masteravinashdubey/2022-SBR-Development/PPT Content/Design_V1.PNG

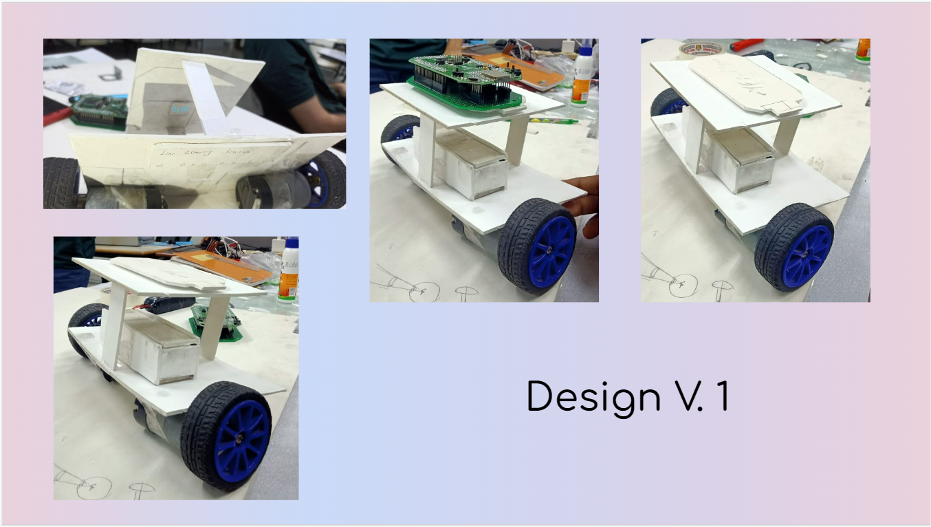
PPT Content/Design_V1.PNG
