masteravinashdubey/2022-SBR-Development/PPT Content/Design_V2.PNG

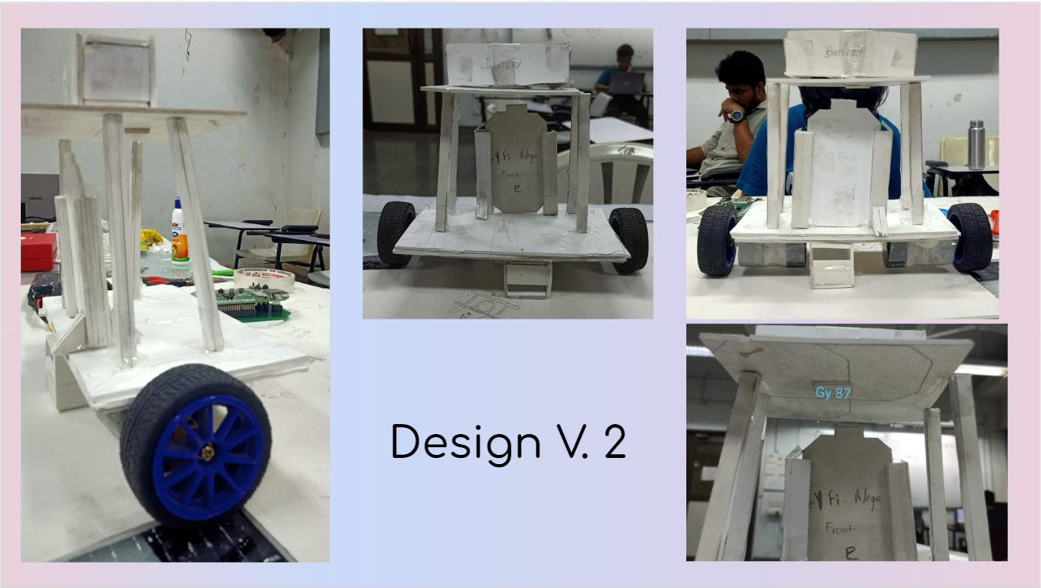
PPT Content/Design_V2.PNG
