masteravinashdubey/2022-SBR-Development/PPT Content/Design_V3.PNG

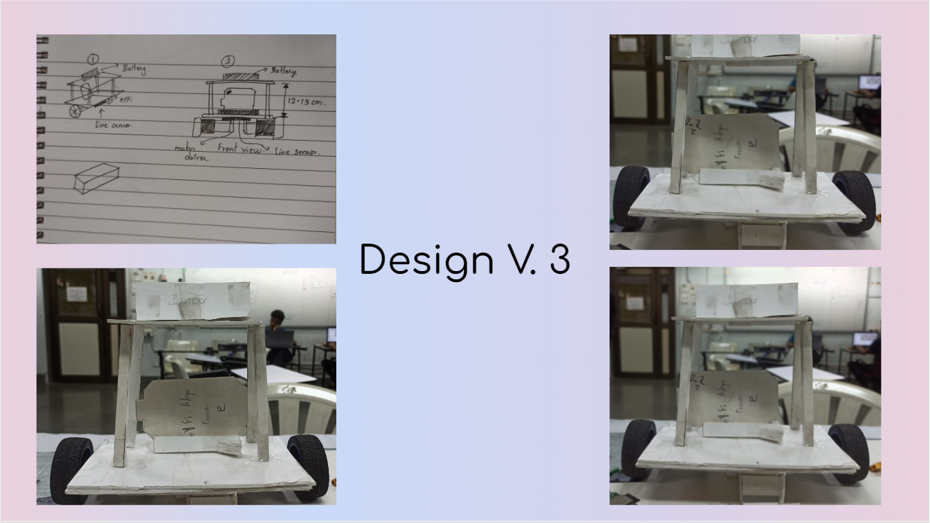
PPT Content/Design_V3.PNG
