masteravinashdubey/2022-SBR-Development/PPT Content/Design_V4.PNG

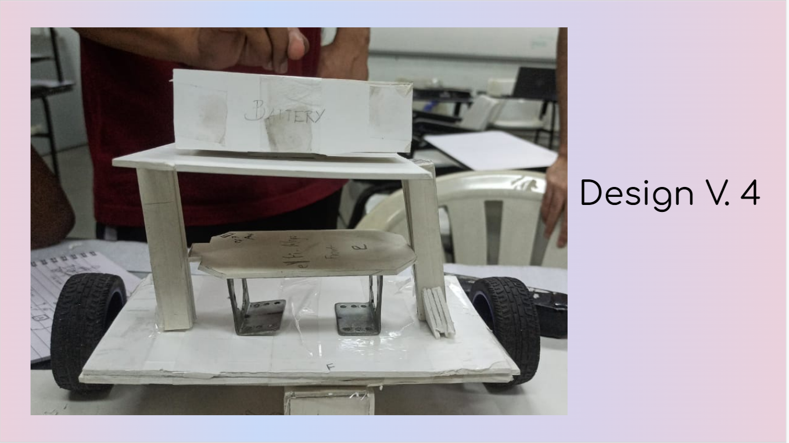
PPT Content/Design_V4.PNG
