masteravinashdubey/2022-SBR-Development/PPT Content/Design_V5.PNG

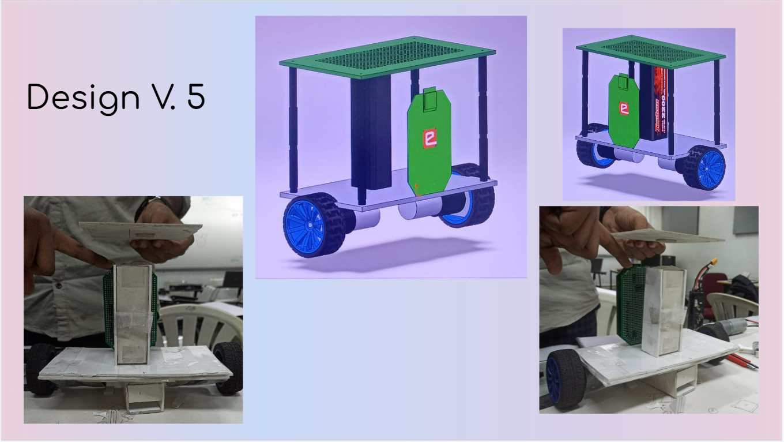
PPT Content/Design_V5.PNG
