masteravinashdubey/2022-SBR-Development/PPT Content/Design_V6.PNG

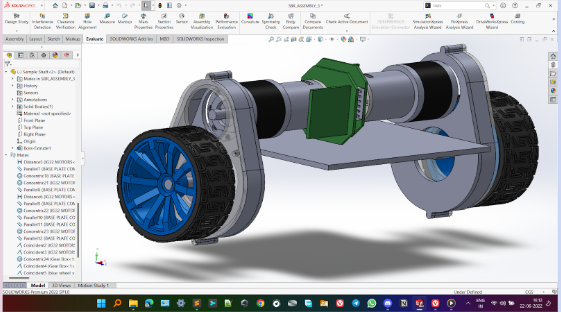
PPT Content/Design_V6.PNG
