masteravinashdubey/2022-SBR-Development/PPT Content/Design_V7.PNG

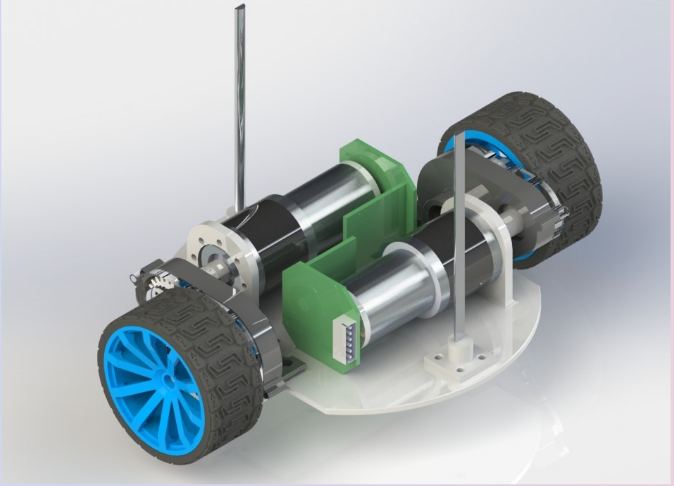
PPT Content/Design_V7.PNG
