masteravinashdubey/2022-SBR-Development/PPT Content/Final_1.png

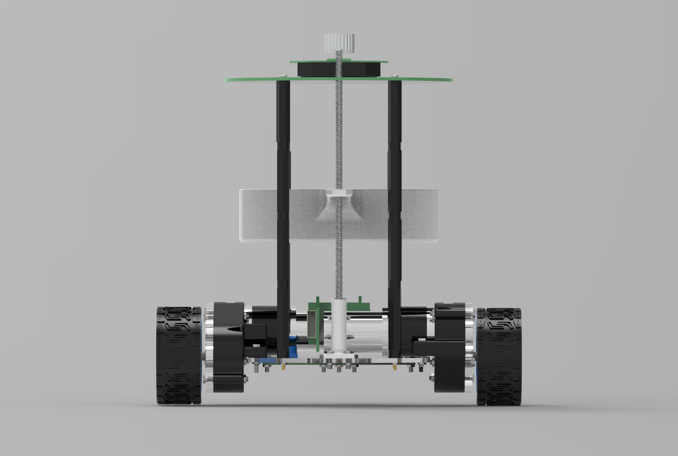
PPT Content/Final_1.png
