masteravinashdubey/2022-SBR-Development/PPT Content/Final_2.png

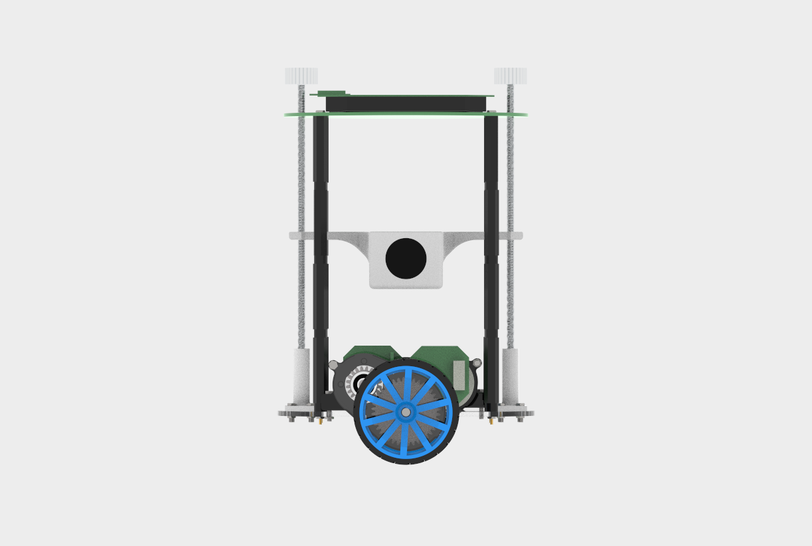
PPT Content/Final_2.png
