masteravinashdubey/2022-SBR-Development/PPT Content/Final_3.png

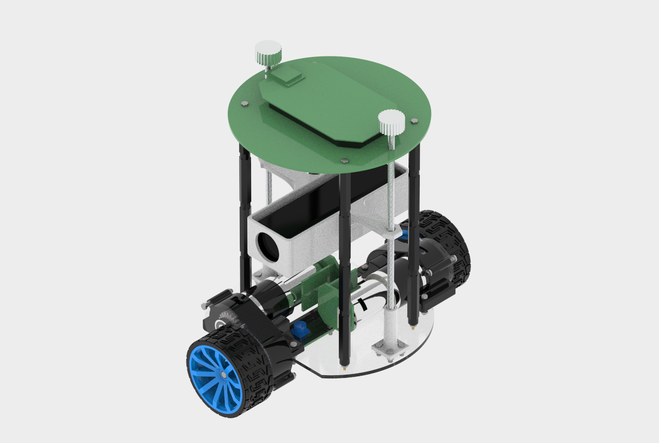
PPT Content/Final_3.png
