masteravinashdubey/2022-SBR-Development/PPT Content/Final_Alignment.PNG

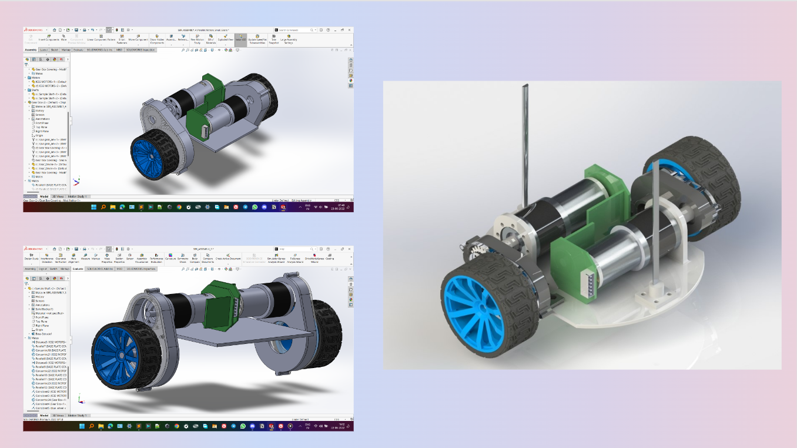
PPT Content/Final_Alignment.PNG
