masteravinashdubey/2022-SBR-Development/PPT Content/Gear_Box.jpeg

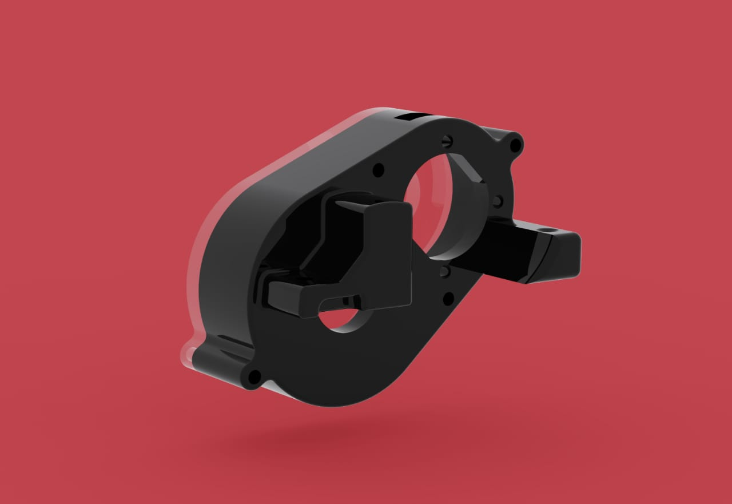
PPT Content/Gear_Box.jpeg
