masteravinashdubey/2022-SBR-Development/PPT Content/Interviews_observations.PNG

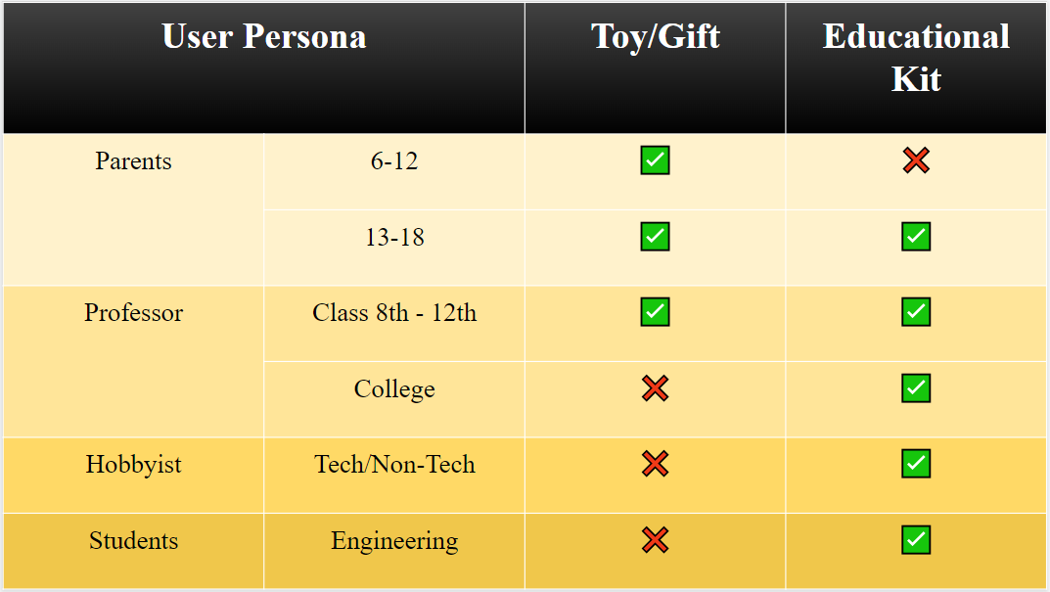
PPT Content/Interviews_observations.PNG
