masteravinashdubey/2022-SBR-Development/PPT Content/Render1.jpg

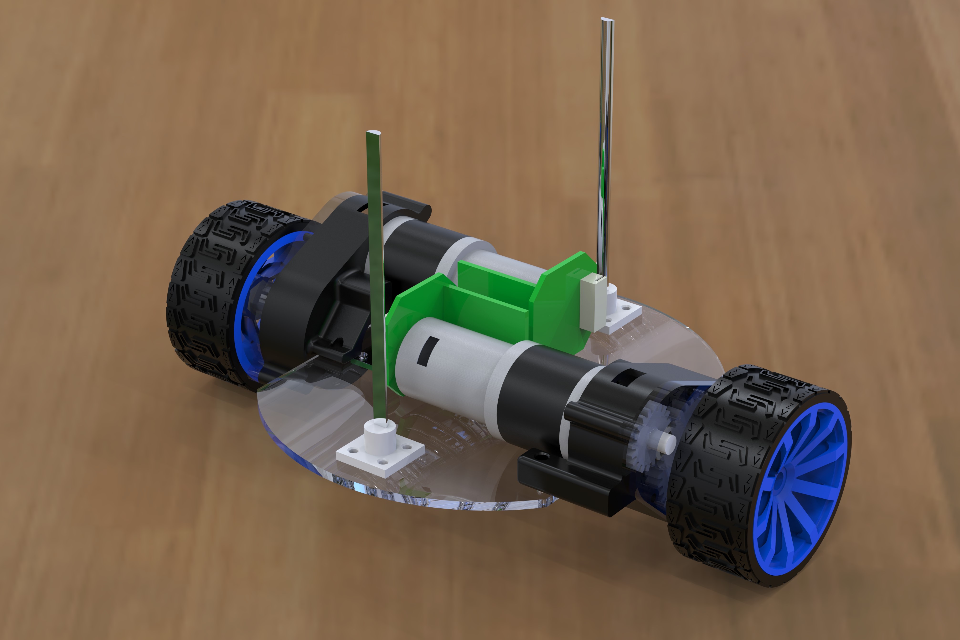
PPT Content/Render1.jpg
