masteravinashdubey/2022-SBR-Development/RENDERED/CASTLE HEAD/CastleHead.JPG

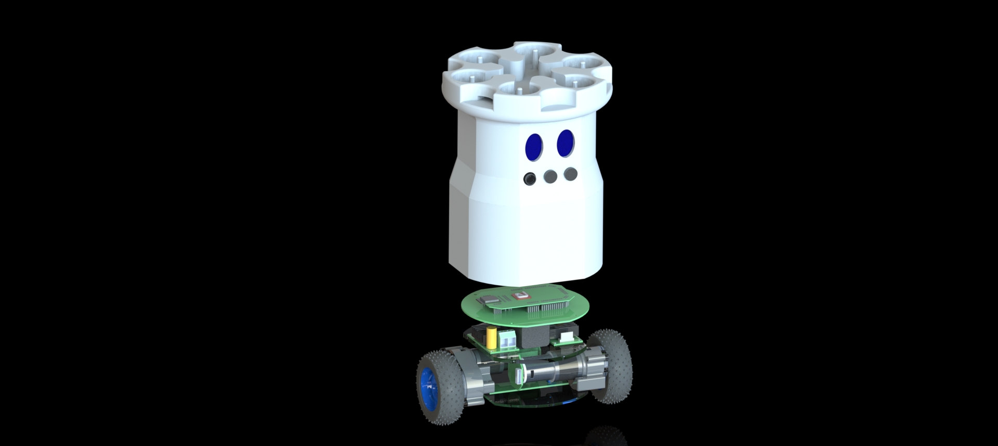
RENDERED/CASTLE HEAD/CastleHead.JPG
