masteravinashdubey/2022-SBR-Development/RENDERED/CASTLE HEAD/untitled.21.png

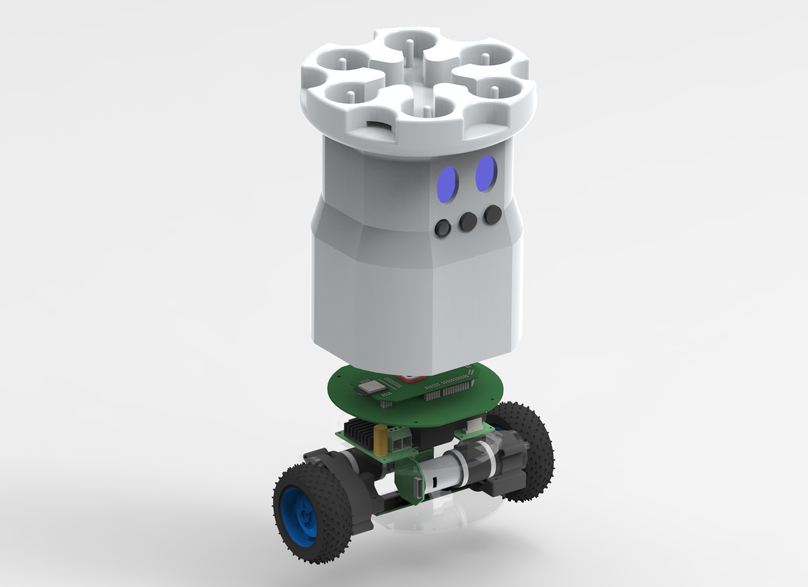
RENDERED/CASTLE HEAD/untitled.21.png
