masteravinashdubey/2022-SBR-Development/RENDERED/CASTLE HEAD/untitled.23.png

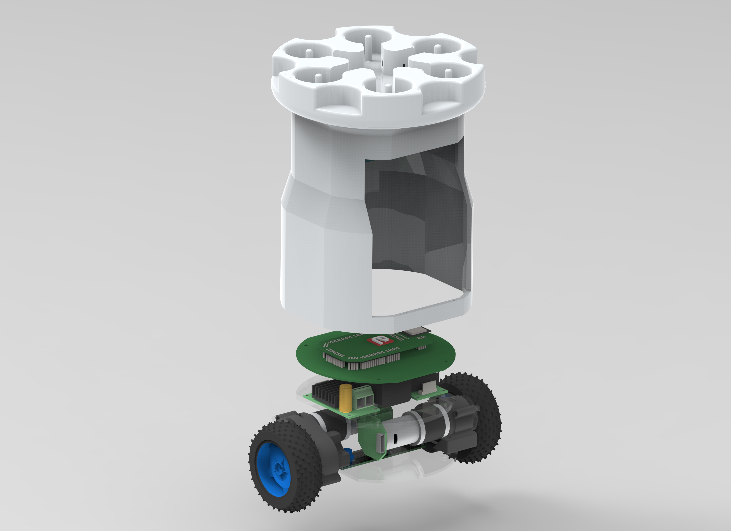
RENDERED/CASTLE HEAD/untitled.23.png
