masteravinashdubey/2022-SBR-Development/RENDERED/CASTLE HEAD/Untitled.JPG

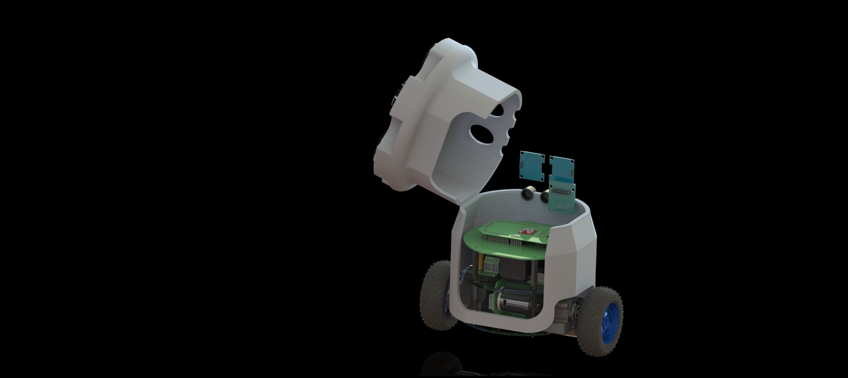
RENDERED/CASTLE HEAD/Untitled.JPG
