masteravinashdubey/2022-SBR-Development/RENDERED/COVER_1/2.png

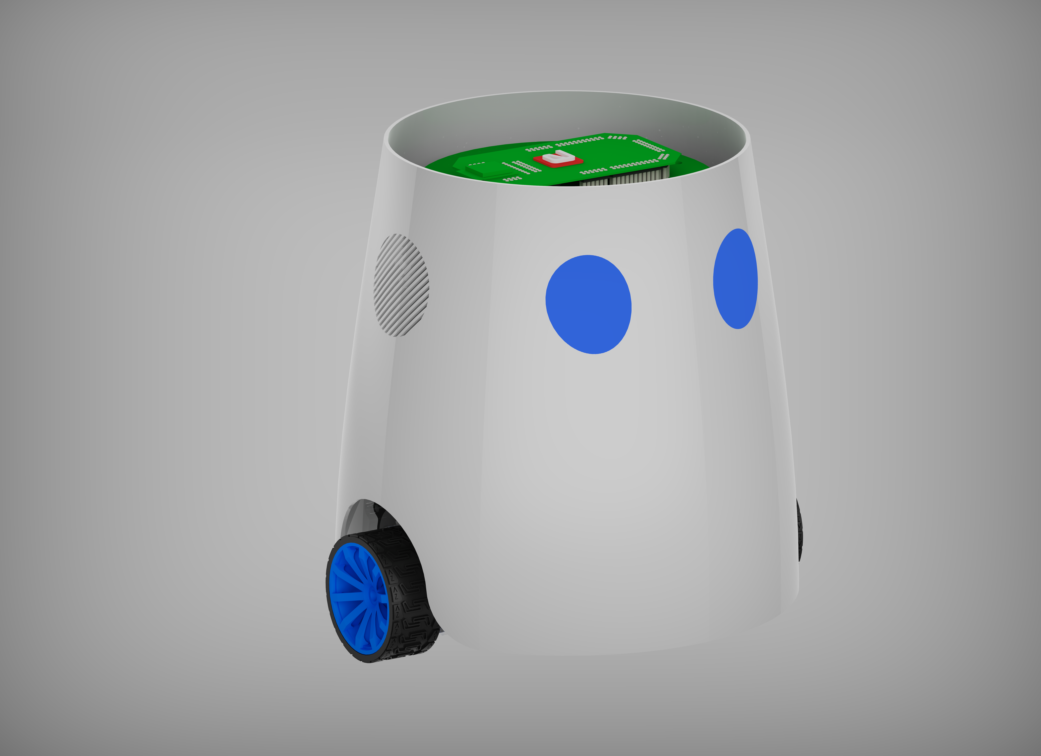
RENDERED/COVER_1/2.png
