masteravinashdubey/2022-SBR-Development/RENDERED/COVER_1/3.3.png

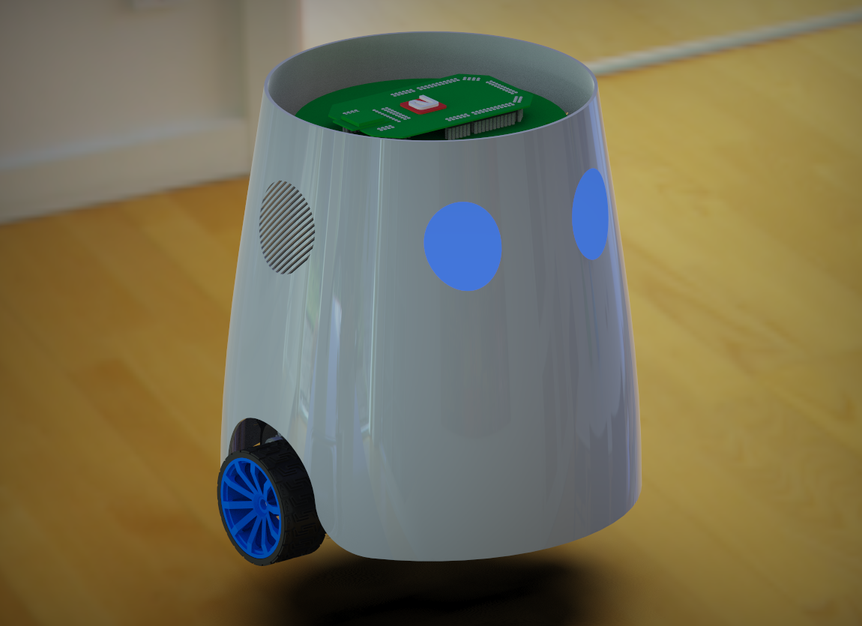
RENDERED/COVER_1/3.3.png
