masteravinashdubey/2022-SBR-Development/RENDERED/COVER_1/5.png

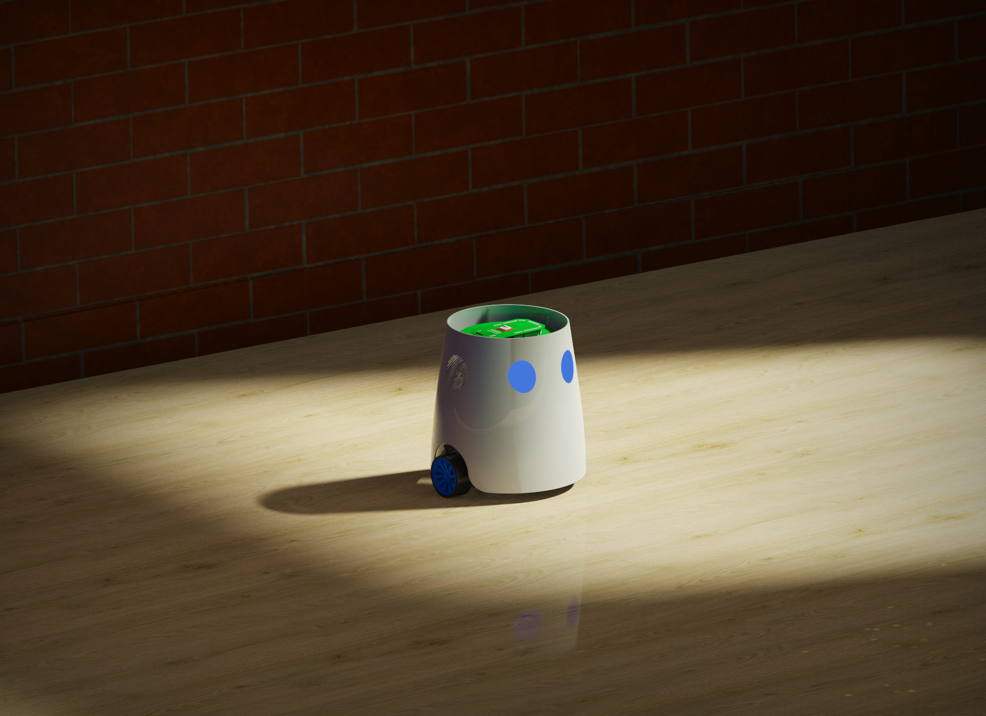
RENDERED/COVER_1/5.png
