masteravinashdubey/2022-SBR-Development/RENDERED/COVER_1/6.png

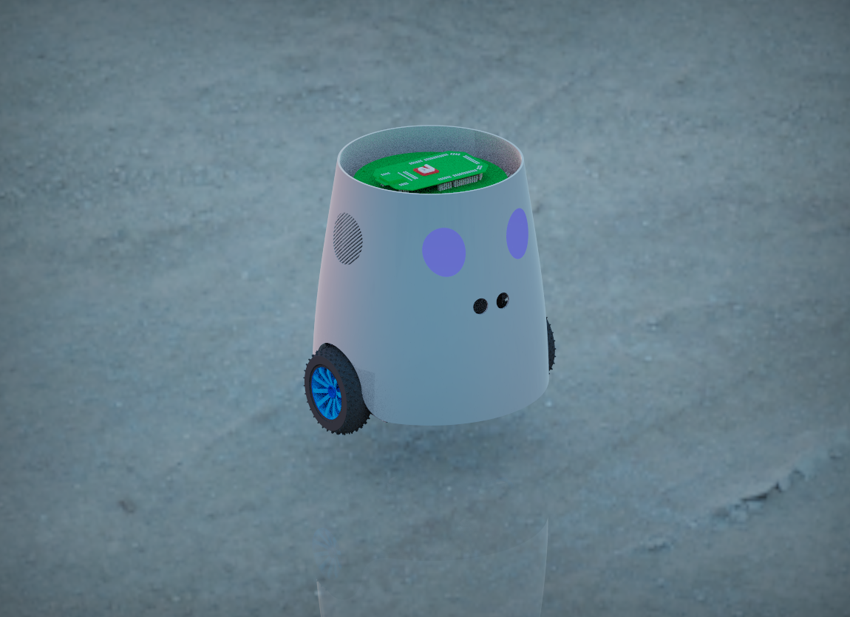
RENDERED/COVER_1/6.png
