masteravinashdubey/2022-SBR-Development/RENDERED/COVER_3/untitled.20.png

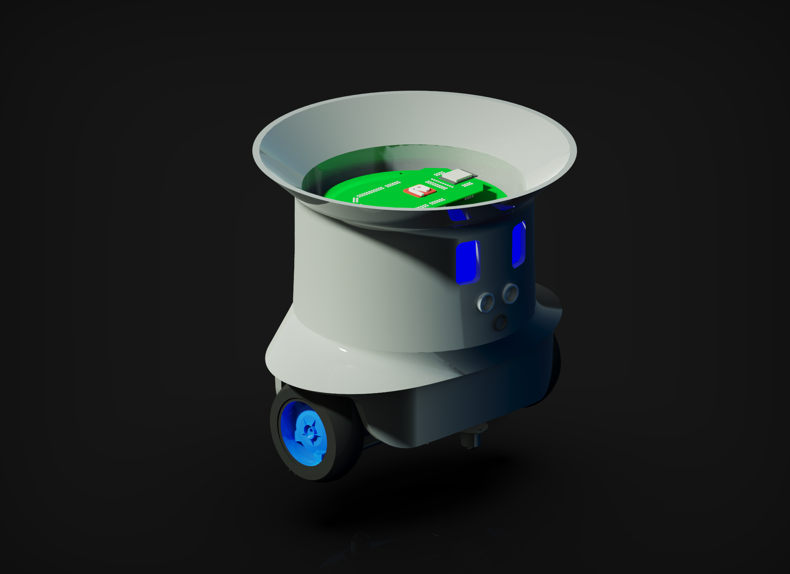
RENDERED/COVER_3/untitled.20.png
