masteravinashdubey/2022-SBR-Development/RENDERED/MISC/SBRV2.2.png

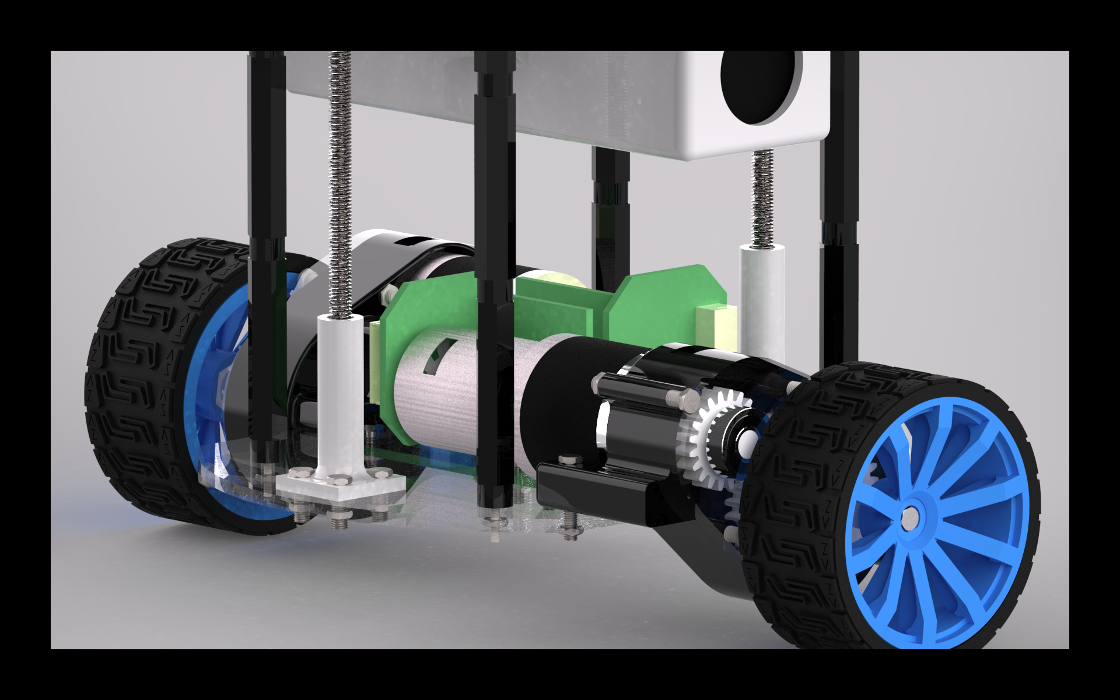
RENDERED/MISC/SBRV2.2.png
