masteravinashdubey/2022-SBR-Development/RENDERED/MISC/SBRV2.5.jpg

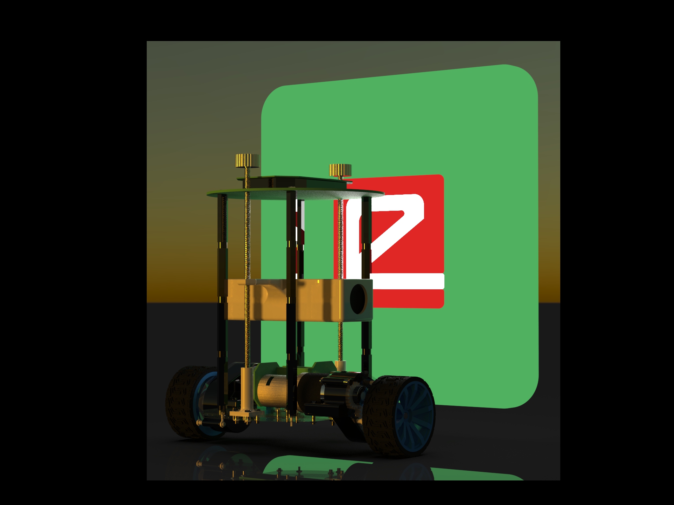
RENDERED/MISC/SBRV2.5.jpg
