masteravinashdubey/2022-SBR-Development/RENDERED/MISC/Untitled1.JPG

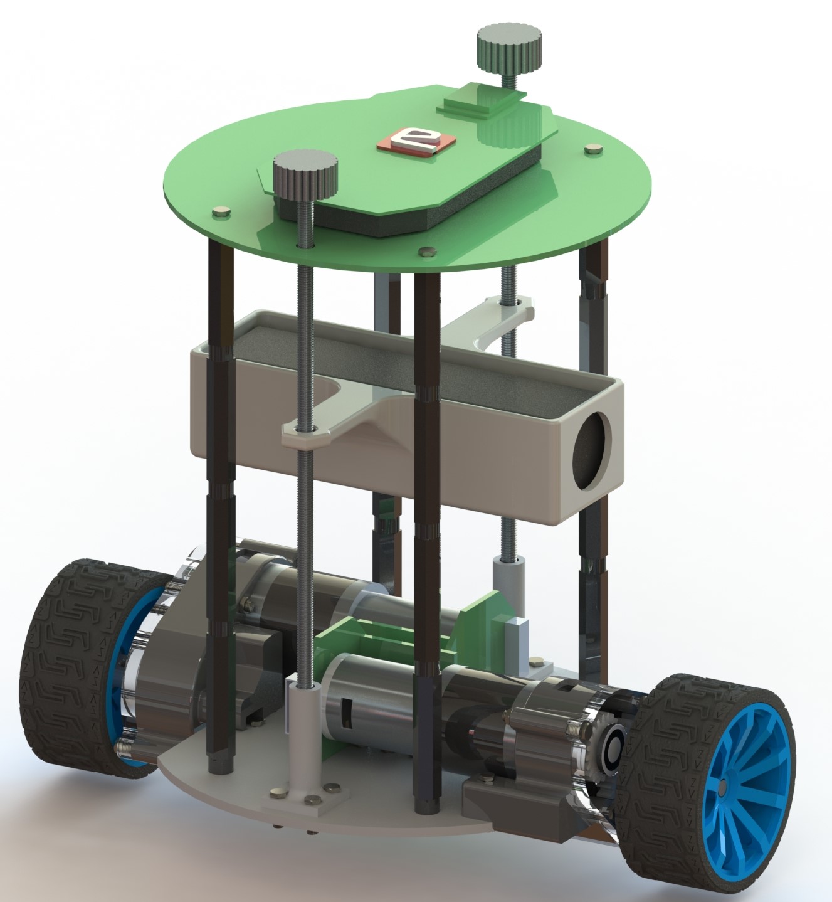
RENDERED/MISC/Untitled1.JPG
