masteravinashdubey/2022-SBR-Development/RENDERED/MISC/untitled.5.png

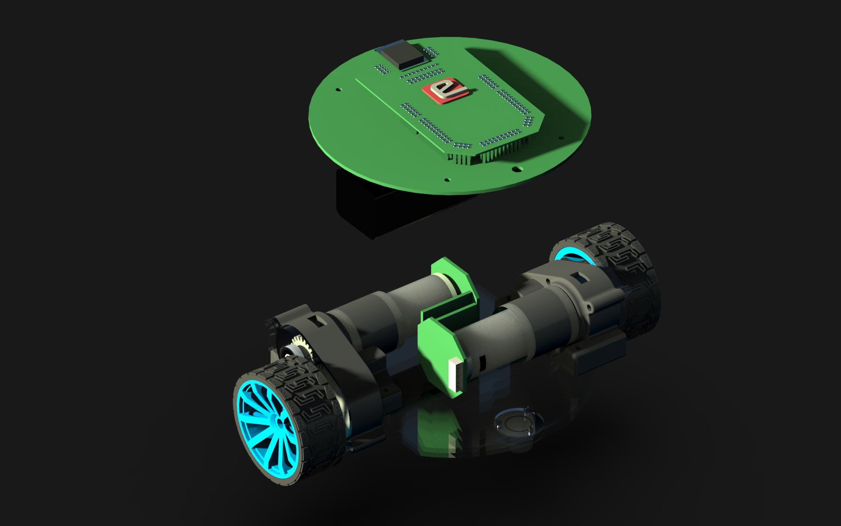
RENDERED/MISC/untitled.5.png
