masteravinashdubey/2022-SBR-Development/RENDERED/MISC/untitled.24.png

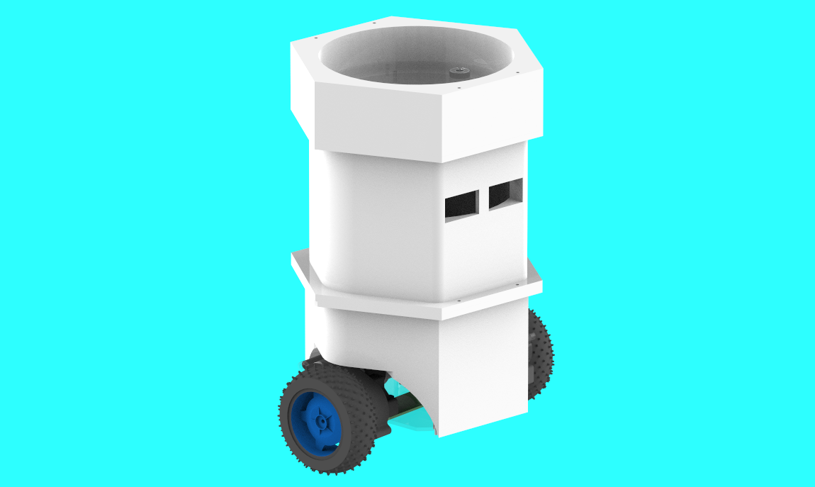
RENDERED/MISC/untitled.24.png
