masteravinashdubey/2022-SBR-Development/RENDERED/PARALLEL MOTORS/SBR_1.3.jpg

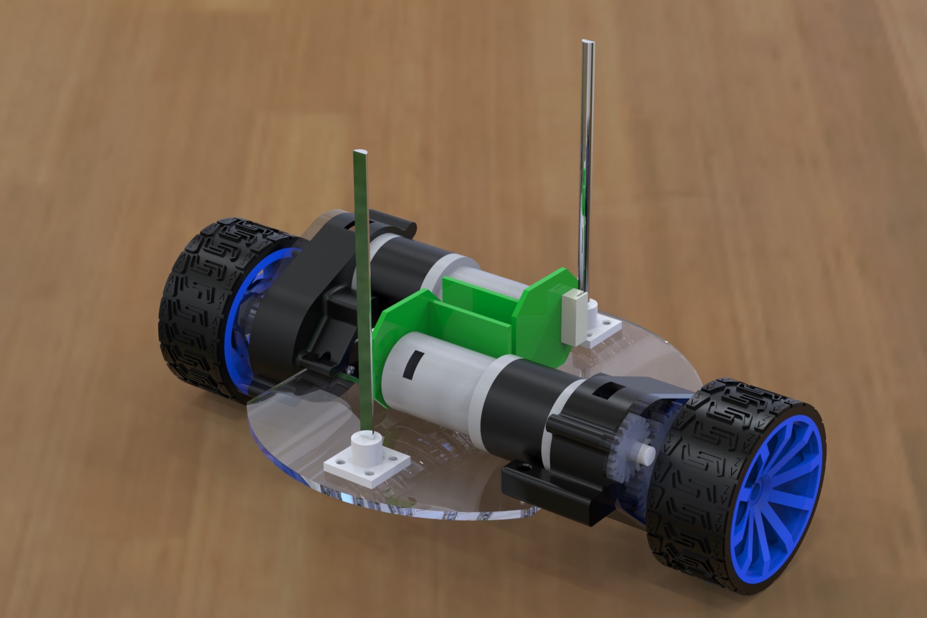
RENDERED/PARALLEL MOTORS/SBR_1.3.jpg
