masteravinashdubey/2022-SBR-Development/RENDERED/PARALLEL MOTORS/SBR_1.png

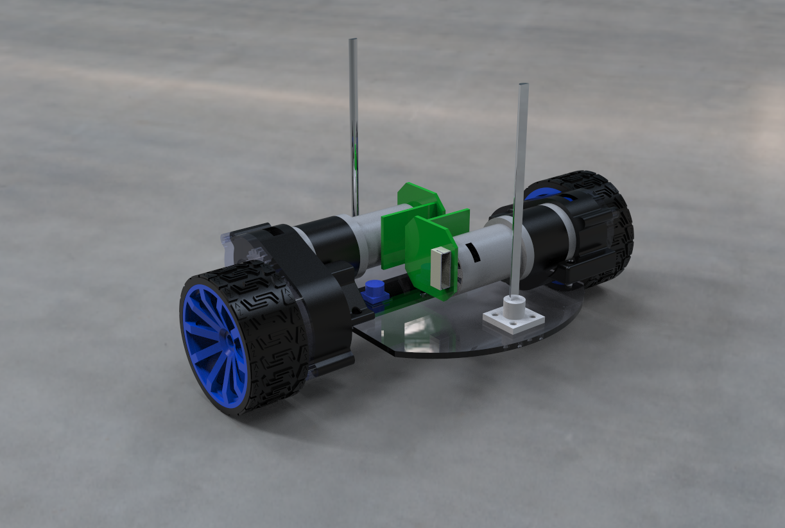
RENDERED/PARALLEL MOTORS/SBR_1.png
