masteravinashdubey/2022-SBR-Development/RENDERED/PARALLEL MOTORS/untitled.4.png

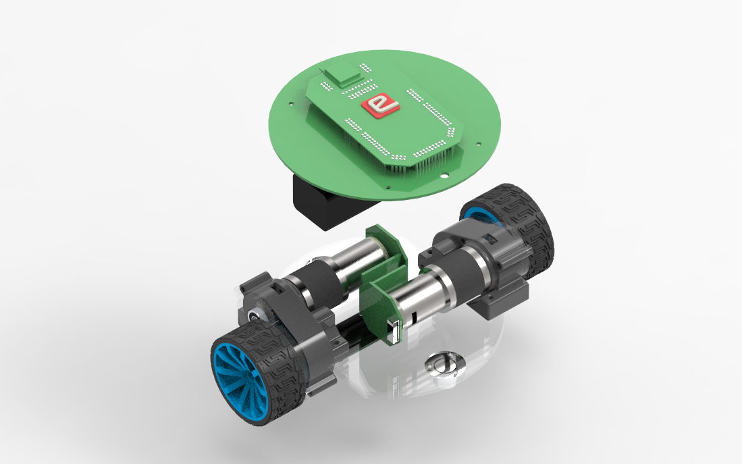
RENDERED/PARALLEL MOTORS/untitled.4.png
