masteravinashdubey/2022-SBR-Development/RENDERED/POSTER RENDERS/85mm wheel.png

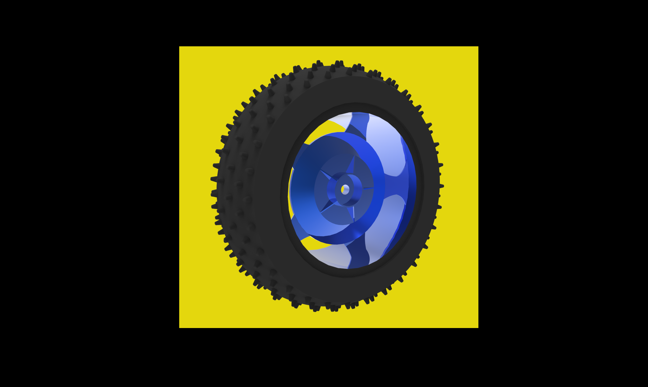
RENDERED/POSTER RENDERS/85mm wheel.png
