masteravinashdubey/2022-SBR-Development/RENDERED/POSTER RENDERS/BATTERY.png

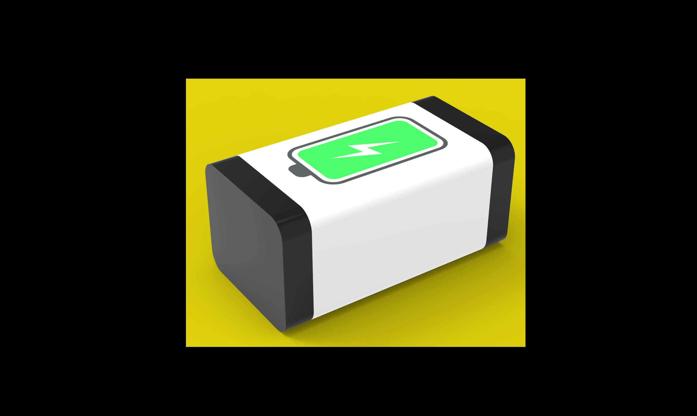
RENDERED/POSTER RENDERS/BATTERY.png
