masteravinashdubey/2022-SBR-Development/RENDERED/POSTER RENDERS/Bearing.png

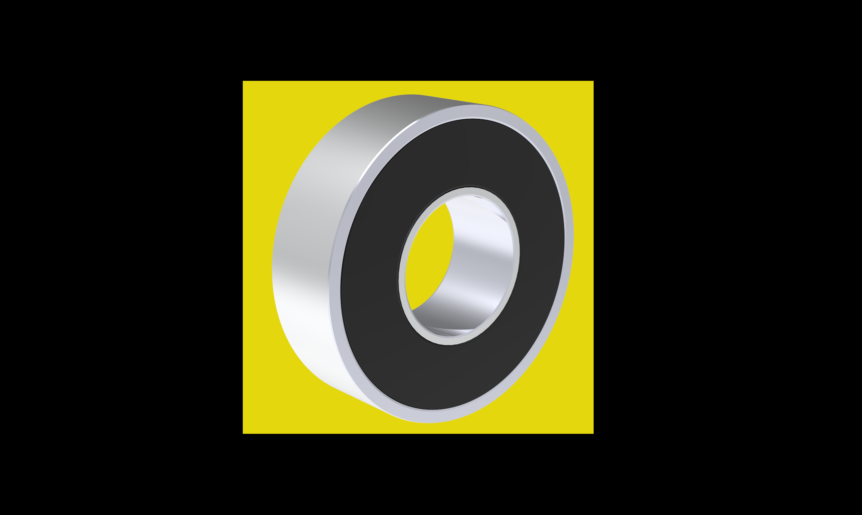
RENDERED/POSTER RENDERS/Bearing.png
