masteravinashdubey/2022-SBR-Development/RENDERED/POSTER RENDERS/BOT/SBR_FINAL.30.png

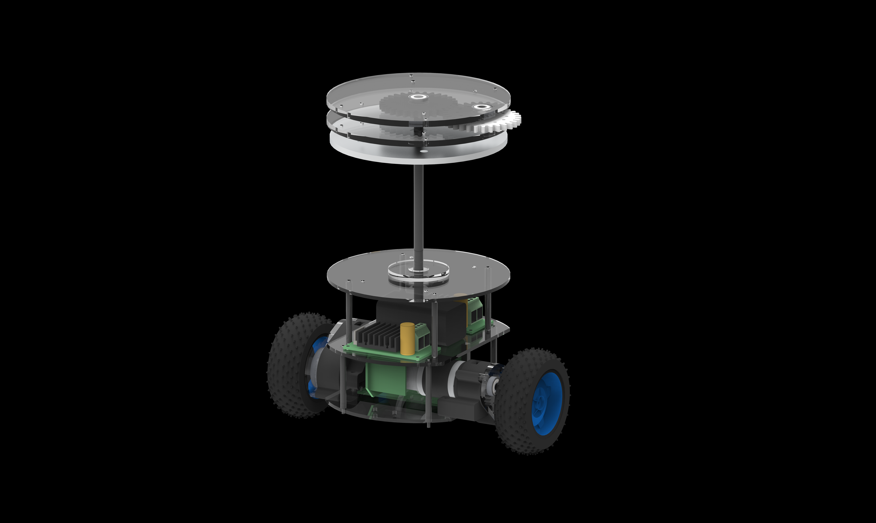
RENDERED/POSTER RENDERS/BOT/SBR_FINAL.30.png
