masteravinashdubey/2022-SBR-Development/RENDERED/POSTER RENDERS/BOT/untitled.25.png

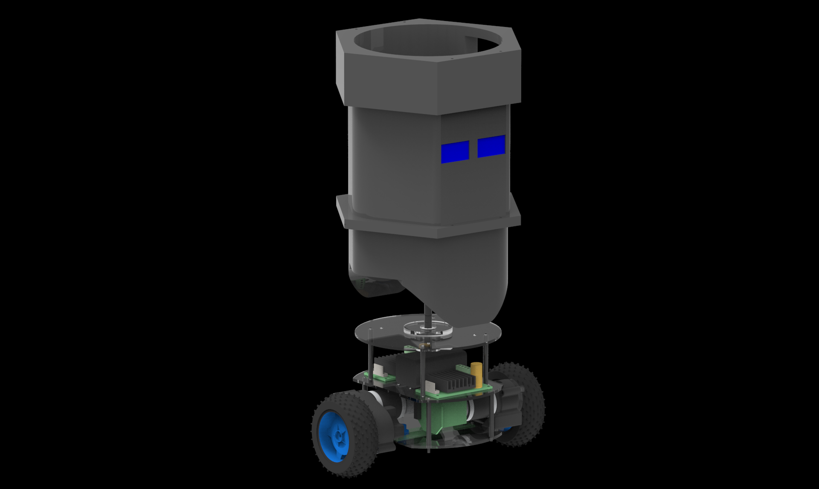
RENDERED/POSTER RENDERS/BOT/untitled.25.png
