masteravinashdubey/2022-SBR-Development/RENDERED/POSTER RENDERS/BOT/untitled.26.png

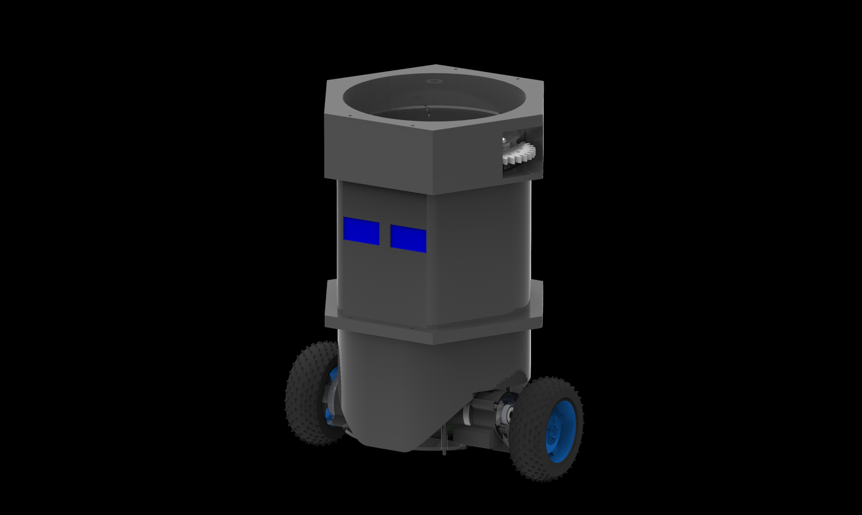
RENDERED/POSTER RENDERS/BOT/untitled.26.png
