masteravinashdubey/2022-SBR-Development/RENDERED/POSTER RENDERS/BOT/untitled.27.png

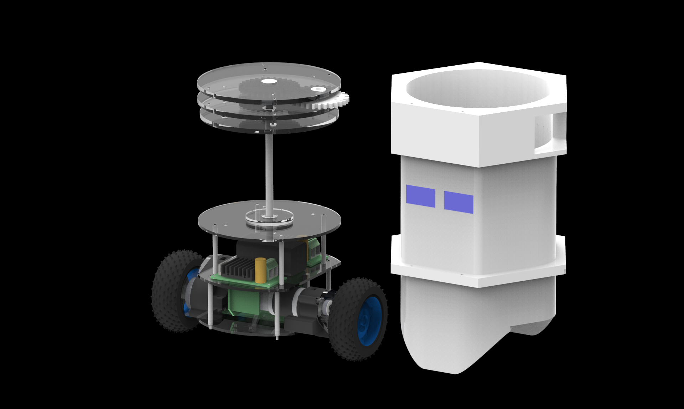
RENDERED/POSTER RENDERS/BOT/untitled.27.png
