masteravinashdubey/2022-SBR-Development/RENDERED/POSTER RENDERS/BOT/untitled.49.png

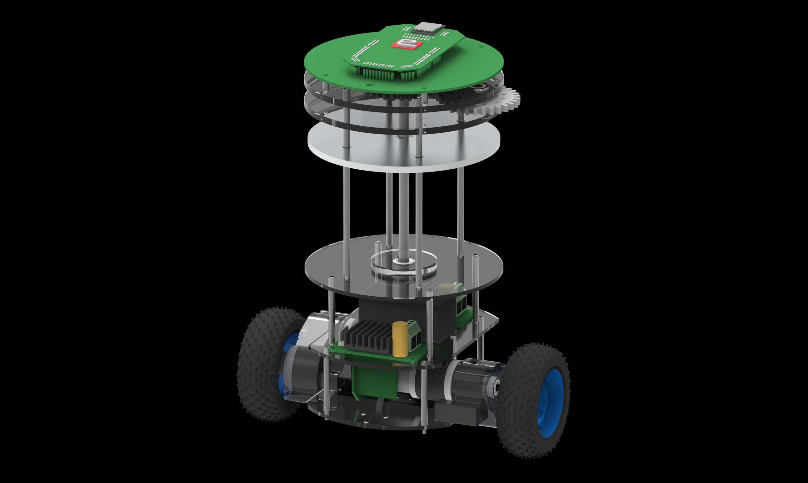
RENDERED/POSTER RENDERS/BOT/untitled.49.png
