masteravinashdubey/2022-SBR-Development/RENDERED/POSTER RENDERS/BOT/untitled.53.png

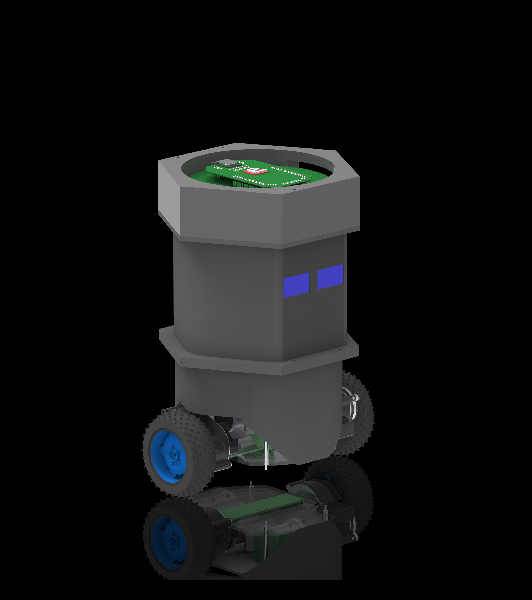
RENDERED/POSTER RENDERS/BOT/untitled.53.png
