masteravinashdubey/2022-SBR-Development/RENDERED/POSTER RENDERS/CAMERA.png

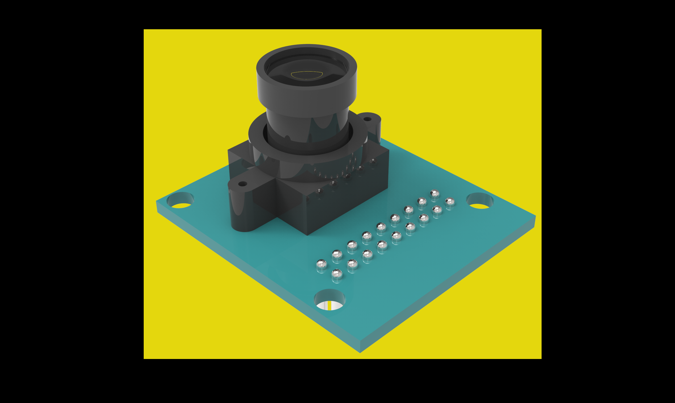
RENDERED/POSTER RENDERS/CAMERA.png
