masteravinashdubey/2022-SBR-Development/RENDERED/POSTER RENDERS/CASTOR.png

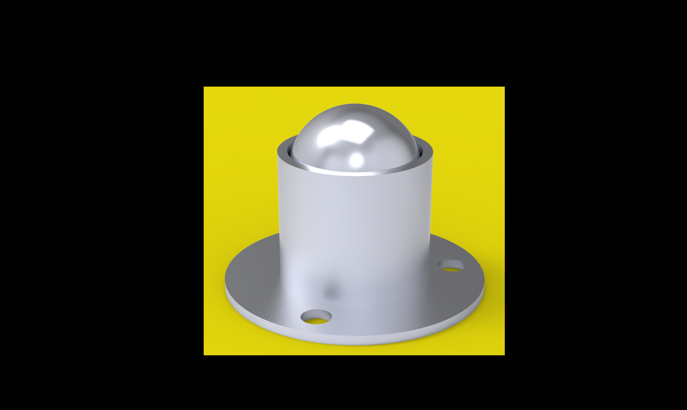
RENDERED/POSTER RENDERS/CASTOR.png
