masteravinashdubey/2022-SBR-Development/RENDERED/POSTER RENDERS/DEADWEIGHT.png

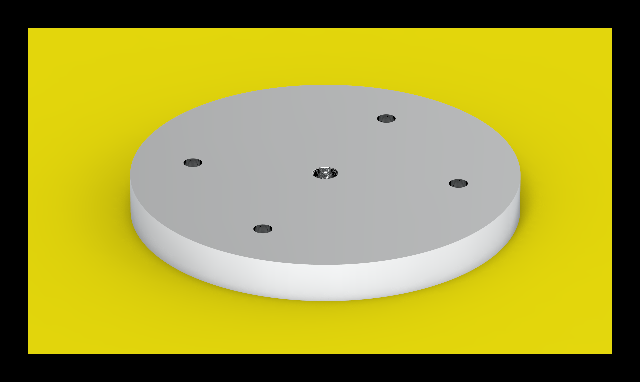
RENDERED/POSTER RENDERS/DEADWEIGHT.png
