masteravinashdubey/2022-SBR-Development/RENDERED/POSTER RENDERS/EYFI.png

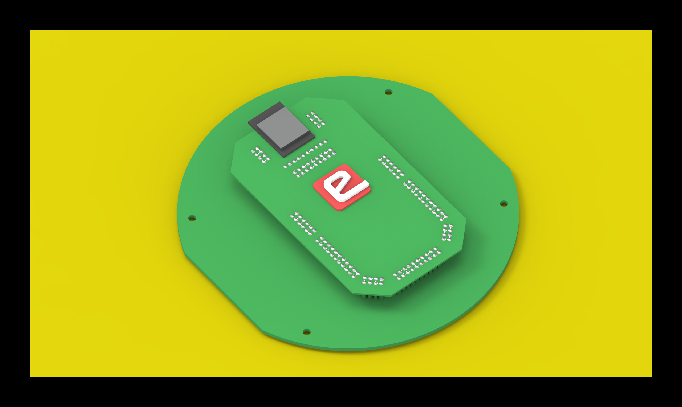
RENDERED/POSTER RENDERS/EYFI.png
