masteravinashdubey/2022-SBR-Development/RENDERED/POSTER RENDERS/GEAR_DRIVEN_LARGE.png

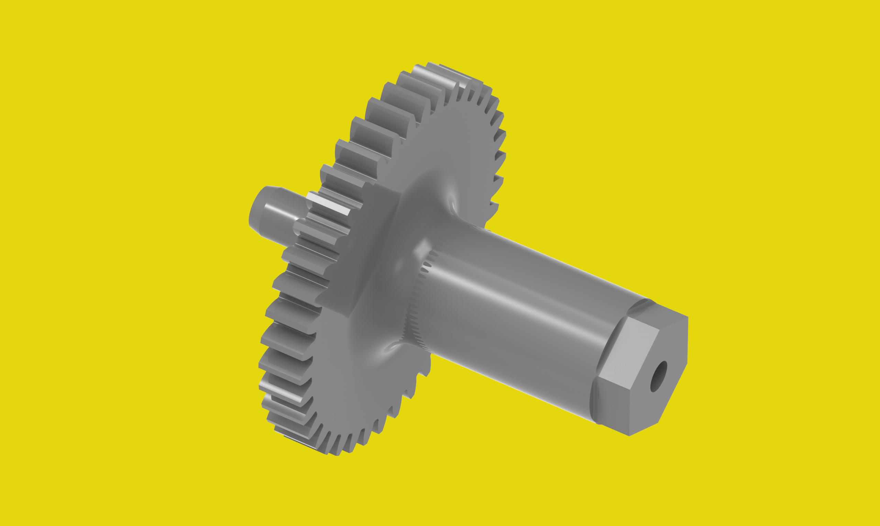
RENDERED/POSTER RENDERS/GEAR_DRIVEN_LARGE.png
