masteravinashdubey/2022-SBR-Development/RENDERED/POSTER RENDERS/GEAR_DRIVER.png

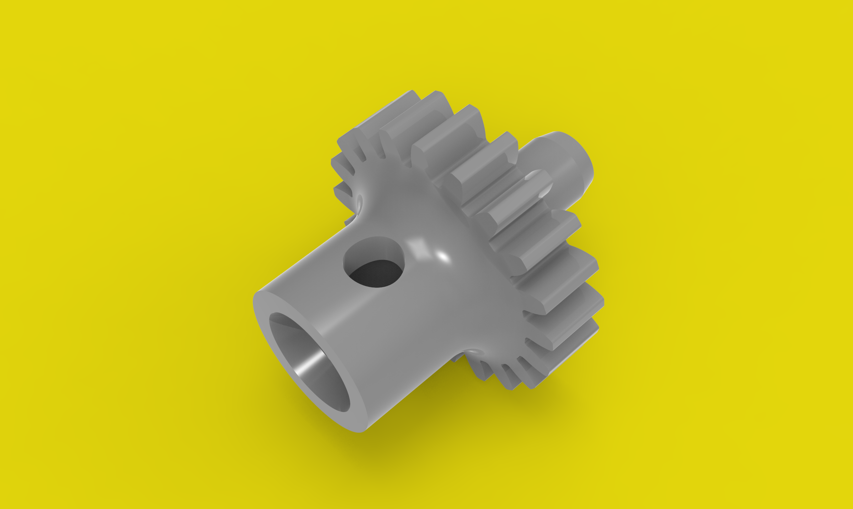
RENDERED/POSTER RENDERS/GEAR_DRIVER.png
