masteravinashdubey/2022-SBR-Development/RENDERED/POSTER RENDERS/GEARBOX.png

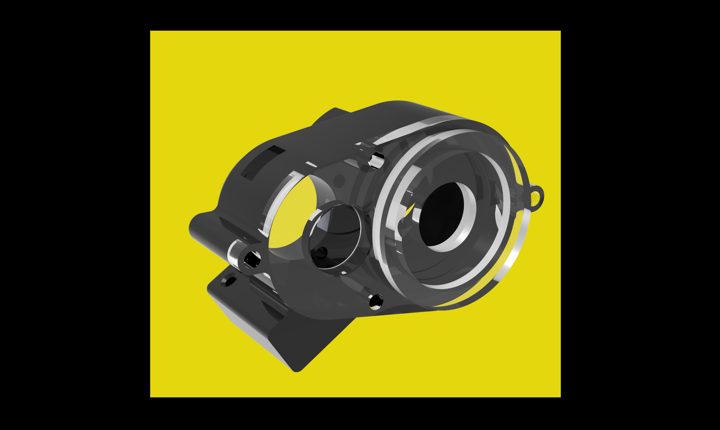
RENDERED/POSTER RENDERS/GEARBOX.png
