masteravinashdubey/2022-SBR-Development/RENDERED/POSTER RENDERS/HERCULES.png

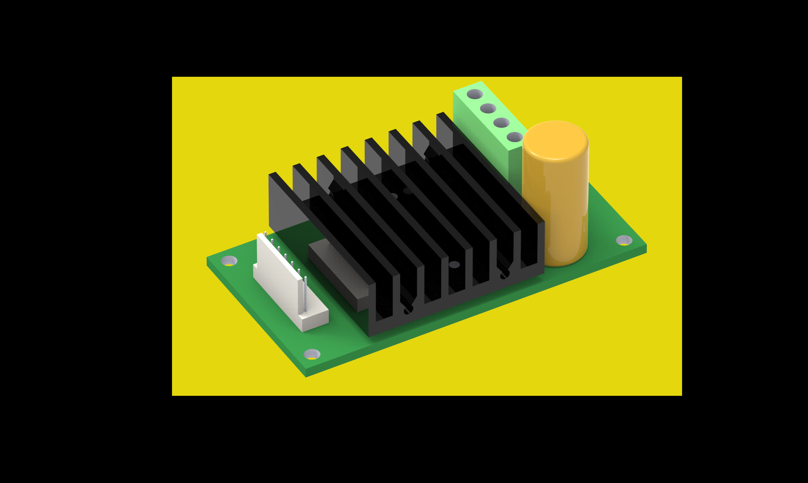
RENDERED/POSTER RENDERS/HERCULES.png
