masteravinashdubey/2022-SBR-Development/RENDERED/POSTER RENDERS/LINE SENSOR.png

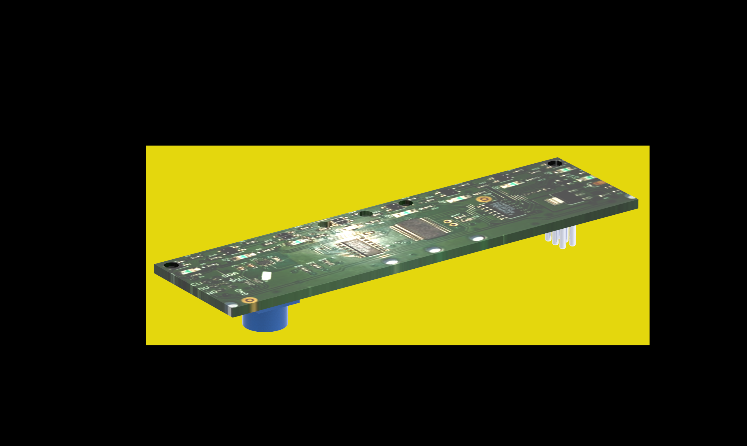
RENDERED/POSTER RENDERS/LINE SENSOR.png
