masteravinashdubey/2022-SBR-Development/RENDERED/POSTER RENDERS/MOTOR.png

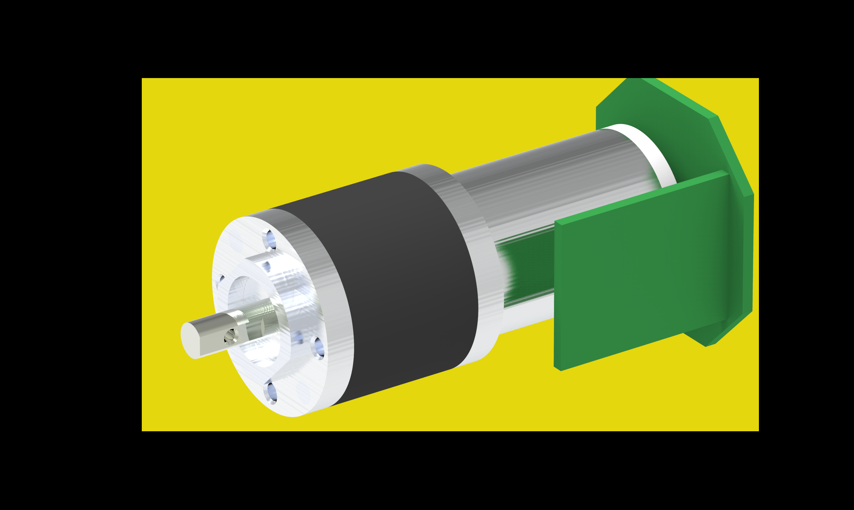
RENDERED/POSTER RENDERS/MOTOR.png
