masteravinashdubey/2022-SBR-Development/RENDERED/POSTER RENDERS/OLDE1.png

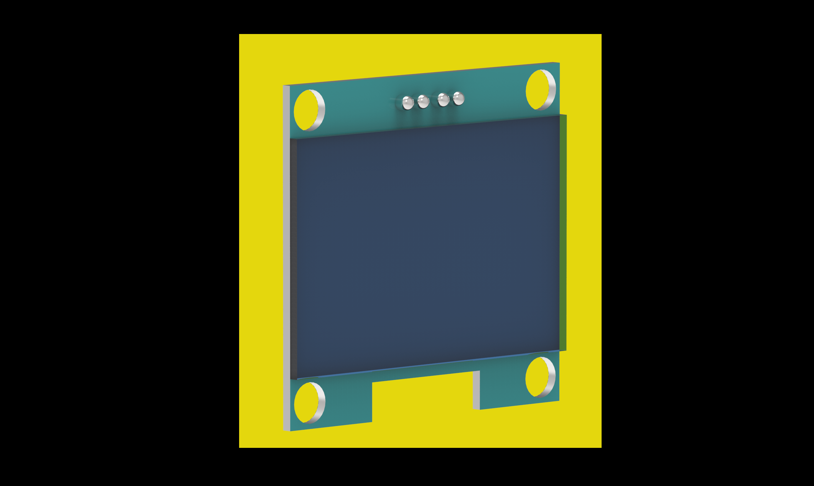
RENDERED/POSTER RENDERS/OLDE1.png
