masteravinashdubey/2022-SBR-Development/RENDERED/POSTER RENDERS/OLED2.png

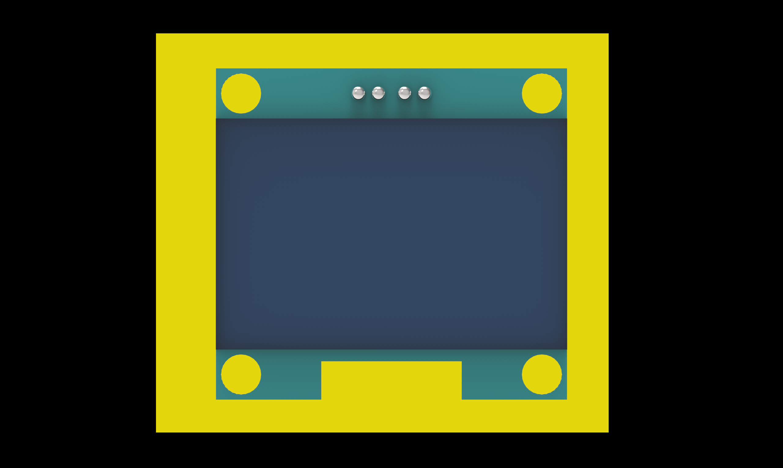
RENDERED/POSTER RENDERS/OLED2.png
