masteravinashdubey/2022-SBR-Development/Report/ATTACHING BEARING TO PLATE_3.png

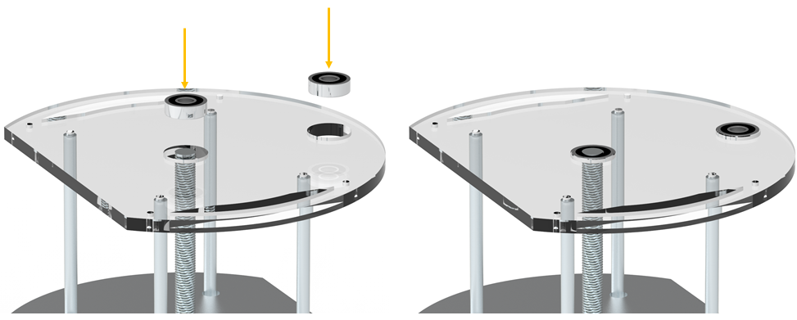
Report/ATTACHING BEARING TO PLATE_3.png
