masteravinashdubey/2022-SBR-Development/Report/ATTACHING PLATE_2.png

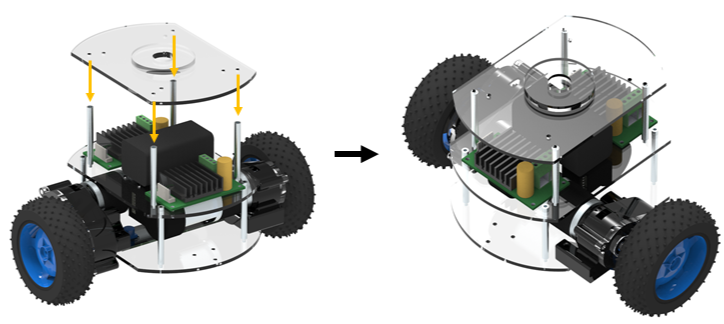
Report/ATTACHING PLATE_2.png
