masteravinashdubey/2022-SBR-Development/Report/ATTACHING PLATE_3(2) AND BEARINGS.png

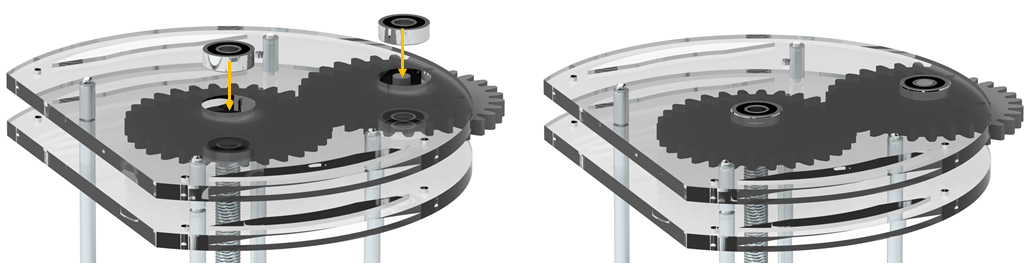
Report/ATTACHING PLATE_3(2) AND BEARINGS.png
