masteravinashdubey/2022-SBR-Development/Report/BASEPLATE ISO.196.png

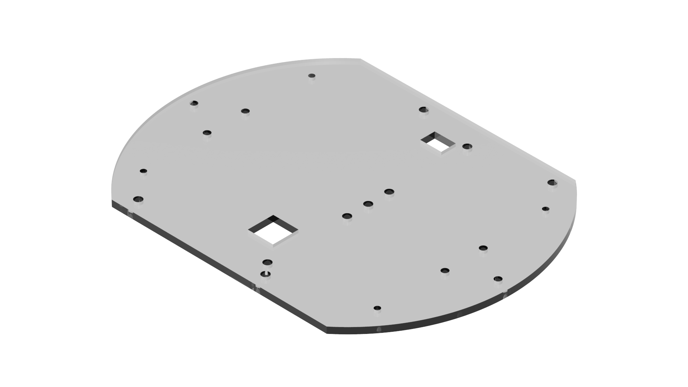
Report/BASEPLATE ISO.196.png
