masteravinashdubey/2022-SBR-Development/Report/BASEPLATE TOP.195.png

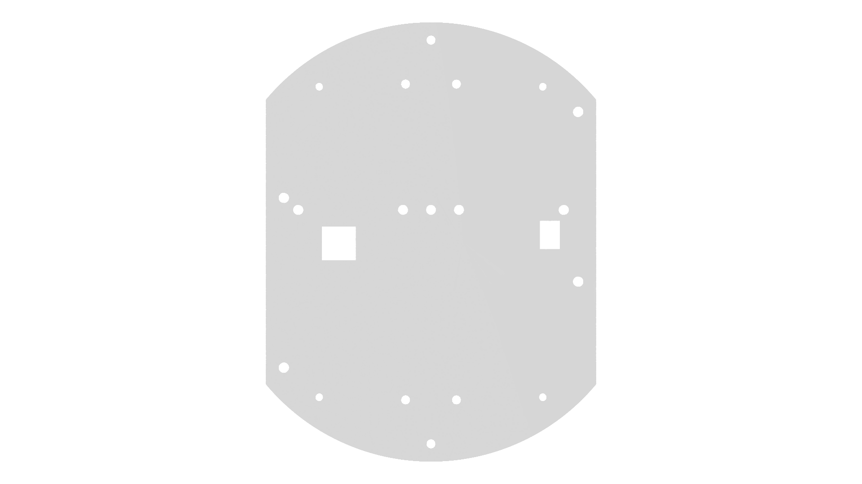
Report/BASEPLATE TOP.195.png
