masteravinashdubey/2022-SBR-Development/Report/BATTERY ISO.251.png

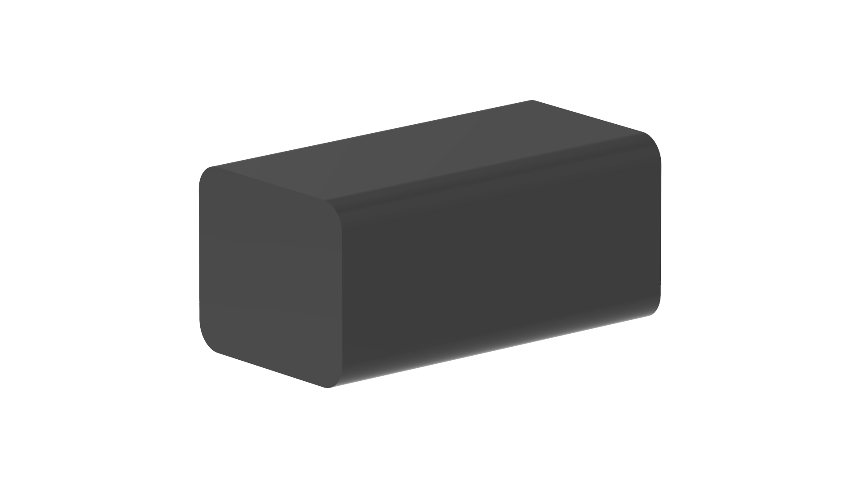
Report/BATTERY ISO.251.png
