masteravinashdubey/2022-SBR-Development/Report/BATTERY TOP.252.png

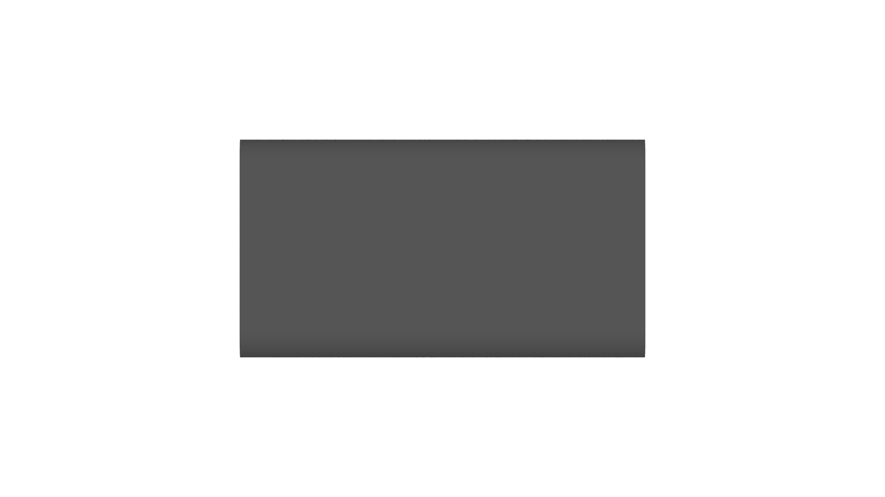
Report/BATTERY TOP.252.png
