masteravinashdubey/2022-SBR-Development/Report/CAM FRONT.189.png

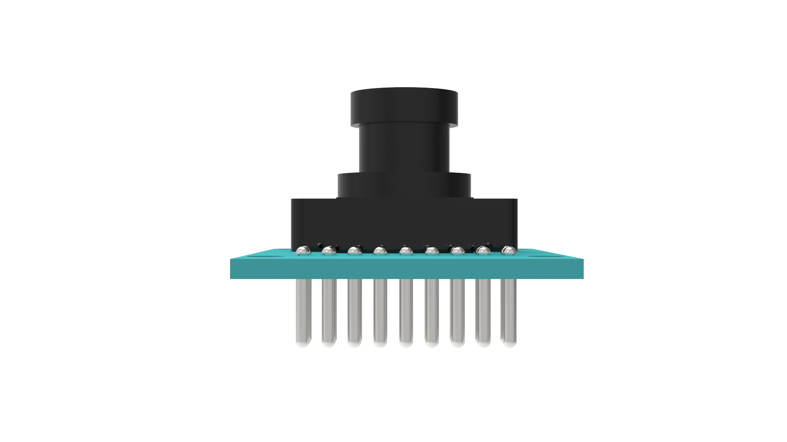
Report/CAM FRONT.189.png
