masteravinashdubey/2022-SBR-Development/Report/CAM ISO.188.png

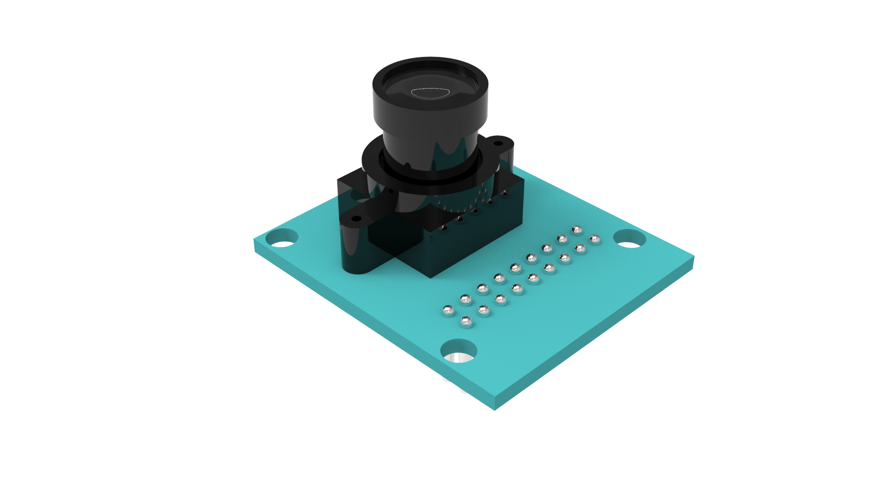
Report/CAM ISO.188.png
