masteravinashdubey/2022-SBR-Development/Report/CAM SIDE.190.png

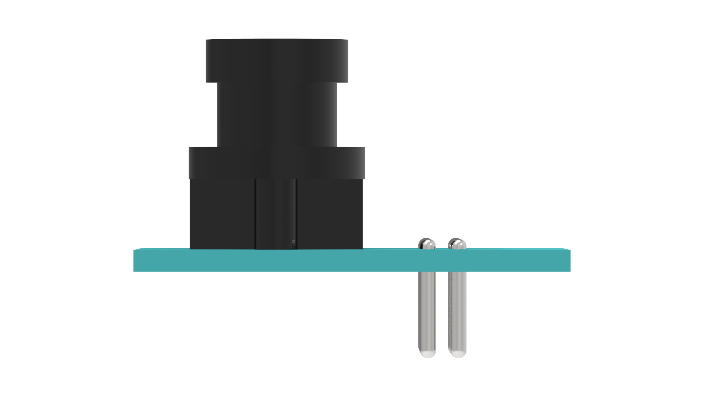
Report/CAM SIDE.190.png
