masteravinashdubey/2022-SBR-Development/Report/CAM TOP.191.png

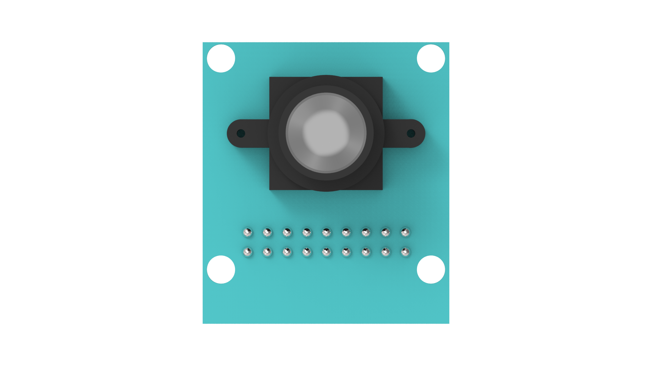
Report/CAM TOP.191.png
