masteravinashdubey/2022-SBR-Development/Report/CASTOR FRONT.202.png

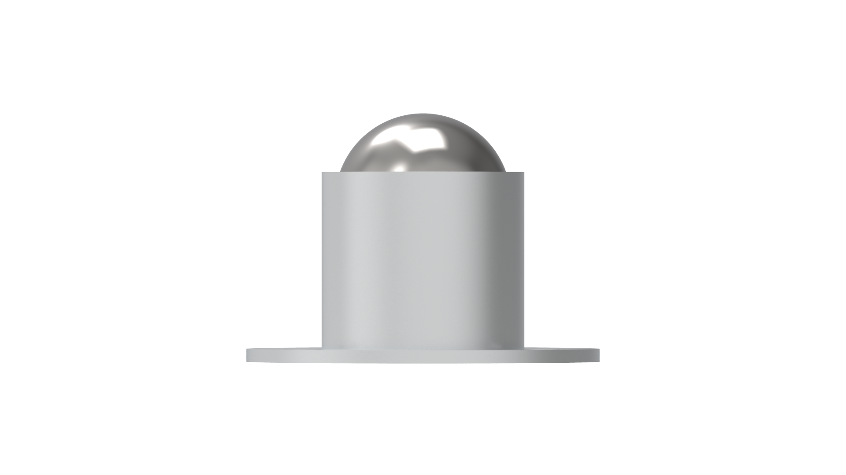
Report/CASTOR FRONT.202.png
