masteravinashdubey/2022-SBR-Development/Report/CASTOR ISO.204.png

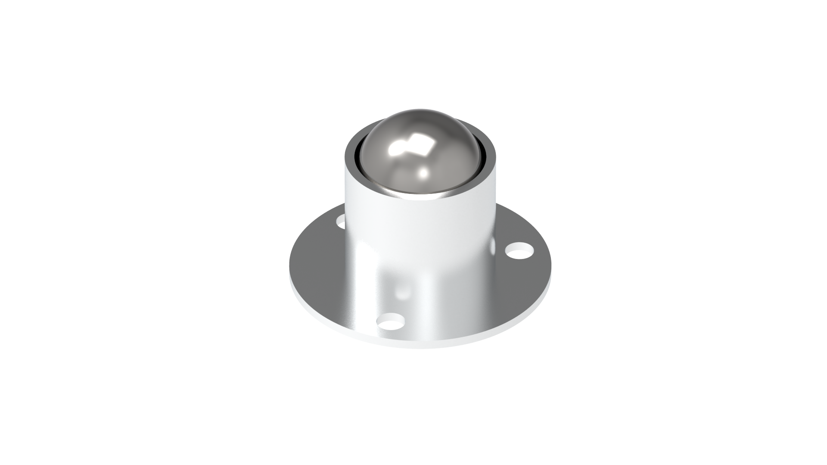
Report/CASTOR ISO.204.png
