masteravinashdubey/2022-SBR-Development/Report/PLATE_1 MARKED.png

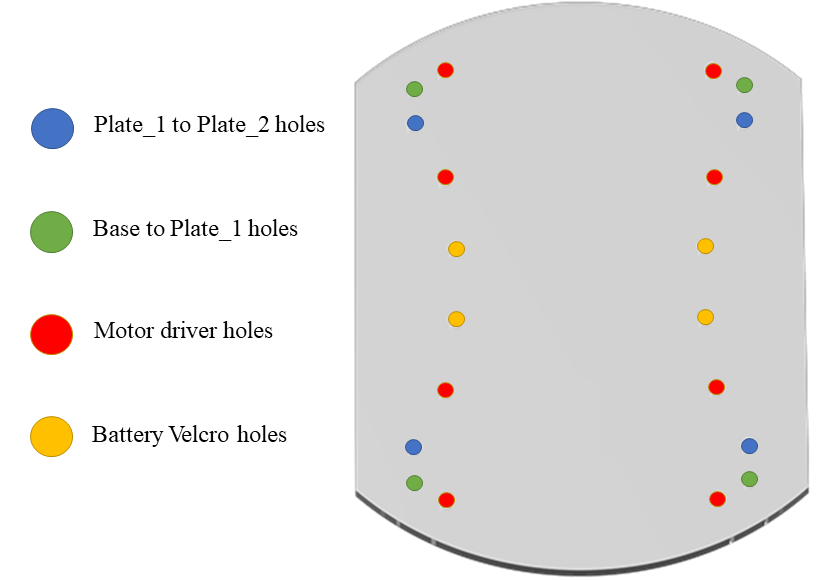
Report/PLATE_1 MARKED.png
