masteravinashdubey/2022-SBR-Development/PPT Content/Components_1.PNG

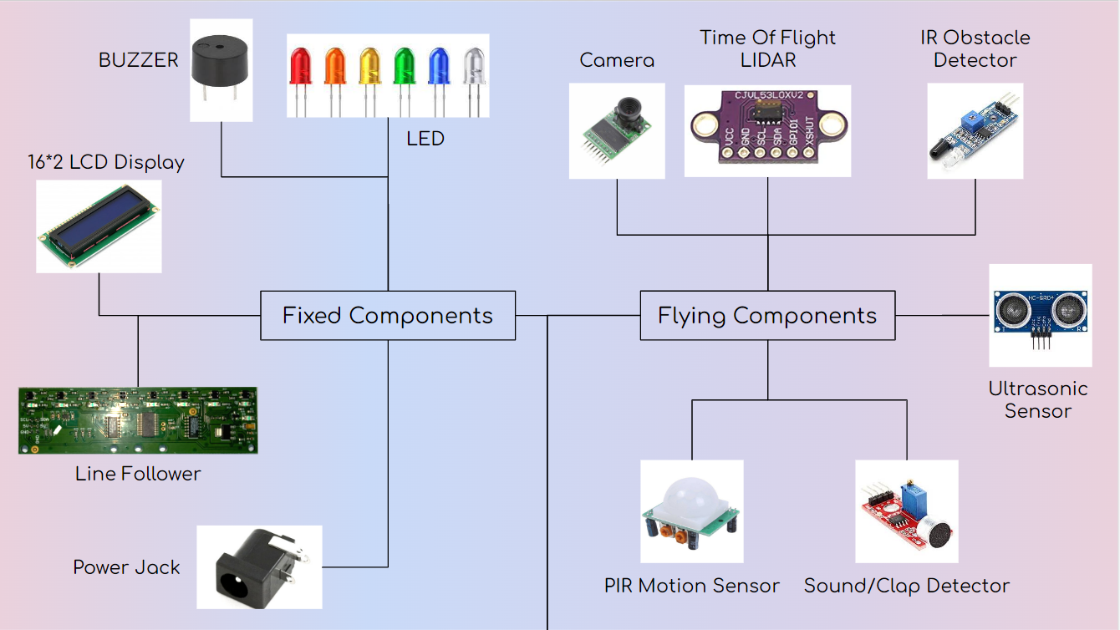
PPT Content/Components_1.PNG
