masteravinashdubey/2022-SBR-Development/PPT Content/Components_2.PNG

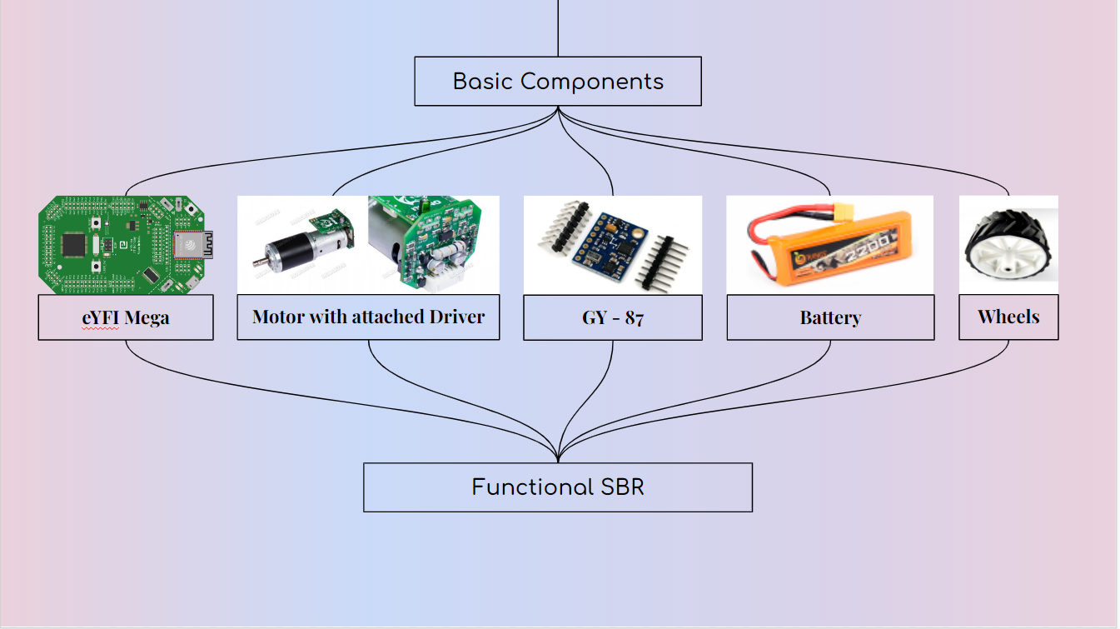
PPT Content/Components_2.PNG
