masteravinashdubey/2022-SBR-Development/PPT Content/Components_selected.PNG

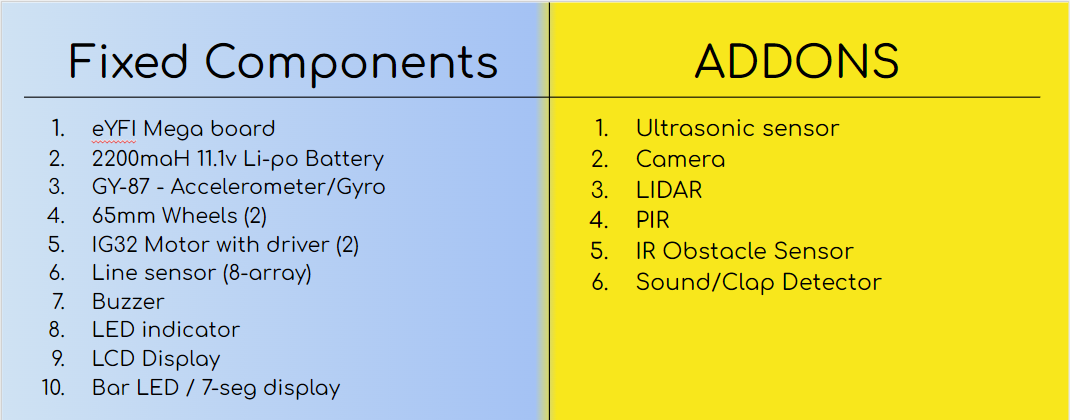
PPT Content/Components_selected.PNG
