masteravinashdubey/2022-SBR-Development/RENDERED/Components/OV7670.JPG

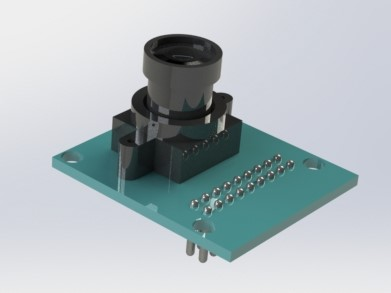
RENDERED/Components/OV7670.JPG
