masteravinashdubey/2022-SBR-Development/RENDERED/Components/SBR.3.png

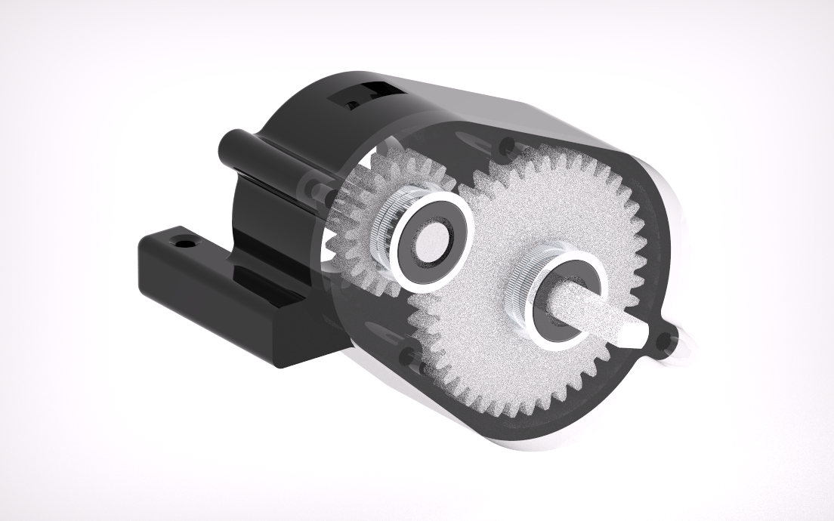
RENDERED/Components/SBR.3.png
