masteravinashdubey/2022-SBR-Development/RENDERED/Components/untitled.14.png

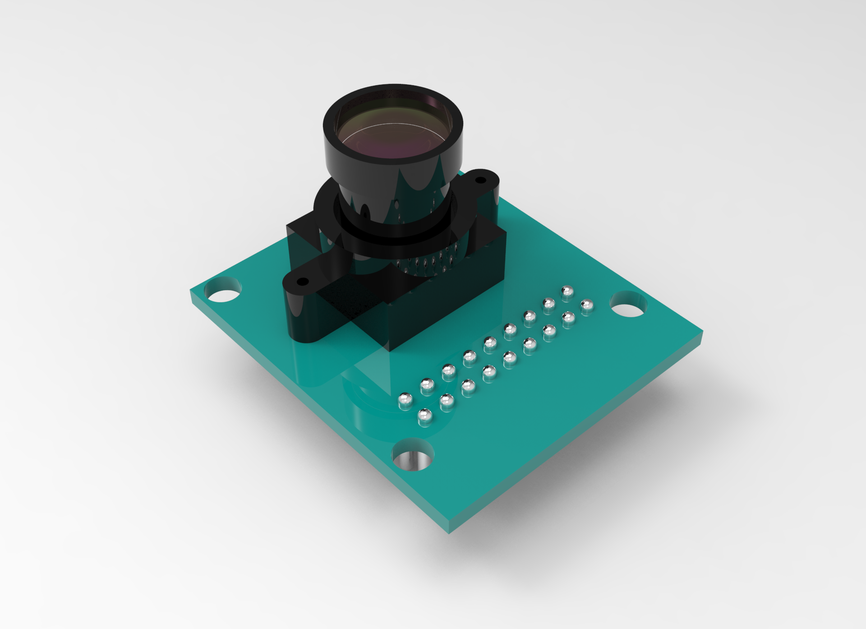
RENDERED/Components/untitled.14.png
