masteravinashdubey/2022-SBR-Development/RENDERED/Components/untitled.15.png

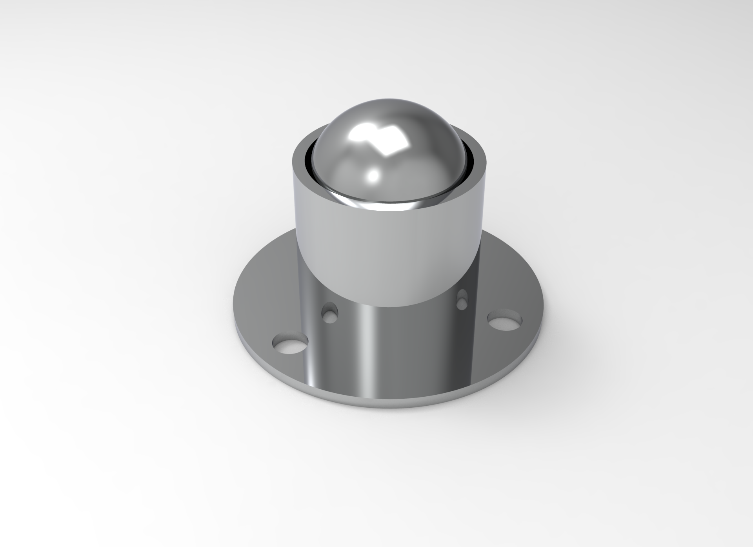
RENDERED/Components/untitled.15.png
