masteravinashdubey/2022-SBR-Development/RENDERED/Components/untitled.16.png

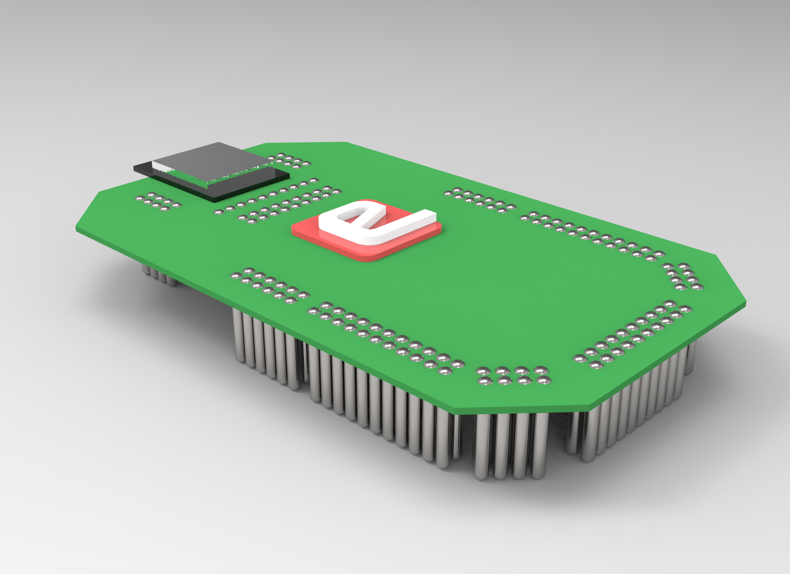
RENDERED/Components/untitled.16.png
