masteravinashdubey/2022-SBR-Development/RENDERED/Components/untitled.17.png

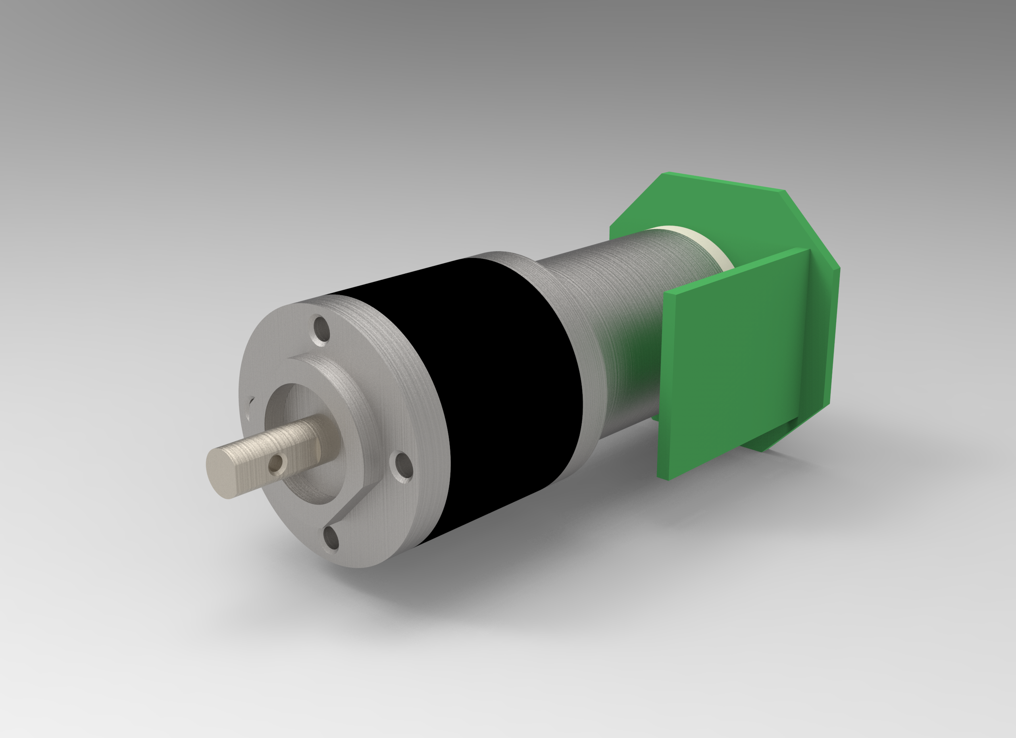
RENDERED/Components/untitled.17.png
