masteravinashdubey/2022-SBR-Development/RENDERED/Components/untitled.18.png

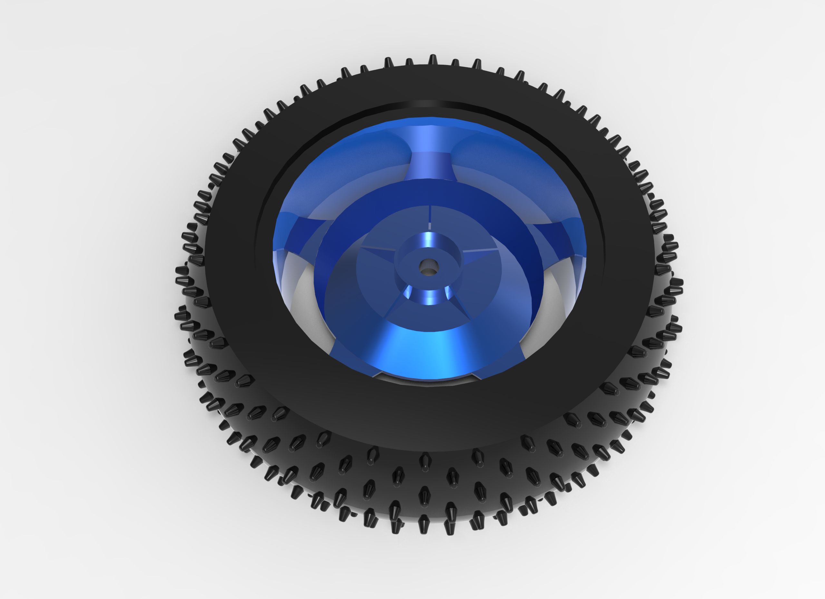
RENDERED/Components/untitled.18.png
