masteravinashdubey/2022-SBR-Development/Parts/BOT design/design ideas/Assem1.SLDASM

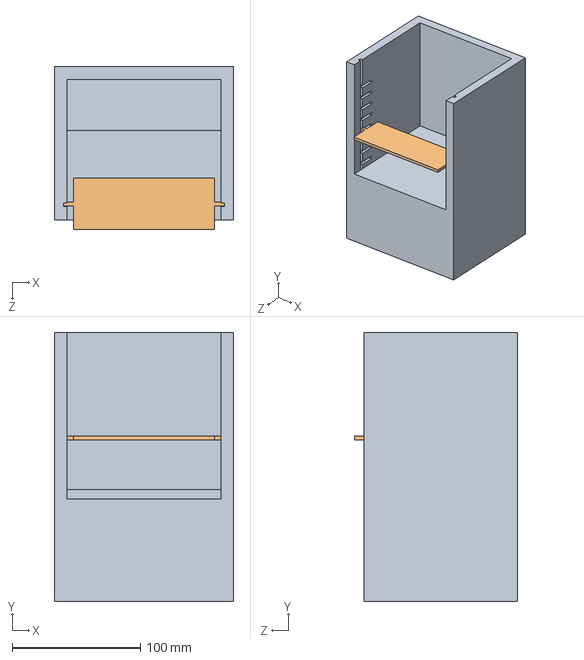
[picture p140: CAD file, 2023-12-04]
Parts/BOT design/design ideas/Assem1.SLDASM
140.0 x 210.0 x 127.2 mm
battery slider slot
battery slider
