masteravinashdubey/2022-SBR-Development/Parts/BOT design/Parts/Motor/Dc_motor.SLDASM

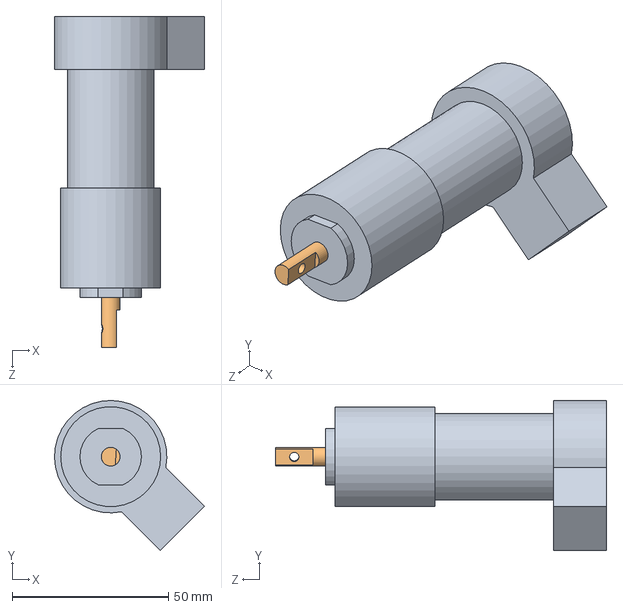
[picture p141: CAD file, 2023-12-04]
Parts/BOT design/Parts/Motor/Dc_motor.SLDASM
48.1 x 48.1 x 106.0 mm
Motor_body
Motor_shaft
