masteravinashdubey/2022-SBR-Development/Assembly/demo_assembly.SLDASM

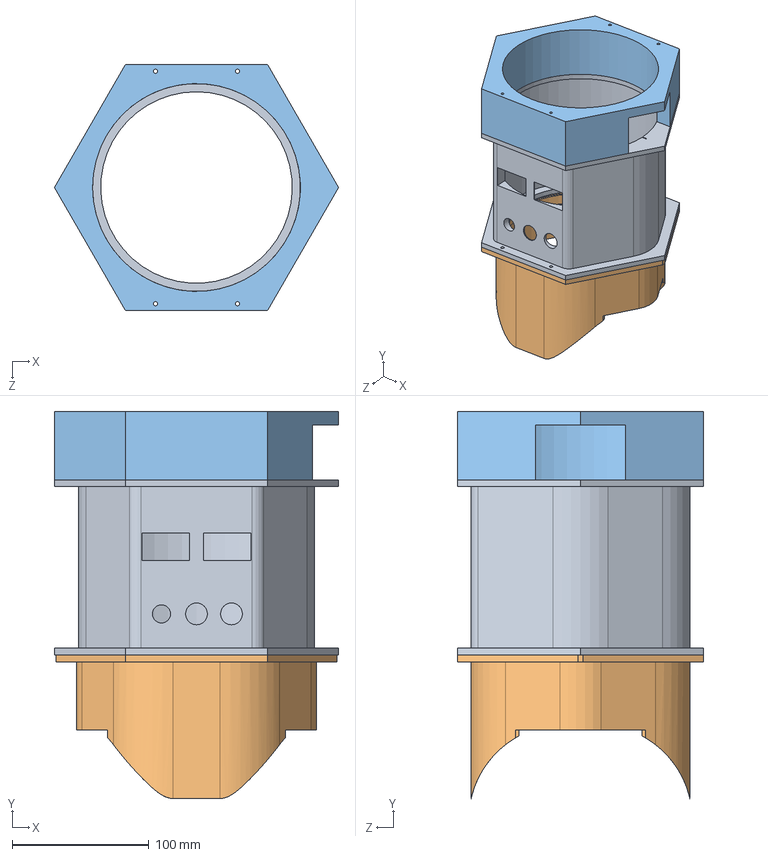
[picture p142: CAD file, 2023-12-04]
Assembly/demo_assembly.SLDASM
207.8 x 283.0 x 180.0 mm
Cover_mid
Cover_Bottom
Cover_Top
