masteravinashdubey/2022-SBR-Development/Parts/BOT design/Parts/WHEEL/blue_wheel_v1.SLDASM

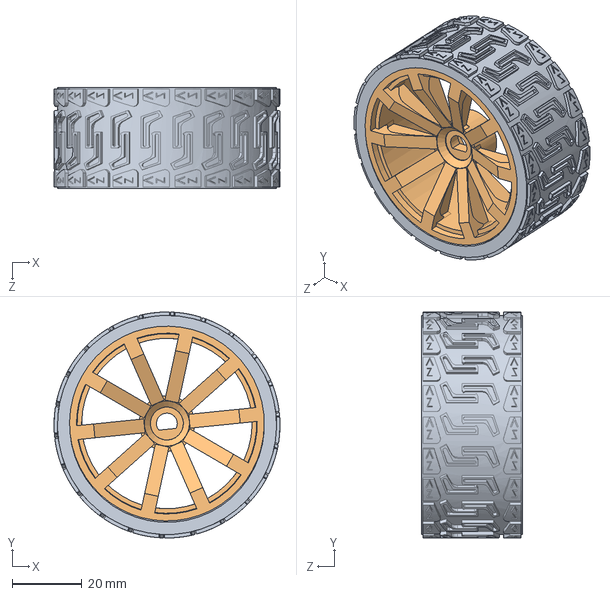
[picture p143: CAD file, 2023-12-04]
Parts/BOT design/Parts/WHEEL/blue_wheel_v1.SLDASM
65.0 x 65.0 x 29.0 mm
65mm tire
blue_wheel_frame
