masteravinashdubey/2022-SBR-Development/Base components/Motor_Main_Shaft.SLDPRT

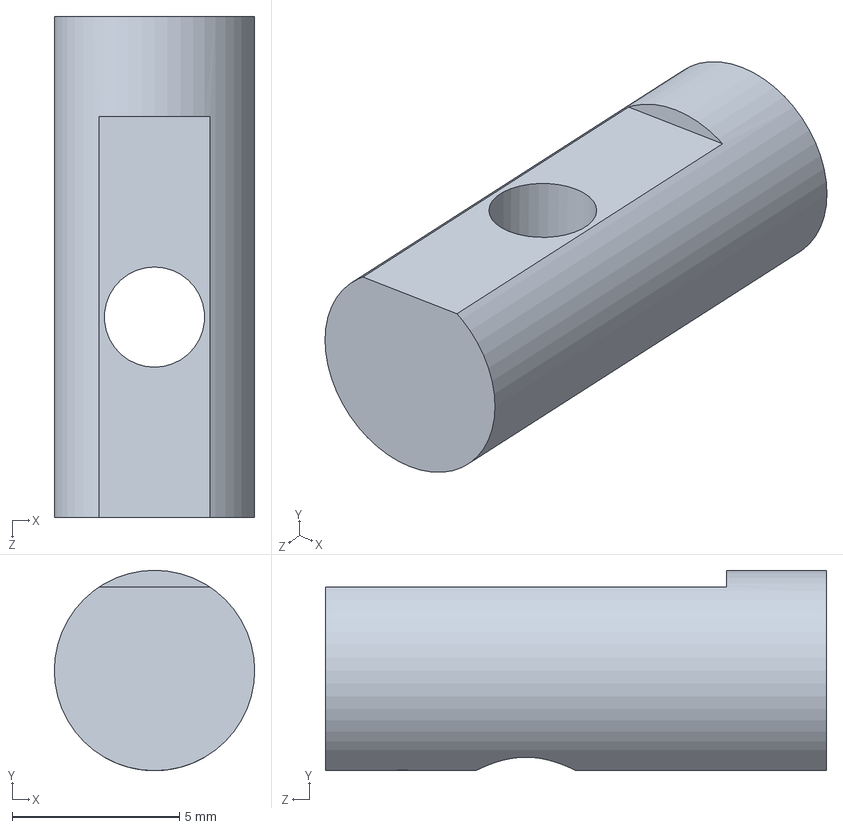
[picture p144: CAD file, 2023-12-04]
Base components/Motor_Main_Shaft.SLDPRT
6.00 x 6.00 x 15.0 mm
