masteravinashdubey/2022-SBR-Development/Parts/BOT design/Parts/WHEEL/blue_wheel_with_adapter.SLDASM

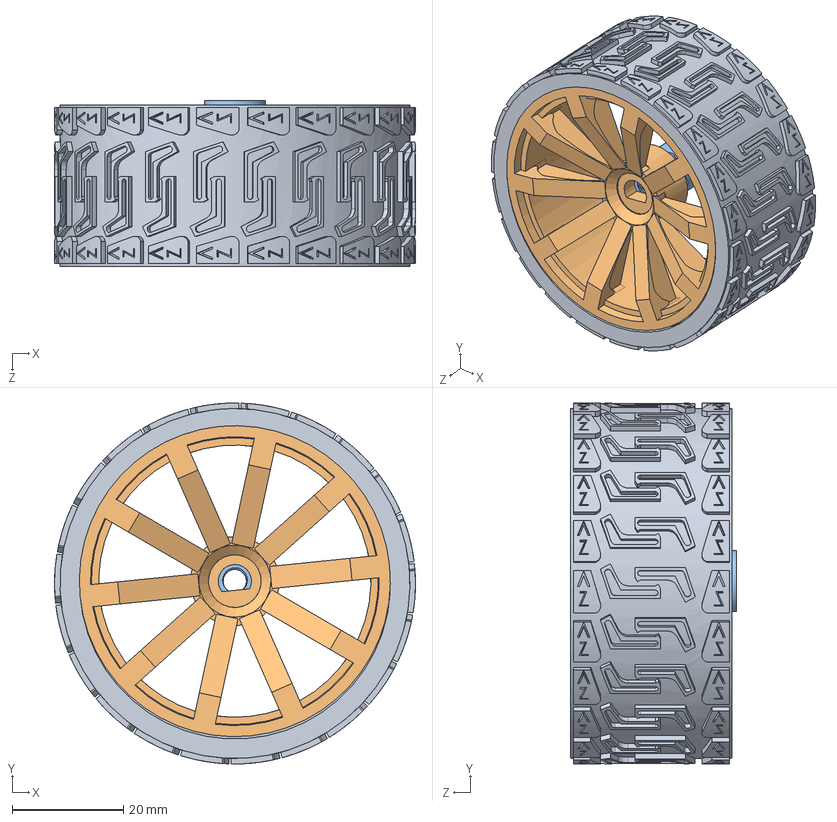
[picture p145: CAD file, 2023-12-04]
Parts/BOT design/Parts/WHEEL/blue_wheel_with_adapter.SLDASM
65.0 x 65.0 x 29.8 mm
65mm tire
blue_wheel_frame
motor_adapter
