masteravinashdubey/2022-SBR-Development/sensors/BUZZER FC07/Buzzer Module - FC-07.SLDASM

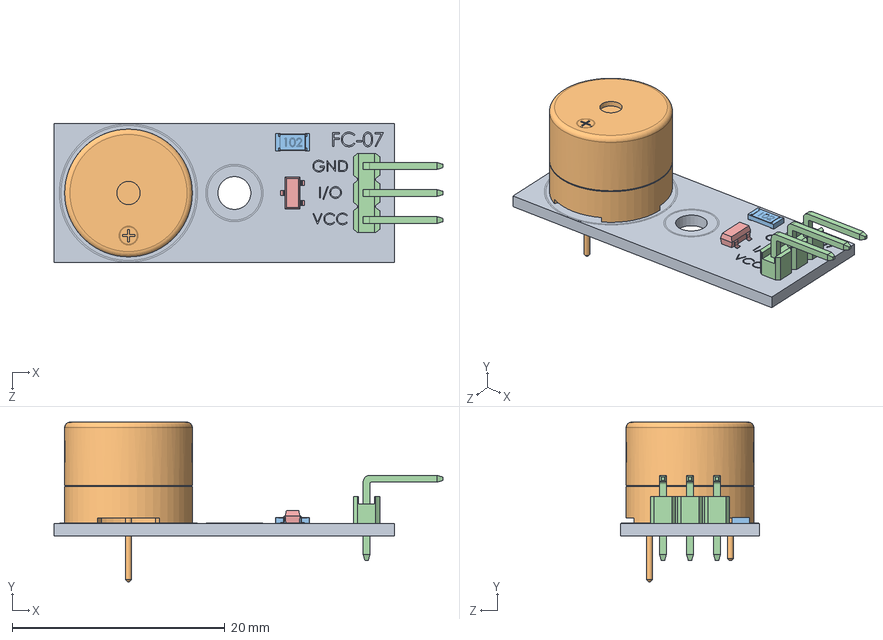
[picture p146: CAD file, 2023-12-04]
sensors/BUZZER FC07/Buzzer Module - FC-07.SLDASM
36.5 x 15.0 x 13.1 mm
Buzzer Module - FC-07 - PCB
Buzzer - 7.6mm
Resistor - SMD - 1206
Pin Header - Single Row - Angled - 2.54 - 3x1
Transistör - SMD - BC817 NPN - SOT23
