masteravinashdubey/2022-SBR-Development/CAD FILES/WASTE/HexNut & GearDriven.SLDASM

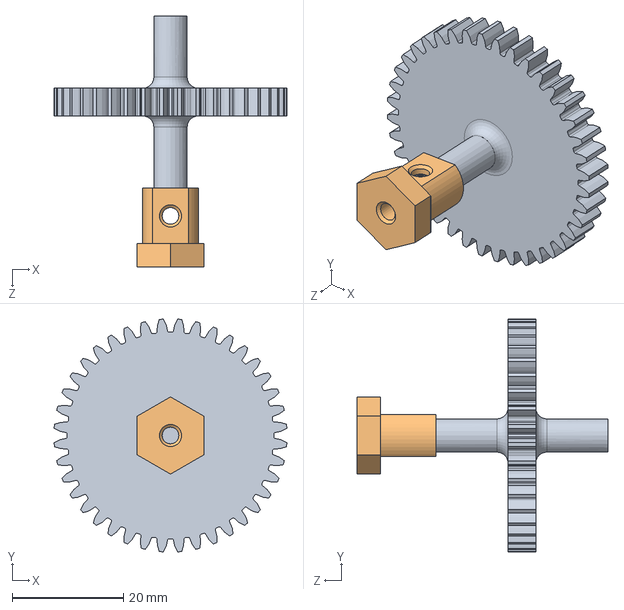
[picture p147: CAD file, 2023-12-04]
CAD FILES/WASTE/HexNut & GearDriven.SLDASM
41.9 x 41.9 x 45.2 mm
Gear_Driven
HexNUt
