masteravinashdubey/2022-SBR-Development/Covers/Cover1.SLDASM

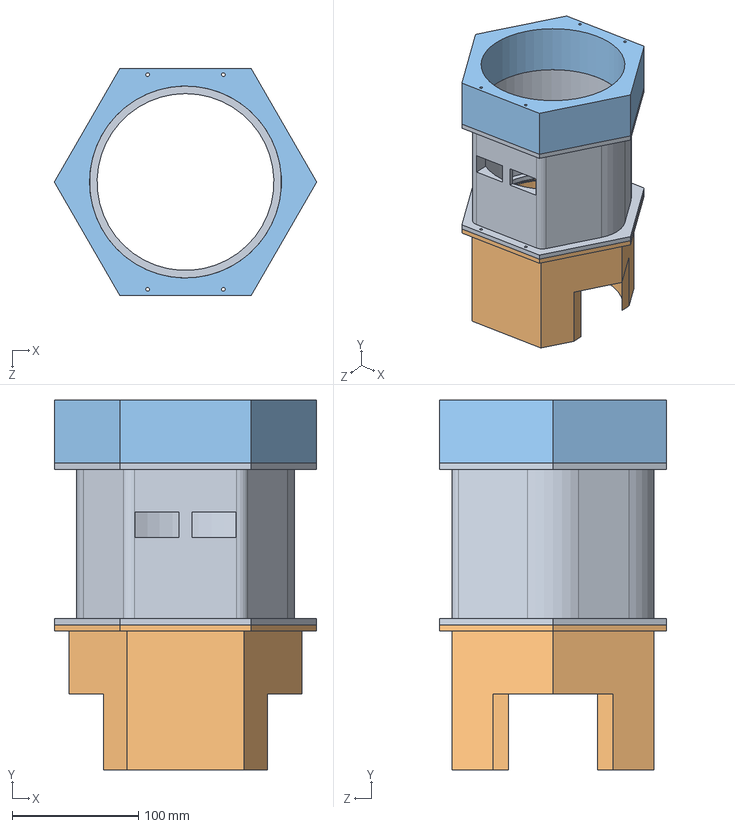
[picture p148: CAD file, 2023-12-04]
Covers/Cover1.SLDASM
207.8 x 293.0 x 180.0 mm
Cover_mid
Cover_Bottom
Cover_Top
