masteravinashdubey/2022-SBR-Development/CAD FILES/WASTE/GEARBOX_ASSEMBLY.SLDASM

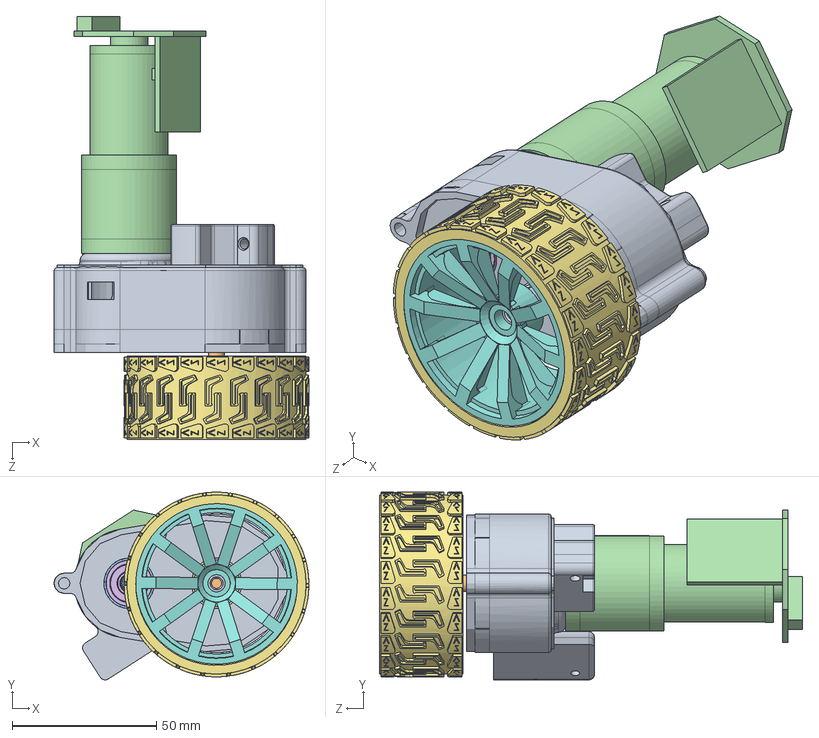
[picture p149: CAD file, 2023-12-04]
CAD FILES/WASTE/GEARBOX_ASSEMBLY.SLDASM
88.3 x 65.0 x 146.5 mm
Gear Box Covering - Modifiable
Gear_Driven
Gear_Driver
IG32 MOTORS
Motor_Main_Shaft
Bearing_Modifiable x 3
65mm tire
blue_wheel_frame
HexNut
