masteravinashdubey/2022-SBR-Development/sensors/ULTRASONIC SENSOR/Ultrasonic Sensor HC-SR04.SLDASM

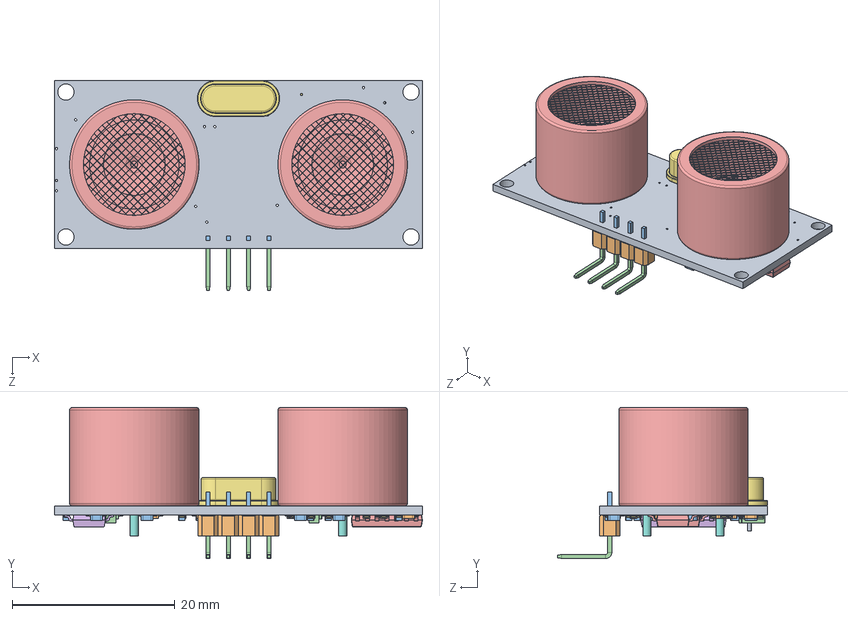
[picture p150: CAD file, 2023-12-04]
sensors/ULTRASONIC SENSOR/Ultrasonic Sensor HC-SR04.SLDASM
45.2 x 18.5 x 25.8 mm
hc-sr04 part1
hc-sr04 part2
hc-sr04 part3 x 4
hc-sr04 part4 x 4
hc-sr04 part5 x 2
hc-sr04 part6 x 2
hc-sr04 part7
hc-sr04 part8 x 4
hc-sr04 part13 x 2
SMD resistor x 21
SMD resistor2 x 15
hc-sr04 part9 x 2
hc-sr04 part10 x 2
hc-sr04 part11
hc-sr04 part12 x 78
