masteravinashdubey/2022-SBR-Development/CAD FILES/65MM WHEEL.SLDASM

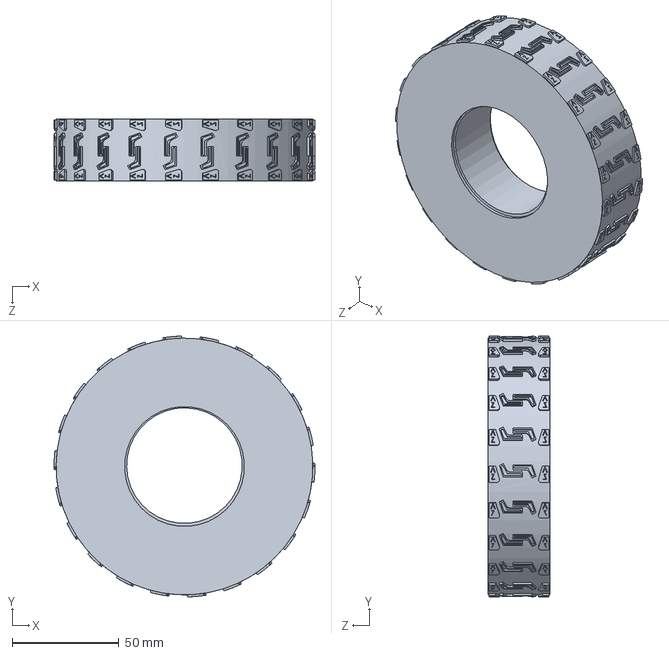
[picture p151: CAD file, 2023-12-04]
CAD FILES/65MM WHEEL.SLDASM
122.0 x 122.0 x 29.0 mm
