masteravinashdubey/2022-SBR-Development/CAD FILES/WASTE/Base+Castor.SLDASM

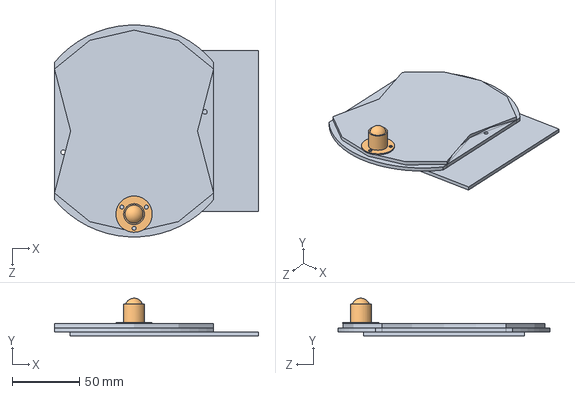
[picture p152: CAD file, 2023-12-04]
CAD FILES/WASTE/Base+Castor.SLDASM
151.7 x 28.0 x 157.4 mm
BASE PLATE COMPACT
Castor
