masteravinashdubey/2022-SBR-Development/Assembly/Gear_1.SLDPRT

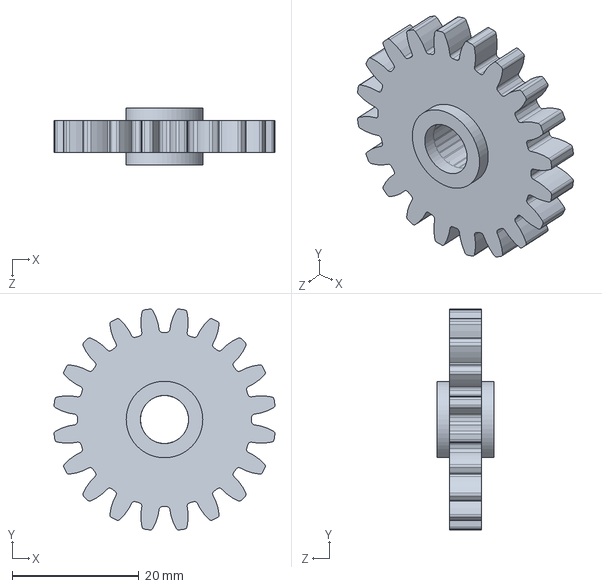
[picture p153: CAD file, 2023-12-04]
Assembly/Gear_1.SLDPRT
34.9 x 34.9 x 9.00 mm
