masteravinashdubey/2022-SBR-Development/Base components/spacer 2cm.SLDPRT

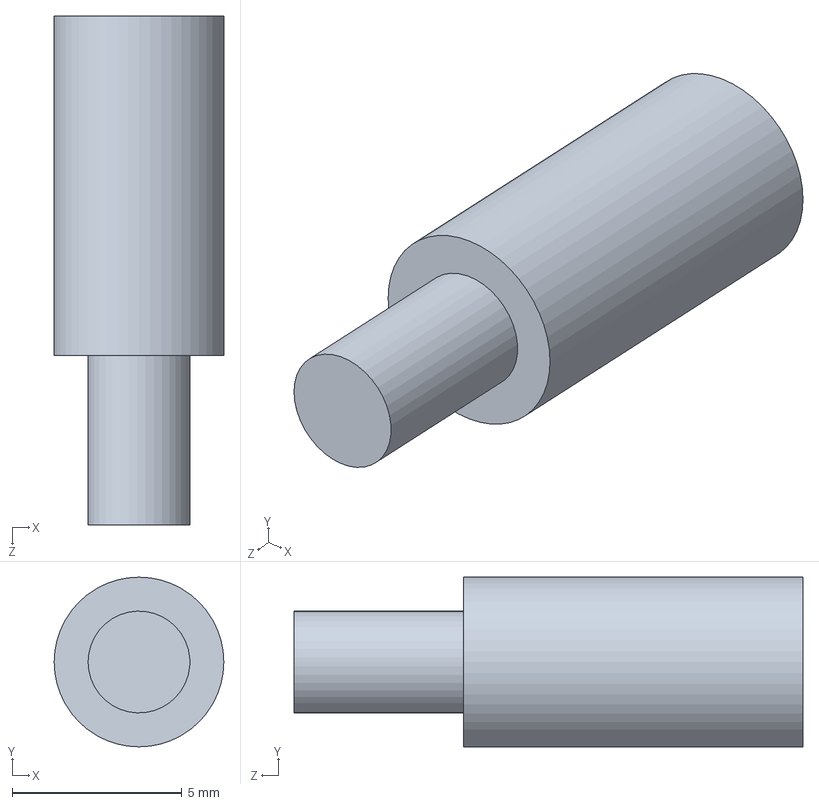
[picture p154: CAD file, 2023-12-04]
Base components/spacer 2cm.SLDPRT
5.00 x 5.00 x 15.0 mm
