masteravinashdubey/2022-SBR-Development/CAD FILES/Castor.SLDPRT

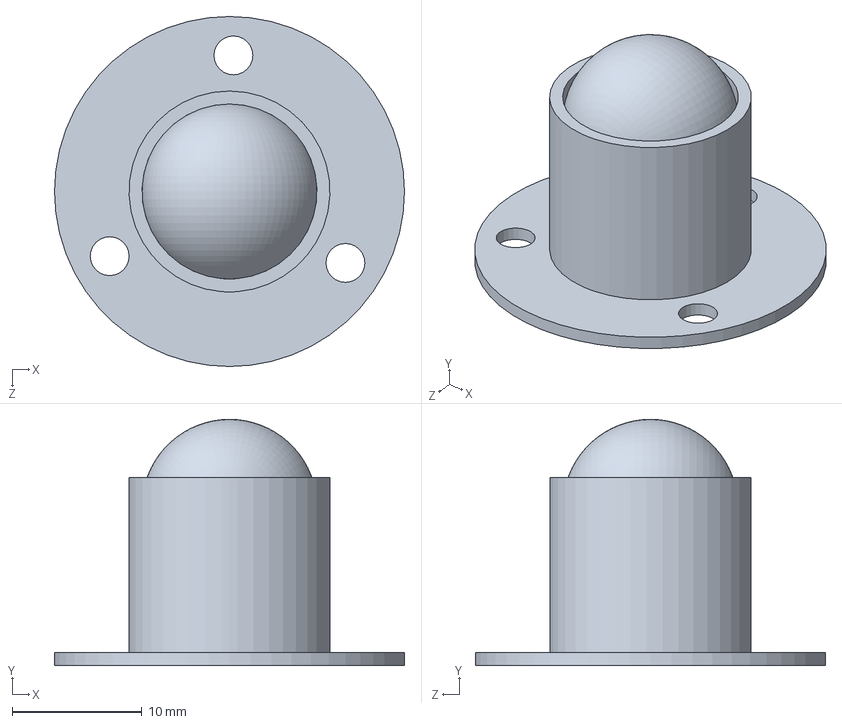
[picture p155: CAD file, 2023-12-04]
CAD FILES/Castor.SLDPRT
27.0 x 19.0 x 27.0 mm
