masteravinashdubey/2022-SBR-Development/CAD FILES/COMPONENTS/ULTRASONIC SENSOR/SLOTTED WEIGHTS.SLDPRT

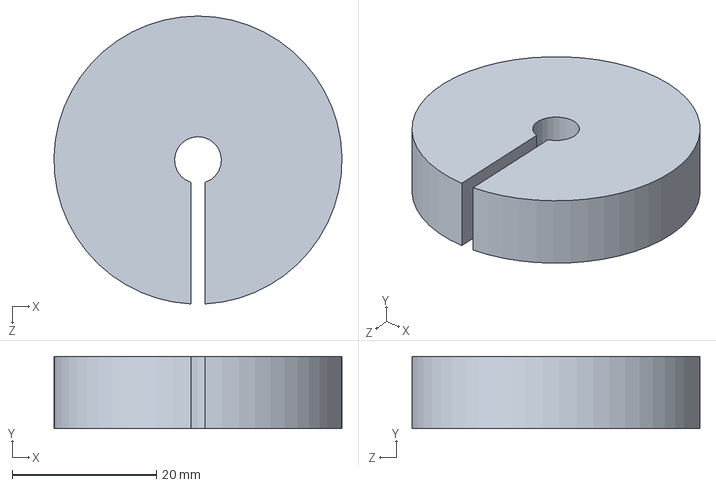
[picture p156: CAD file, 2023-12-04]
CAD FILES/COMPONENTS/ULTRASONIC SENSOR/SLOTTED WEIGHTS.SLDPRT
40.0 x 10.0 x 40.0 mm
