masteravinashdubey/2022-SBR-Development/CAD FILES/COVERS/COVER_4.SLDPRT

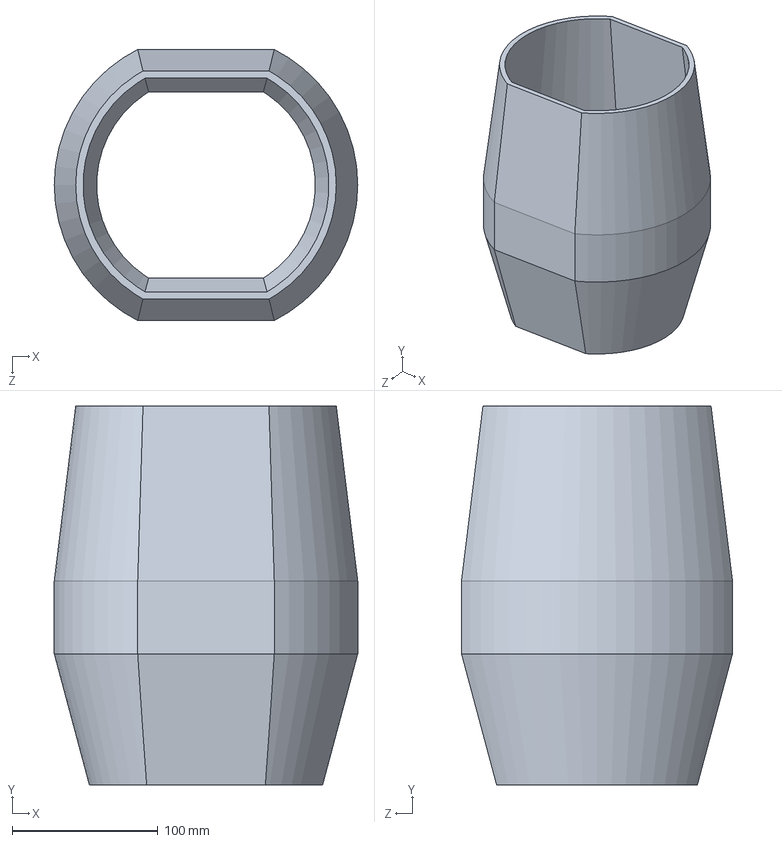
[picture p157: CAD file, 2023-12-04]
CAD FILES/COVERS/COVER_4.SLDPRT
208.2 x 260.0 x 186.0 mm
