masteravinashdubey/2022-SBR-Development/CAD FILES/DEADWEIGHT/BOX DEADWEIGHT.SLDPRT

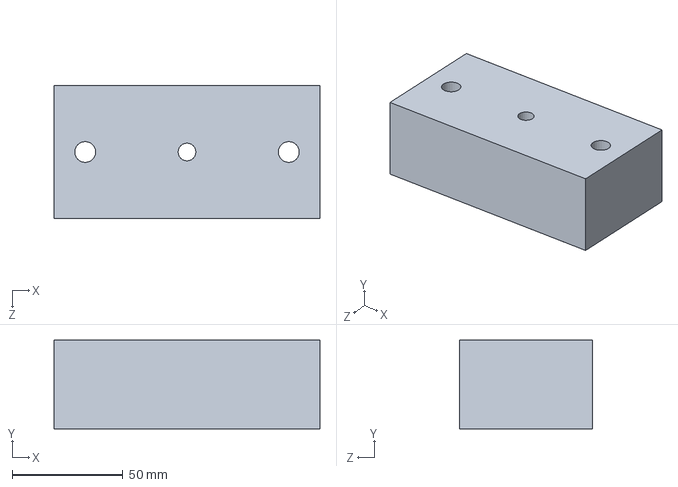
[picture p158: CAD file, 2023-12-04]
CAD FILES/DEADWEIGHT/BOX DEADWEIGHT.SLDPRT
120.0 x 40.0 x 60.0 mm
