masteravinashdubey/2022-SBR-Development/CAD FILES/SPACERS/SPACERS 5CM.SLDPRT

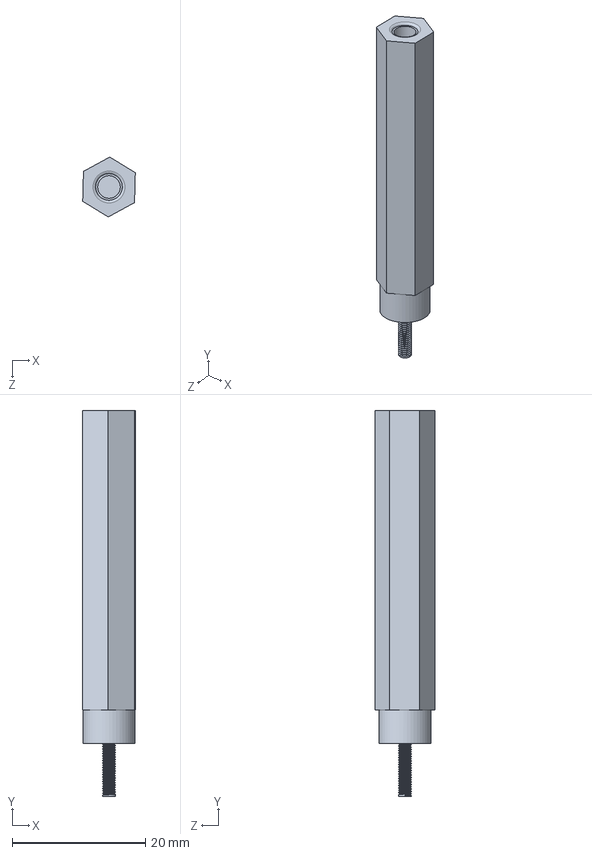
[picture p159: CAD file, 2023-12-04]
CAD FILES/SPACERS/SPACERS 5CM.SLDPRT
7.91 x 58.0 x 9.00 mm
