masteravinashdubey/2022-SBR-Development/CAD FILES/WASTE/Wooden_Clamp.SLDPRT

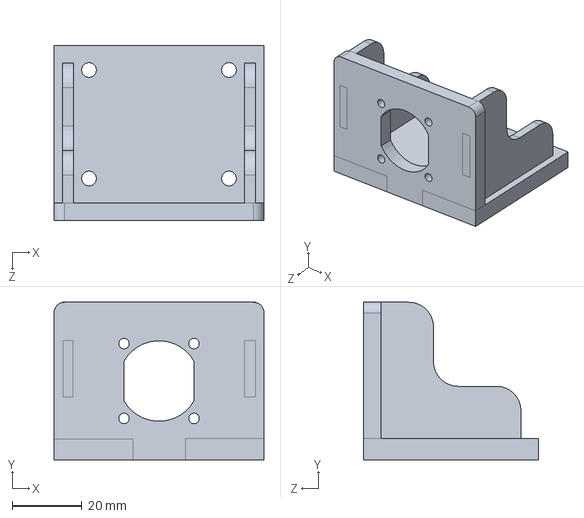
[picture p160: CAD file, 2023-12-04]
CAD FILES/WASTE/Wooden_Clamp.SLDPRT
60.0 x 45.0 x 50.0 mm
