masteravinashdubey/2022-SBR-Development/Components/Solidwork Parts/Plates And Spacers/Floor_Plates_Mid.SLDPRT

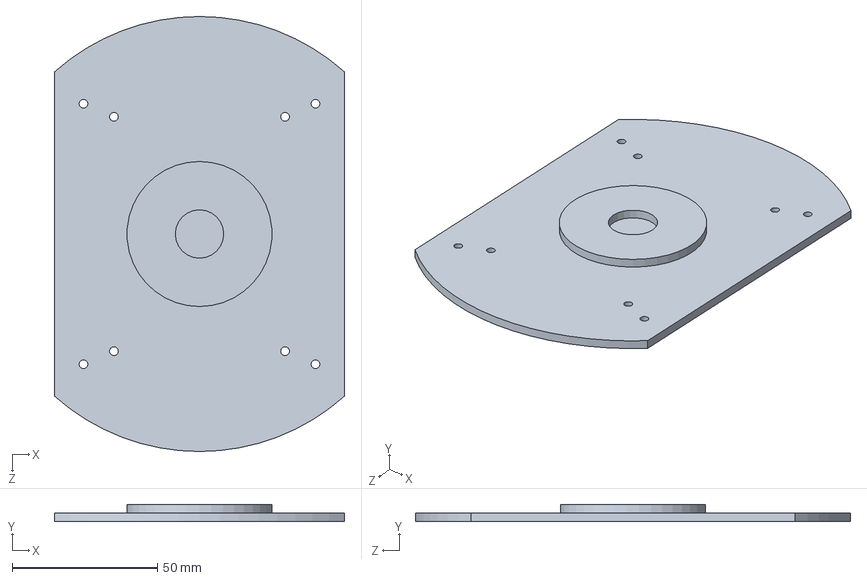
[picture p161: CAD file, 2023-12-04]
Components/Solidwork Parts/Plates And Spacers/Floor_Plates_Mid.SLDPRT
100.0 x 6.00 x 150.0 mm
