masteravinashdubey/2022-SBR-Development/Covers/Cover_Front.SLDPRT

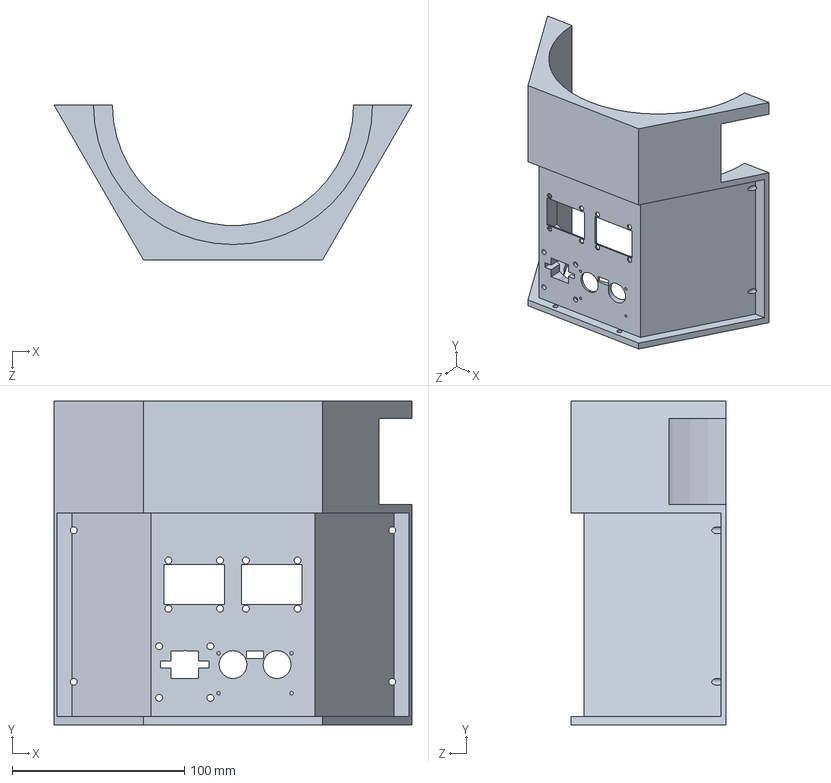
[picture p162: CAD file, 2023-12-04]
Covers/Cover_Front.SLDPRT
207.8 x 188.0 x 90.0 mm
