masteravinashdubey/2022-SBR-Development/Files for 3D printing/gcode files/CE3V2_connectors to motor.3mf

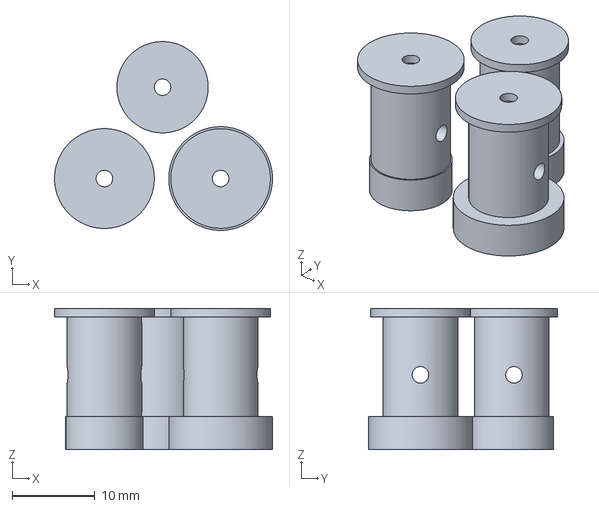
[picture p163: CAD file, 2023-12-04]
Files for 3D printing/gcode files/CE3V2_connectors to motor.3mf
26.3 x 22.7 x 17.0 mm
