masteravinashdubey/2022-SBR-Development/Files for 3D printing/Stl files/30062022/Bearing_Test2.STL

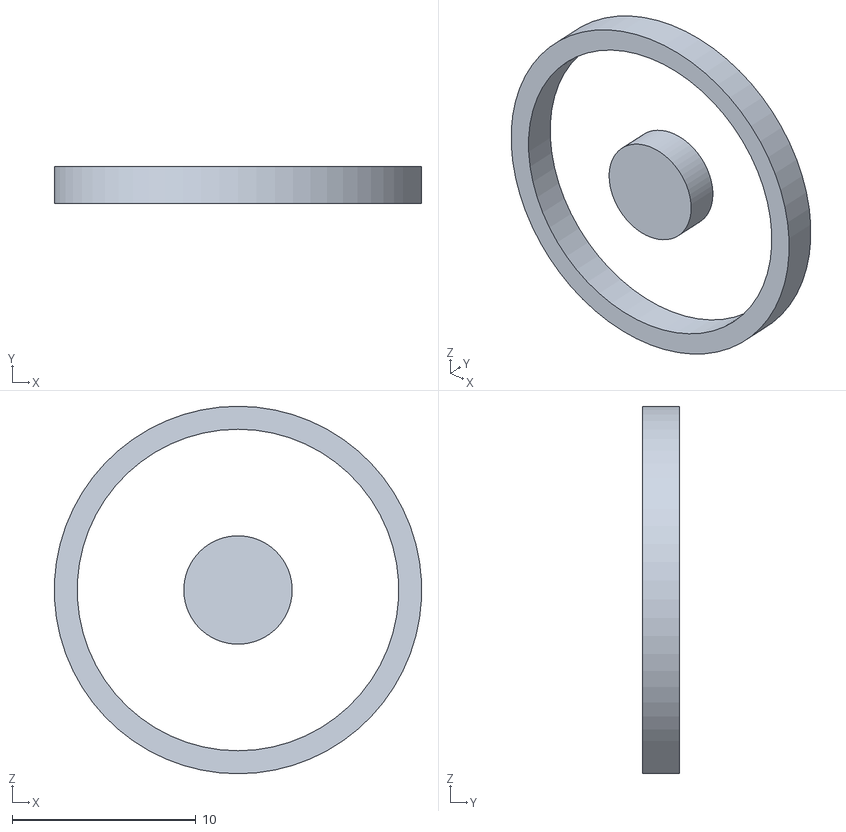
[picture p164: CAD file, 2023-12-04]
Files for 3D printing/Stl files/30062022/Bearing_Test2.STL
20.0 x 2.00 x 20.0
