masteravinashdubey/2022-SBR-Development/Files for 3D printing/Stl files/Gear_Driven_V1.STL

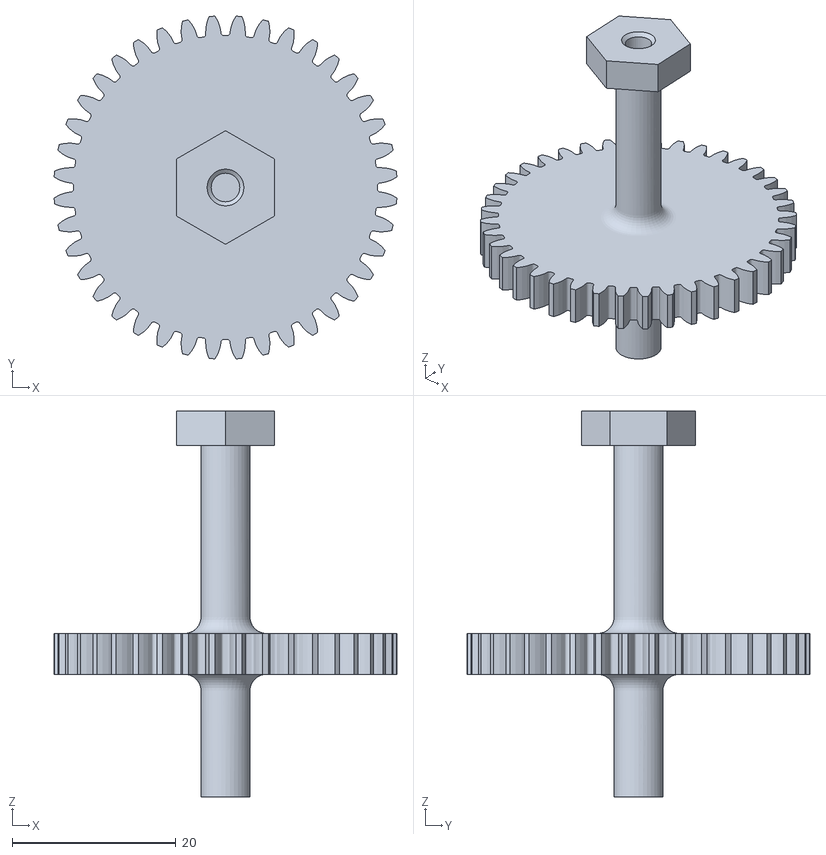
[picture p165: CAD file, 2023-12-04]
Files for 3D printing/Stl files/Gear_Driven_V1.STL
41.9 x 41.9 x 47.2
