masteravinashdubey/2022-SBR-Development/Gearbox parts/Gear_Driver.SLDPRT

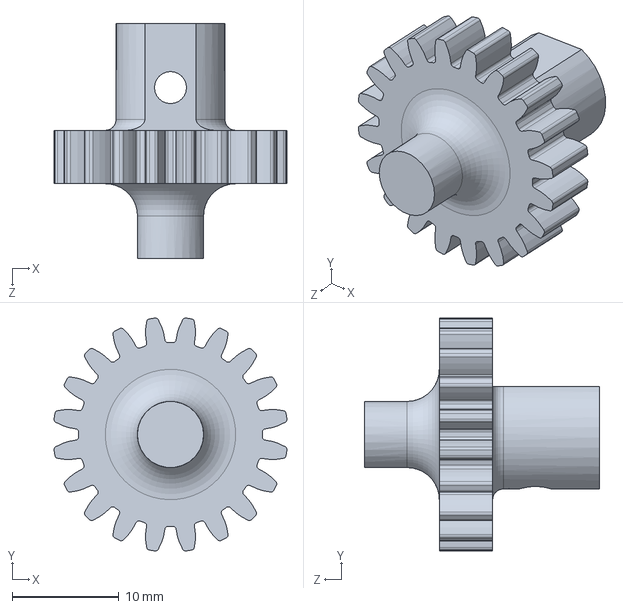
[picture p166: CAD file, 2023-12-04]
Gearbox parts/Gear_Driver.SLDPRT
21.8 x 21.8 x 22.0 mm
