masteravinashdubey/2022-SBR-Development/Parts/BOT design/eYFi_slot.SLDPRT

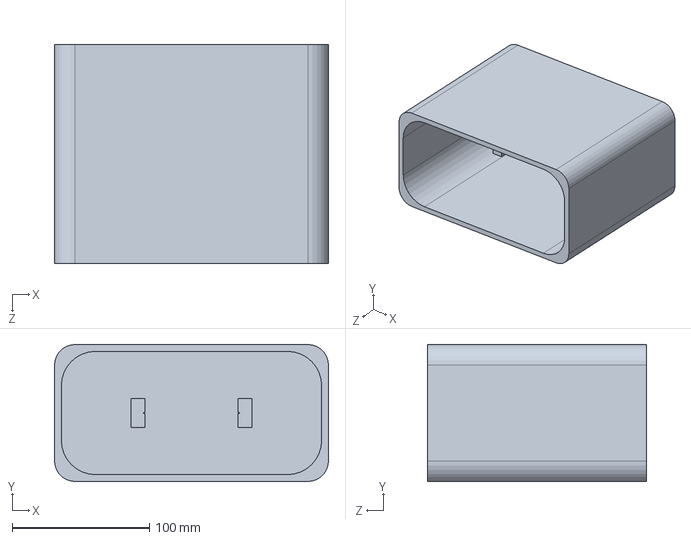
[picture p167: CAD file, 2023-12-04]
Parts/BOT design/eYFi_slot.SLDPRT
200.0 x 100.0 x 160.0 mm
