masteravinashdubey/2022-SBR-Development/Parts/BOT design/Parts/eYFi_Mega.SLDPRT

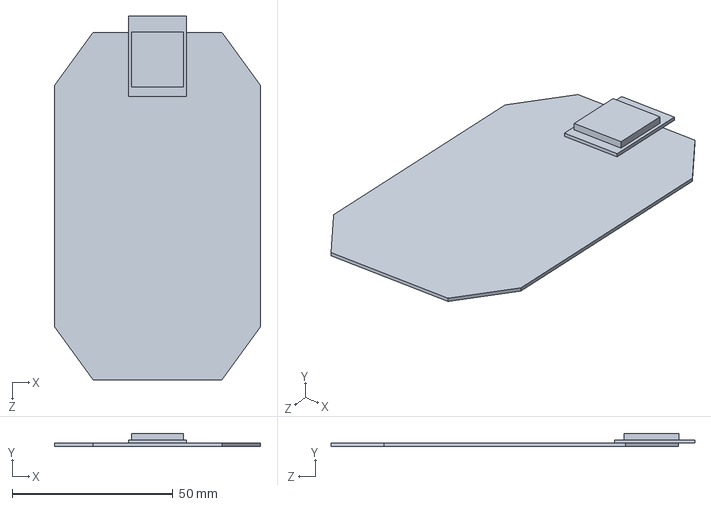
[picture p168: CAD file, 2023-12-04]
Parts/BOT design/Parts/eYFi_Mega.SLDPRT
64.0 x 4.00 x 113.0 mm
