masteravinashdubey/2022-SBR-Development/Parts/BOT design/Parts/WHEEL/blue_wheel_frame.SLDPRT

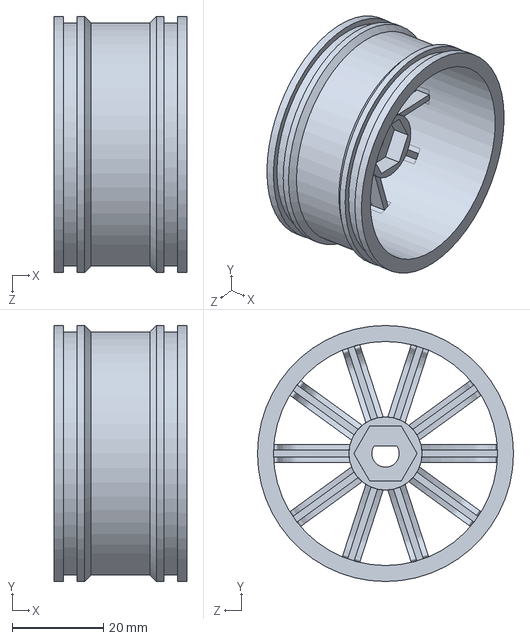
[picture p169: CAD file, 2023-12-04]
Parts/BOT design/Parts/WHEEL/blue_wheel_frame.SLDPRT
29.0 x 56.0 x 56.0 mm
