masteravinashdubey/2022-SBR-Development/Parts/Motor/Motor_shaft.SLDPRT

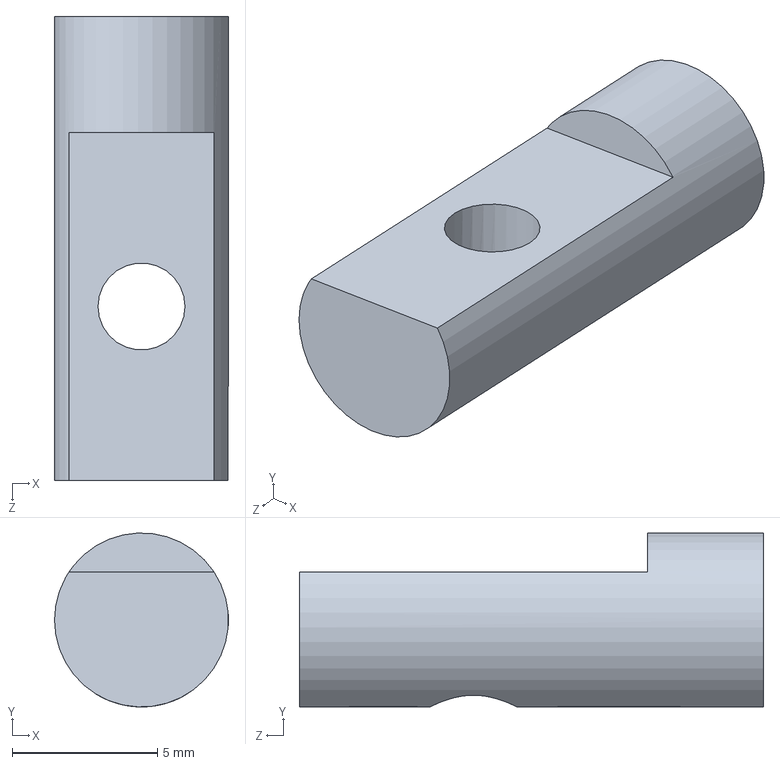
[picture p170: CAD file, 2023-12-04]
Parts/Motor/Motor_shaft.SLDPRT
6.00 x 6.00 x 16.0 mm
