masteravinashdubey/2022-SBR-Development/Plates/Floor_Plates1.DXF

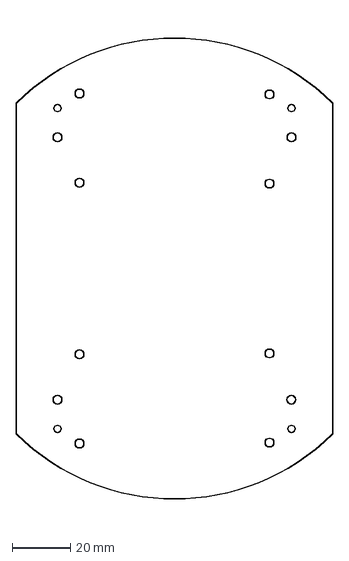
[picture p171: CAD file, 2023-12-04]
Plates/Floor_Plates1.DXF
108.3 x 172.4 mm
