masteravinashdubey/2022-SBR-Development/sensors/BUZZER FC07/Buzzer - 7.6mm.SLDPRT

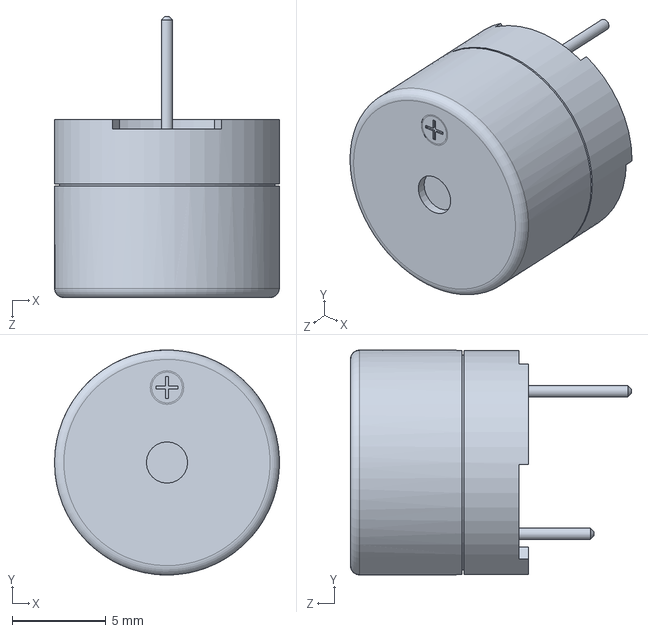
[picture p172: CAD file, 2023-12-04]
sensors/BUZZER FC07/Buzzer - 7.6mm.SLDPRT
12.0 x 12.0 x 15.0 mm
