masteravinashdubey/2022-SBR-Development/sensors/Sharp/2Y0A21.SLDPRT

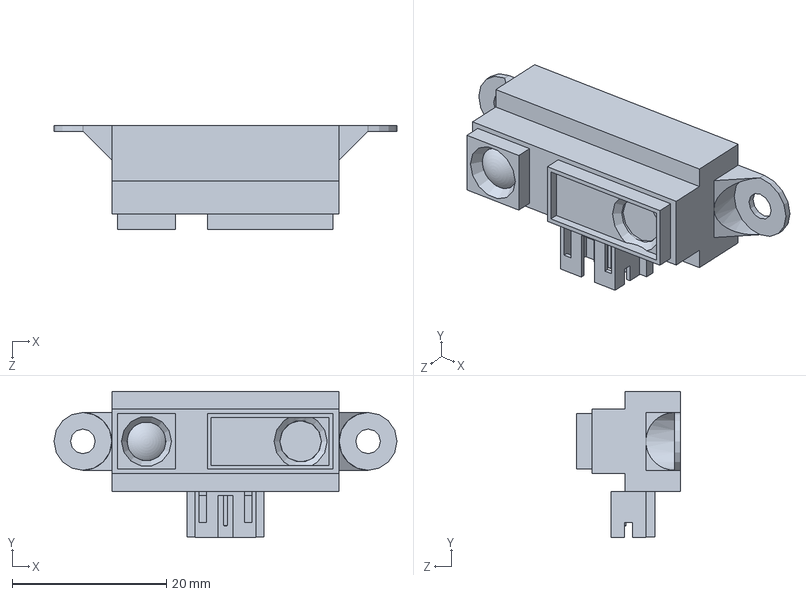
[picture p174: CAD file, 2023-12-04]
sensors/Sharp/2Y0A21.SLDPRT
44.5 x 19.0 x 13.5 mm
