masteravinashdubey/2022-SBR-Development/sensors/ULTRASONIC SENSOR/hc-sr04 part8.SLDPRT

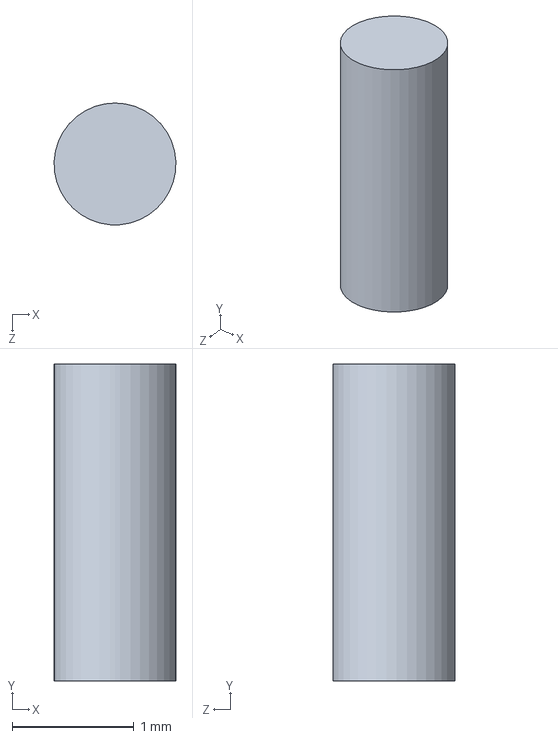
[picture p175: CAD file, 2023-12-04]
sensors/ULTRASONIC SENSOR/hc-sr04 part8.SLDPRT
0.999 x 2.60 x 1.00 mm
