masteravinashdubey/2022-SBR-Development/Spacers/Floor_Plates3.SLDPRT

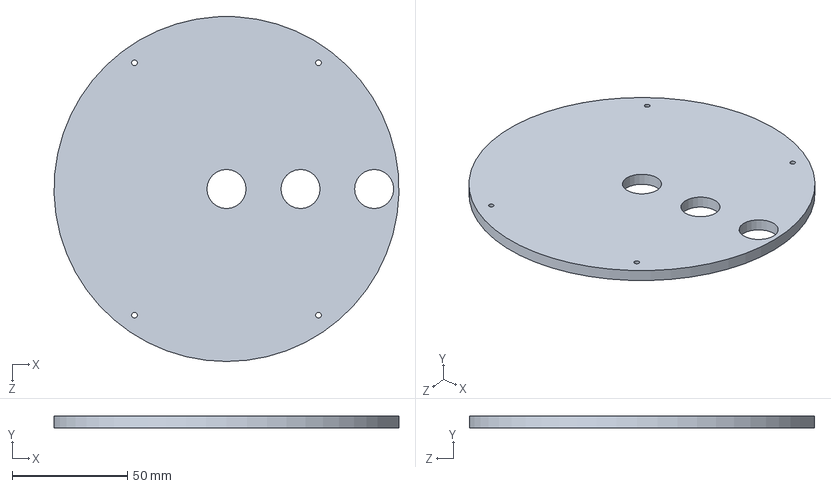
[picture p176: CAD file, 2023-12-04]
Spacers/Floor_Plates3.SLDPRT
149.9 x 5.00 x 150.0 mm
