masteravinashdubey/2022-SBR-Development/Base components/Bearing_Modifiable.SLDPRT

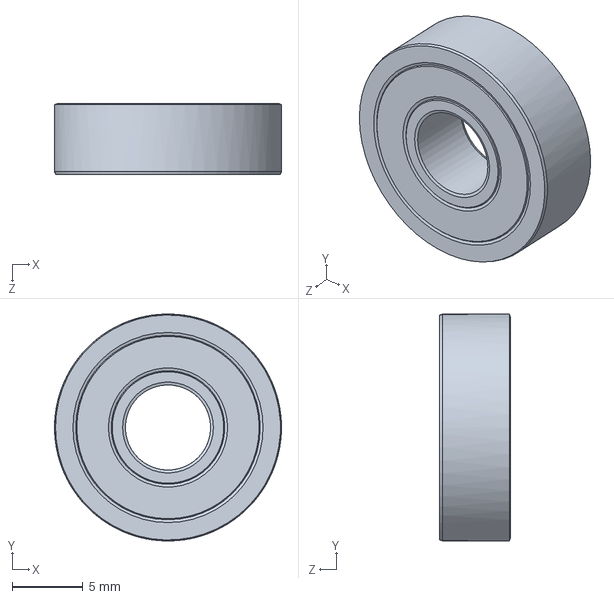
[picture p177: CAD file, 2023-12-04]
Base components/Bearing_Modifiable.SLDPRT
16.0 x 16.0 x 5.00 mm
