masteravinashdubey/2022-SBR-Development/CAD FILES/COVERS/COVER_3 HALF.SLDPRT

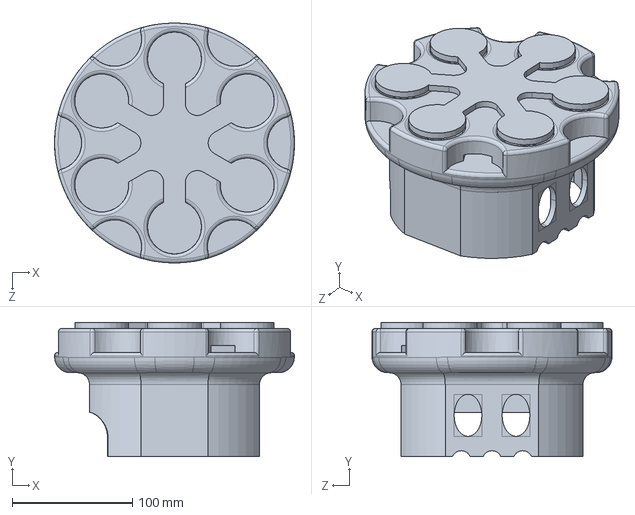
[picture p178: CAD file, 2023-12-04]
CAD FILES/COVERS/COVER_3 HALF.SLDPRT
200.0 x 112.0 x 200.0 mm
