masteravinashdubey/2022-SBR-Development/CAD FILES/DEADWEIGHT/DISC DEADWEIGHT.SLDPRT

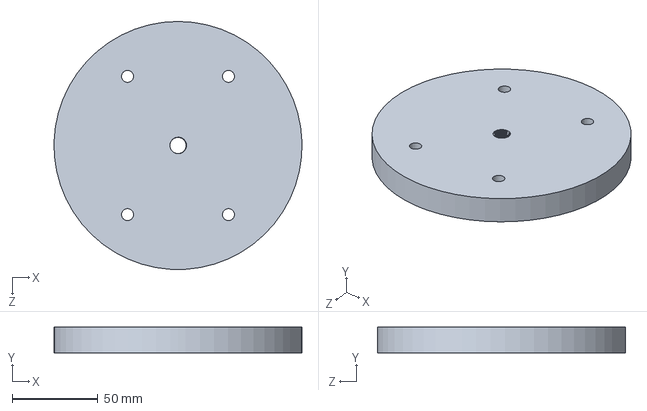
[picture p179: CAD file, 2023-12-04]
CAD FILES/DEADWEIGHT/DISC DEADWEIGHT.SLDPRT
144.9 x 15.0 x 145.0 mm
