masteravinashdubey/2022-SBR-Development/CAD FILES/GEARBOX_COVERING_MODIFIABLE.SLDPRT

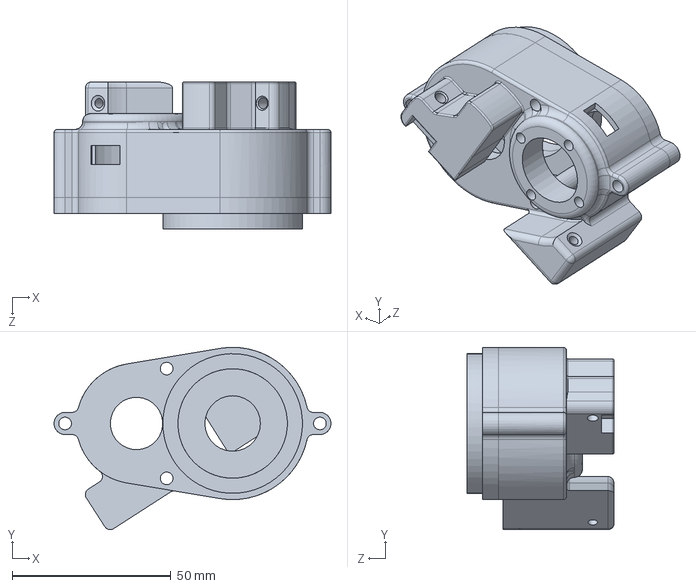
[picture p180: CAD file, 2023-12-04]
CAD FILES/GEARBOX_COVERING_MODIFIABLE.SLDPRT
87.3 x 57.5 x 46.4 mm
