masteravinashdubey/2022-SBR-Development/CAD FILES/SPACERS/SPACERS 3CM.SLDPRT

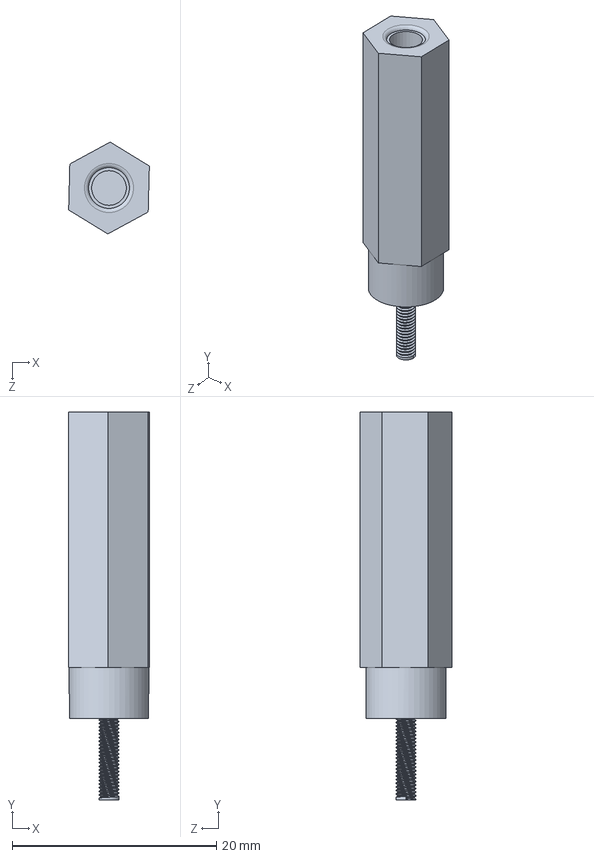
[picture p181: CAD file, 2023-12-04]
CAD FILES/SPACERS/SPACERS 3CM.SLDPRT
7.91 x 38.0 x 9.00 mm
