masteravinashdubey/2022-SBR-Development/CAD FILES/WASTE/Ground.SLDPRT

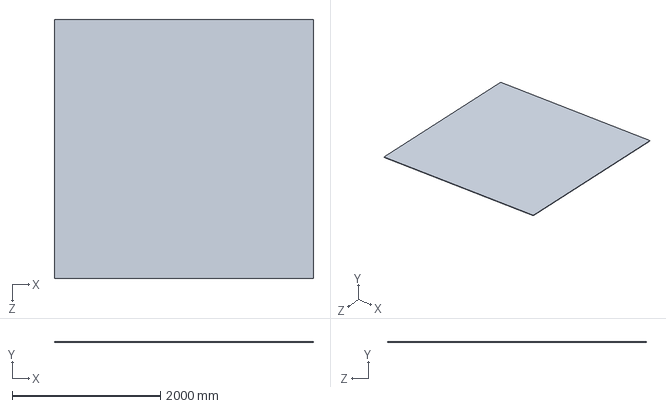
[picture p182: CAD file, 2023-12-04]
CAD FILES/WASTE/Ground.SLDPRT
3500.0 x 10.0 x 3500.0 mm
