masteravinashdubey/2022-SBR-Development/Covers/Cover_Top.SLDPRT

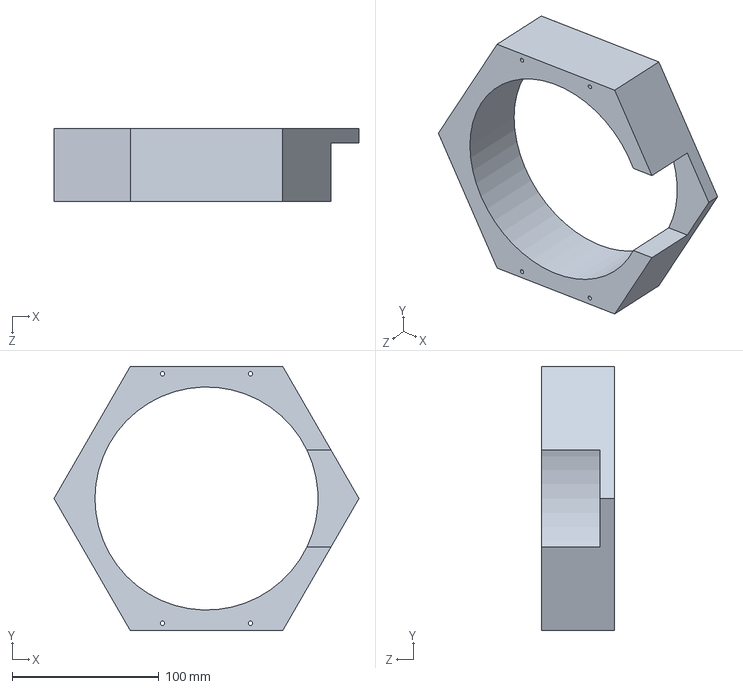
[picture p183: CAD file, 2023-12-04]
Covers/Cover_Top.SLDPRT
207.8 x 180.0 x 50.0 mm
