masteravinashdubey/2022-SBR-Development/Files for 3D printing/gcode files/gear box v2 v1.stl

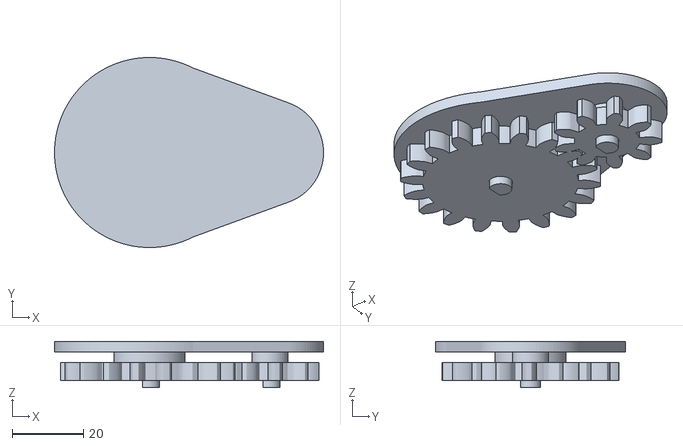
[picture p184: CAD file, 2023-12-04]
Files for 3D printing/gcode files/gear box v2 v1.stl
75.4 x 53.3 x 13.0
