masteravinashdubey/2022-SBR-Development/Files for 3D printing/Stl files/30062022/TestBearing.STL

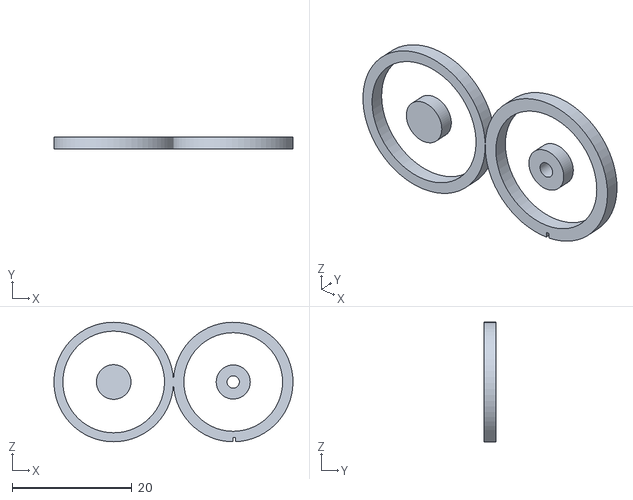
[picture p185: CAD file, 2023-12-04]
Files for 3D printing/Stl files/30062022/TestBearing.STL
40.0 x 2.00 x 20.0
