masteravinashdubey/2022-SBR-Development/Files for 3D printing/Stl files/gbox_err.STL

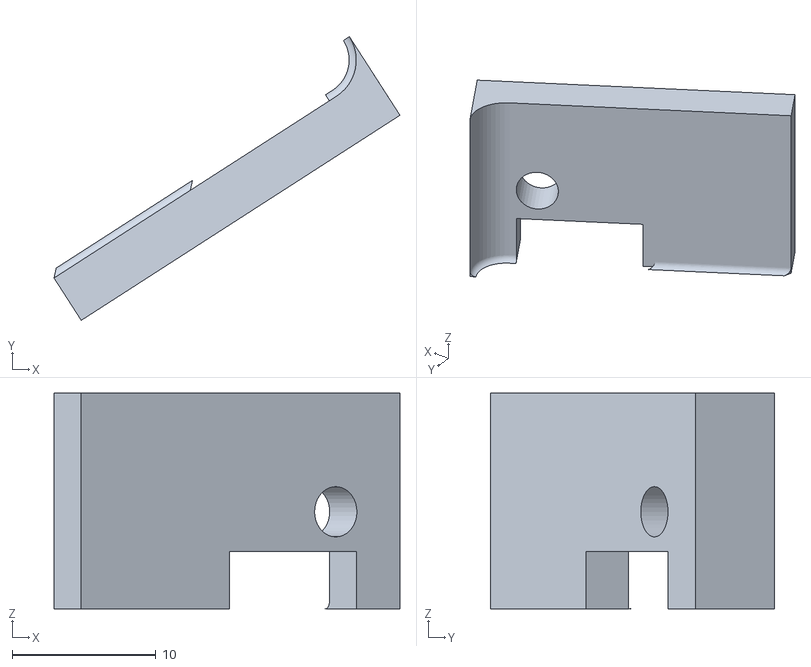
[picture p186: CAD file, 2023-12-04]
Files for 3D printing/Stl files/gbox_err.STL
24.1 x 19.7 x 15.0
