masteravinashdubey/2022-SBR-Development/Gearbox parts/Gear_Driven.SLDPRT

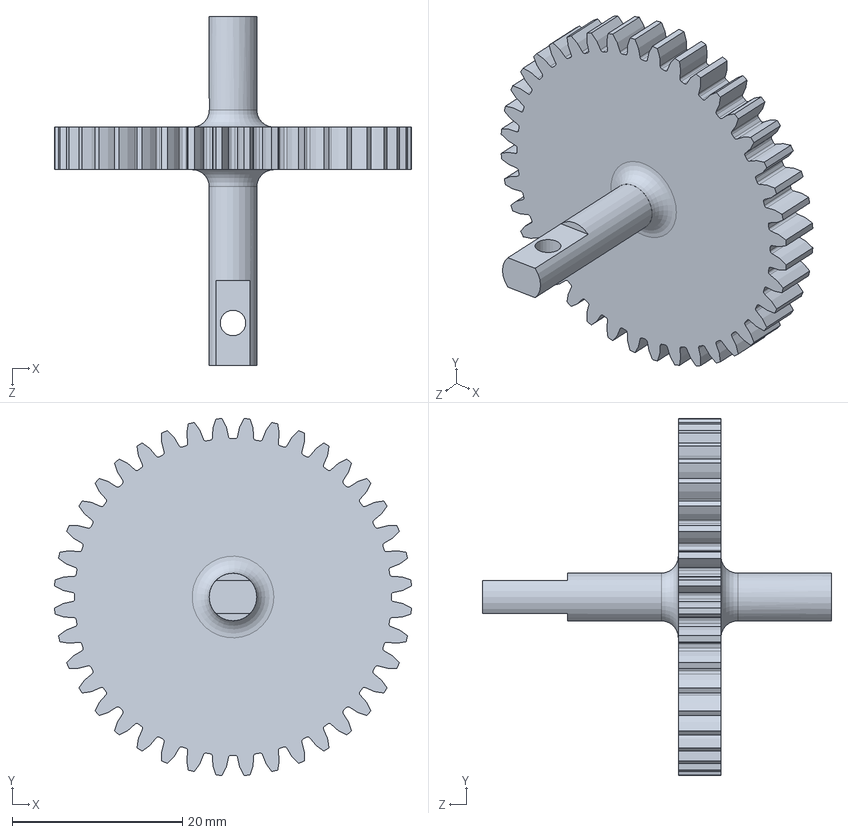
[picture p187: CAD file, 2023-12-04]
Gearbox parts/Gear_Driven.SLDPRT
41.9 x 41.9 x 41.0 mm
