masteravinashdubey/2022-SBR-Development/Parts/BOT design/base1.SLDPRT

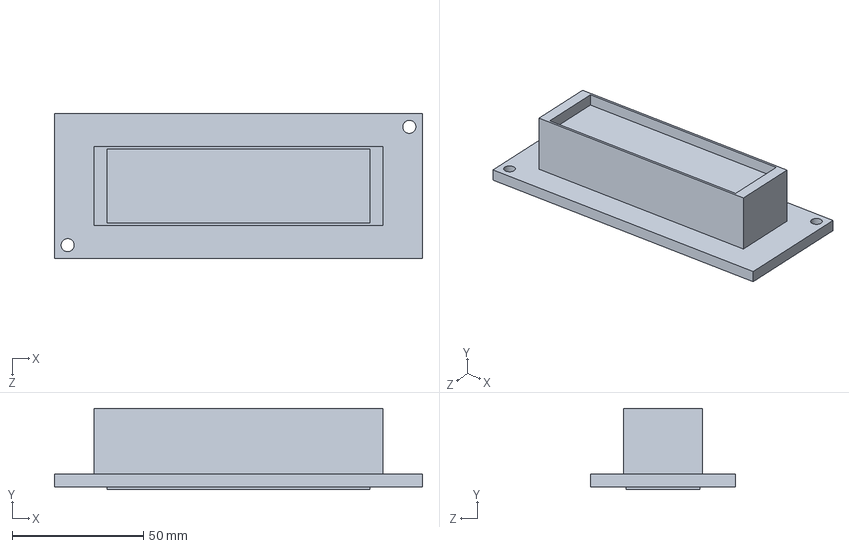
[picture p188: CAD file, 2023-12-04]
Parts/BOT design/base1.SLDPRT
140.0 x 31.0 x 55.0 mm
