masteravinashdubey/2022-SBR-Development/Parts/BOT design/design ideas/slots for battery.SLDPRT

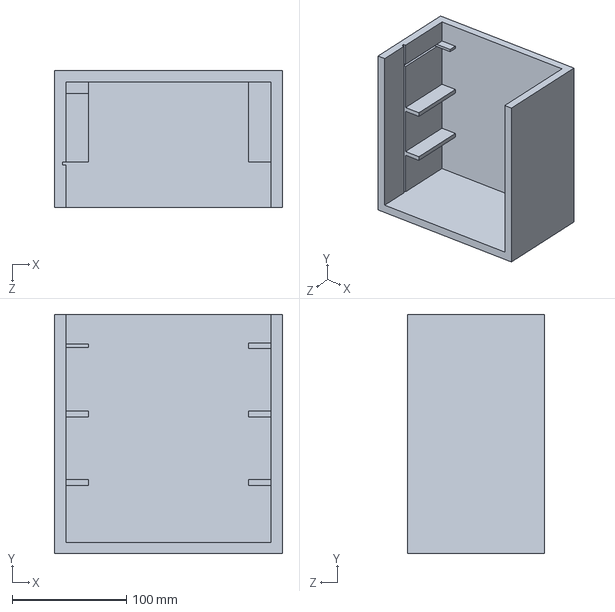
[picture p189: CAD file, 2023-12-04]
Parts/BOT design/design ideas/slots for battery.SLDPRT
200.0 x 210.0 x 120.0 mm
