masteravinashdubey/2022-SBR-Development/Parts/Motor/Motor_body.SLDPRT

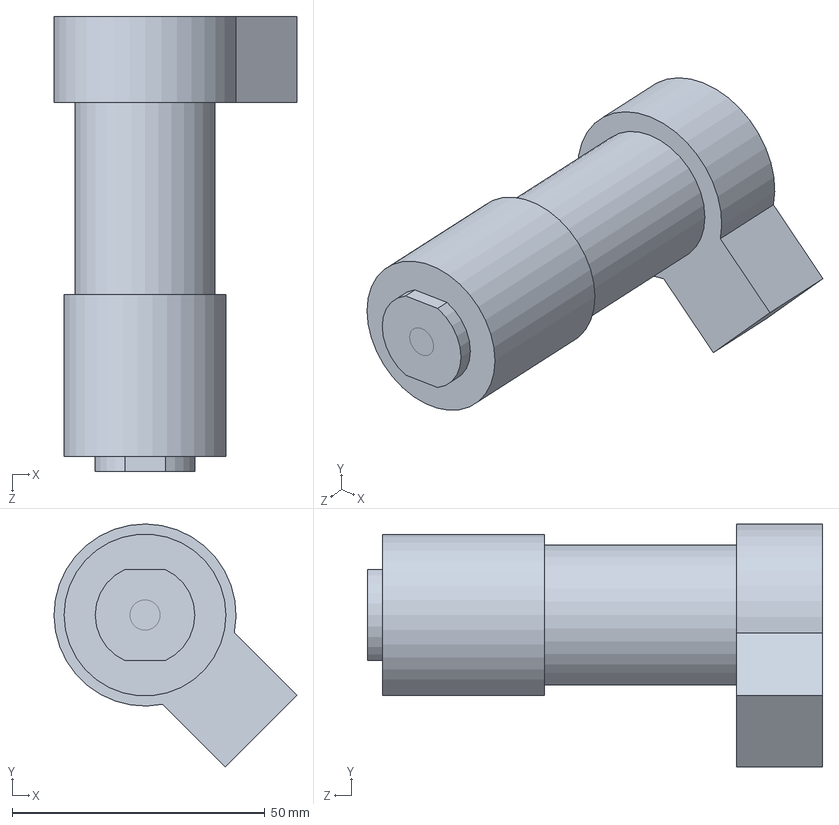
[picture p190: CAD file, 2023-12-04]
Parts/Motor/Motor_body.SLDPRT
48.1 x 48.1 x 90.0 mm
