masteravinashdubey/2022-SBR-Development/Parts/WHEEL/65mm tire.SLDPRT

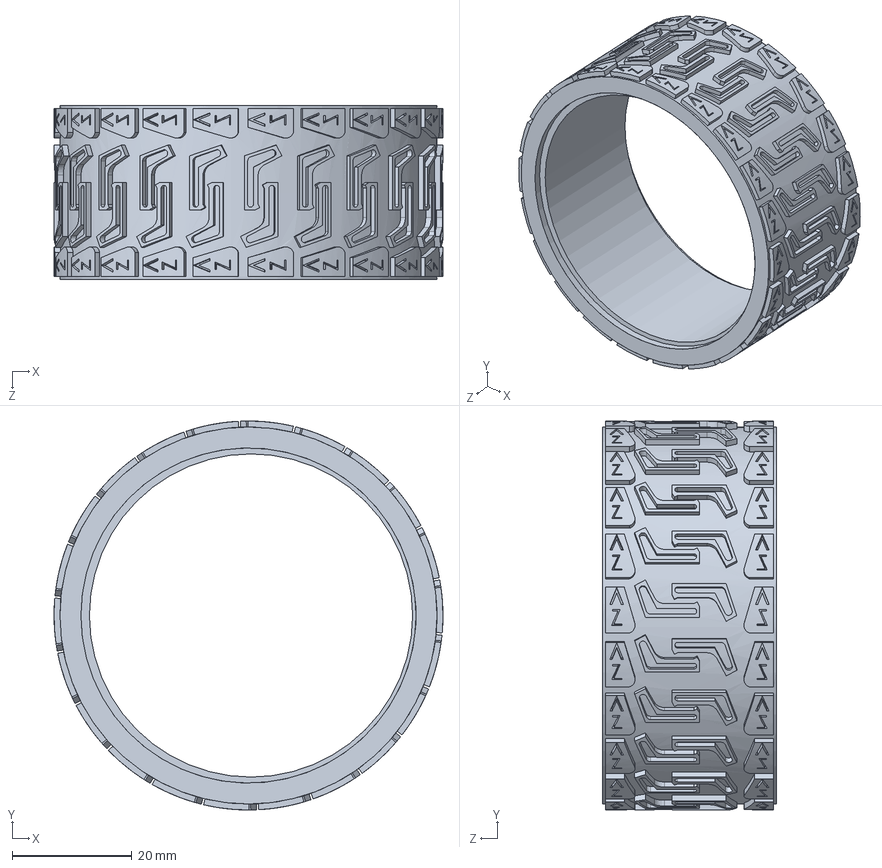
[picture p191: CAD file, 2023-12-04]
Parts/WHEEL/65mm tire.SLDPRT
65.0 x 65.0 x 29.0 mm
