masteravinashdubey/2022-SBR-Development/Plates/Plate3.DXF

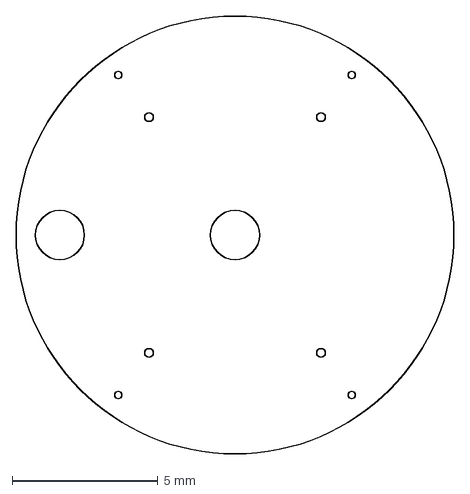
[picture p192: CAD file, 2023-12-04]
Plates/Plate3.DXF
15.0 x 15.0 mm
