masteravinashdubey/2022-SBR-Development/sensors/BUZZER FC07/Buzzer Module - FC-07 - PCB.SLDPRT

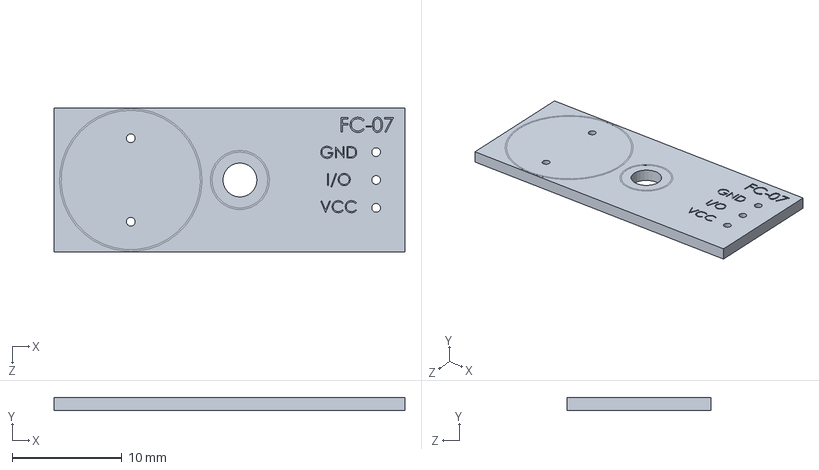
[picture p193: CAD file, 2023-12-04]
sensors/BUZZER FC07/Buzzer Module - FC-07 - PCB.SLDPRT
32.0 x 1.20 x 13.1 mm
