masteravinashdubey/2022-SBR-Development/sensors/Floor_Plates2_2.DXF

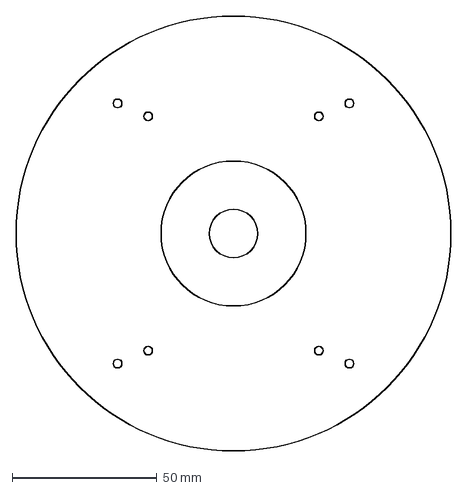
[picture p194: CAD file, 2023-12-04]
sensors/Floor_Plates2_2.DXF
150.0 x 150.0 mm
