masteravinashdubey/2022-SBR-Development/sensors/ULTRASONIC SENSOR/hc-sr04 part4.SLDPRT

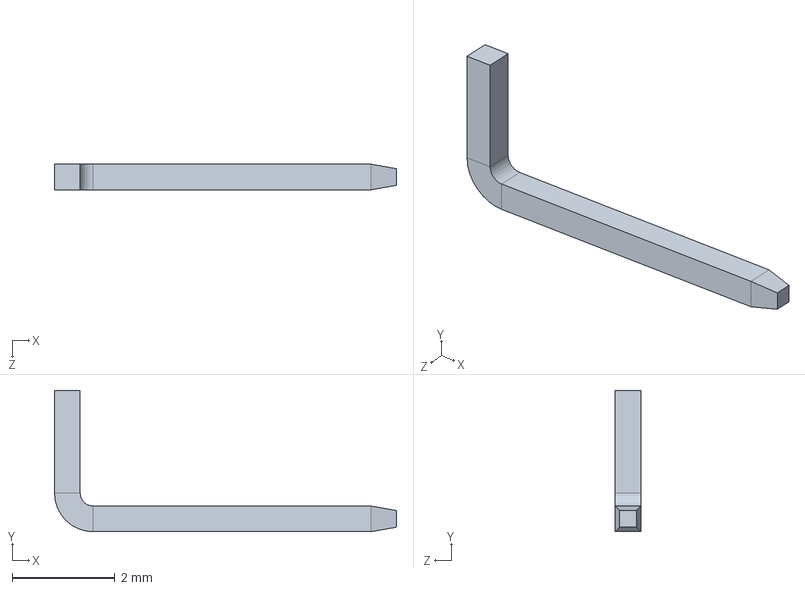
[picture p195: CAD file, 2023-12-04]
sensors/ULTRASONIC SENSOR/hc-sr04 part4.SLDPRT
6.65 x 2.75 x 0.5 mm
