masteravinashdubey/2022-SBR-Development/Spacers/Dead_weight.SLDPRT

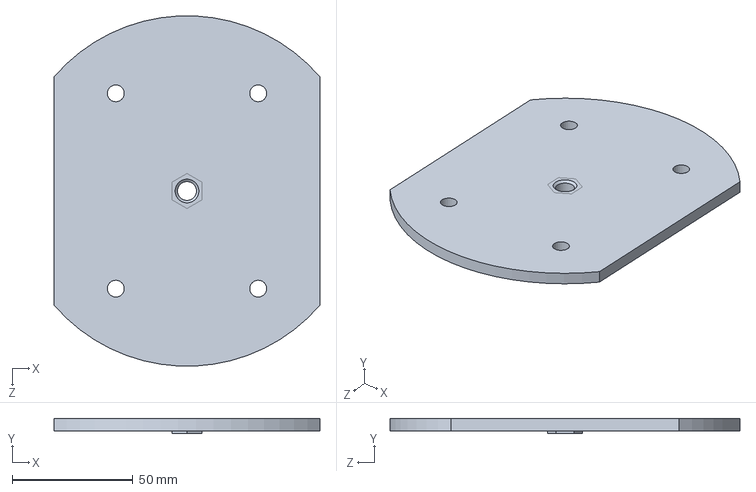
[picture p196: CAD file, 2023-12-04]
Spacers/Dead_weight.SLDPRT
110.0 x 6.00 x 144.8 mm
