masteravinashdubey/2022-SBR-Development/STLS/Gear_Driven_LARGE_V4.STL

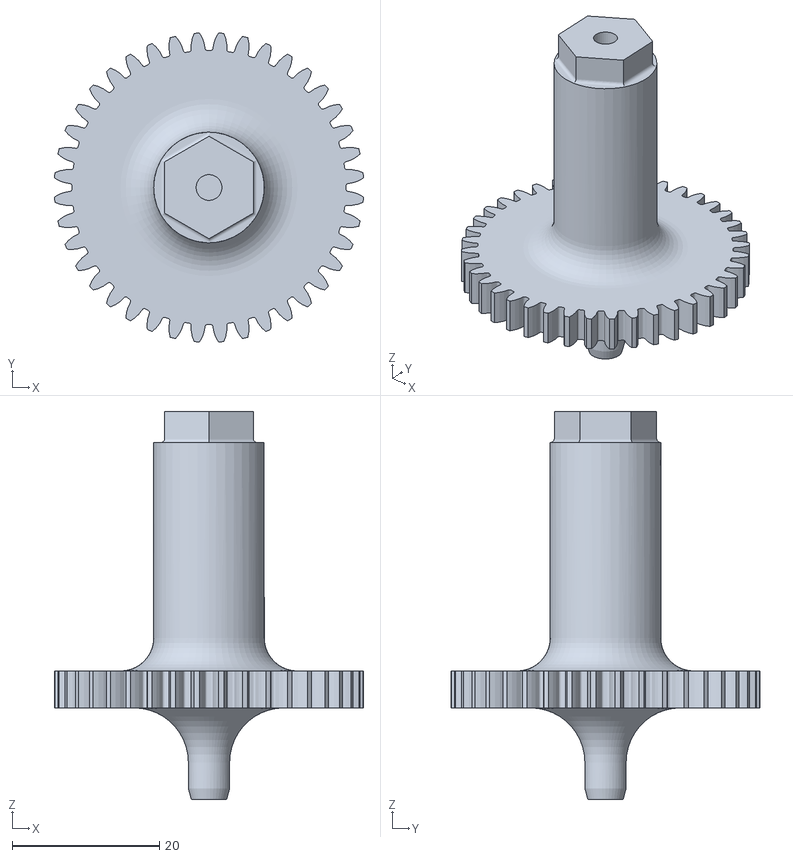
[picture p197: CAD file, 2023-12-04]
STLS/Gear_Driven_LARGE_V4.STL
41.9 x 41.9 x 52.6
