masteravinashdubey/2022-SBR-Development/Assembly/Gear_2.SLDPRT

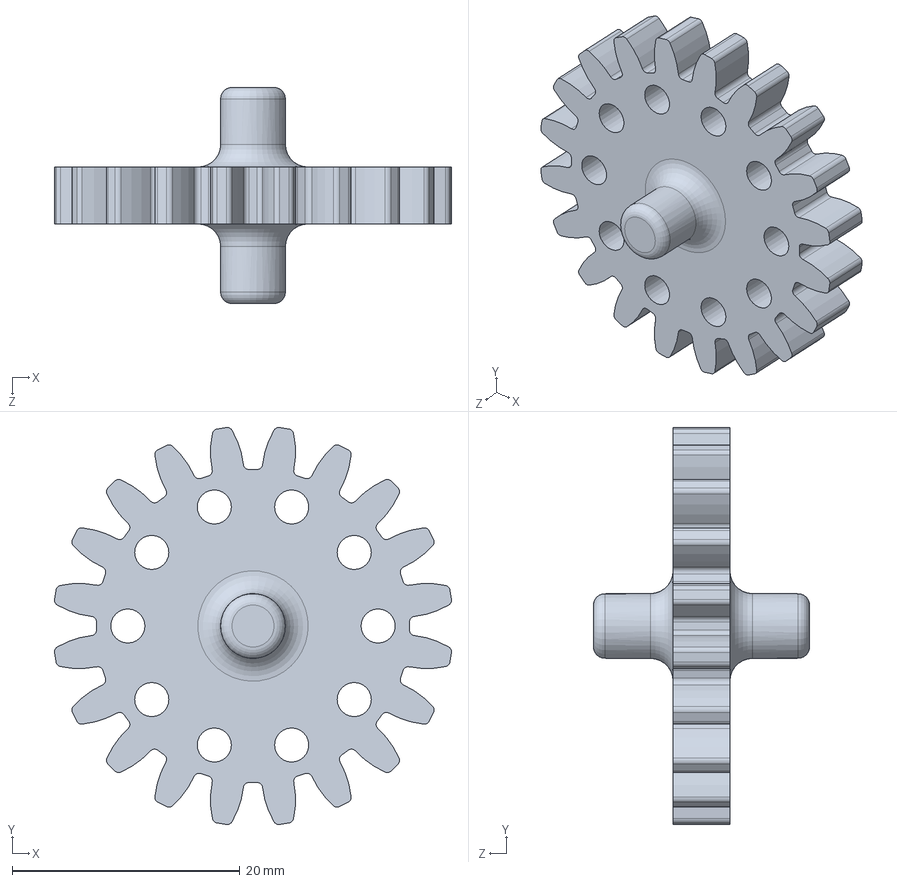
[picture p198: CAD file, 2023-12-04]
Assembly/Gear_2.SLDPRT
34.9 x 34.9 x 19.0 mm
