masteravinashdubey/2022-SBR-Development/Base components/Gear_Driver.SLDPRT

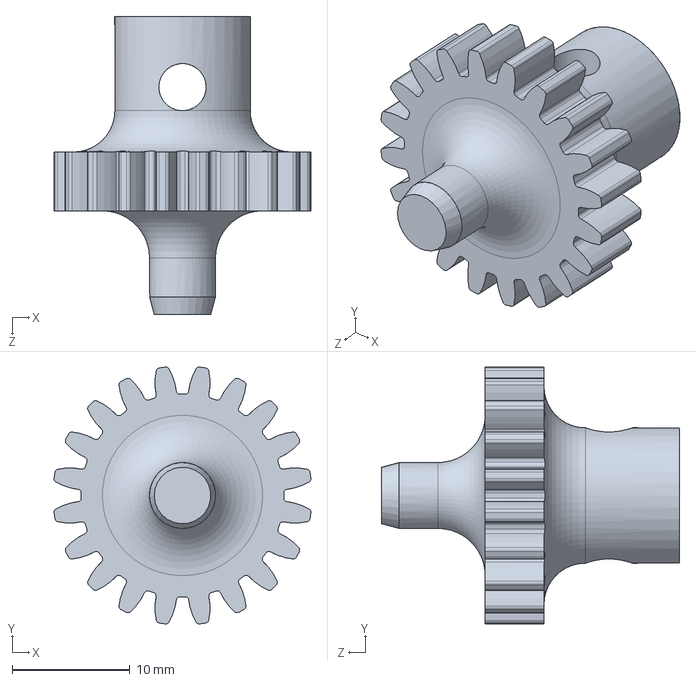
[picture p199: CAD file, 2023-12-04]
Base components/Gear_Driver.SLDPRT
21.8 x 21.8 x 25.3 mm
