masteravinashdubey/2022-SBR-Development/CAD FILES/COVERS/COVER_CYL.SLDPRT

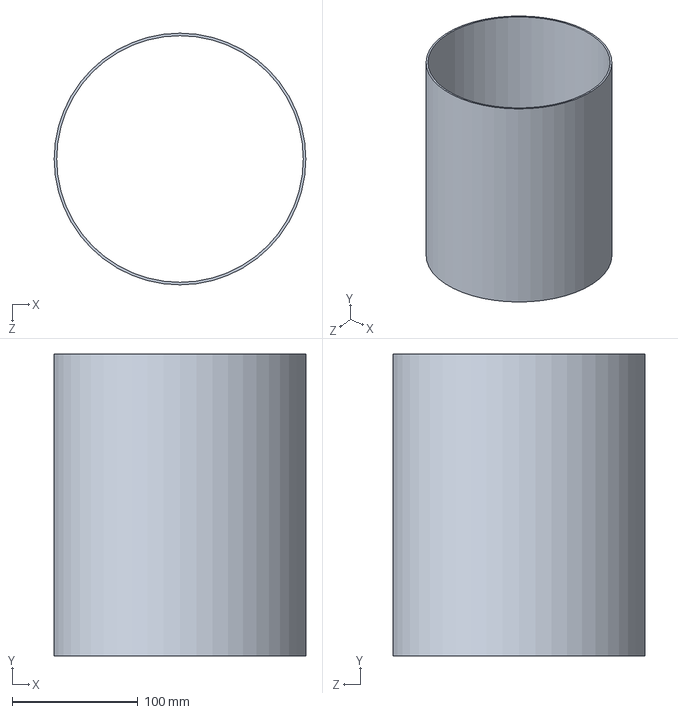
[picture p200: CAD file, 2023-12-04]
CAD FILES/COVERS/COVER_CYL.SLDPRT
200.0 x 240.0 x 200.0 mm
