masteravinashdubey/2022-SBR-Development/CAD FILES/SPACERS/SPACERS 4CM.SLDPRT

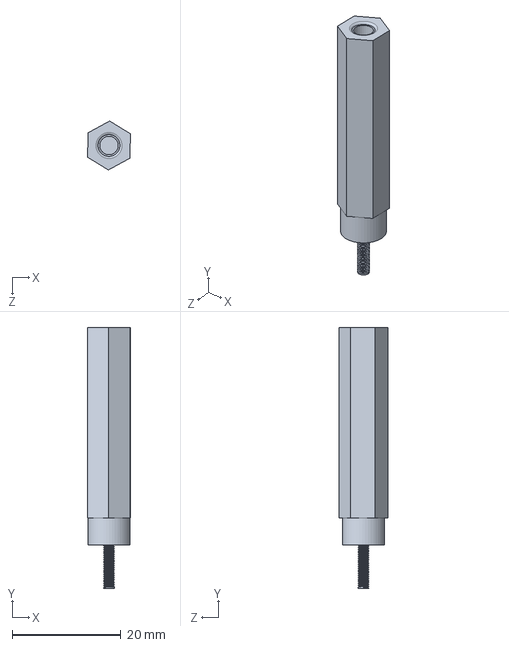
[picture p201: CAD file, 2023-12-04]
CAD FILES/SPACERS/SPACERS 4CM.SLDPRT
7.91 x 48.0 x 9.00 mm
