masteravinashdubey/2022-SBR-Development/Covers/Cover_Bottom_2.SLDPRT

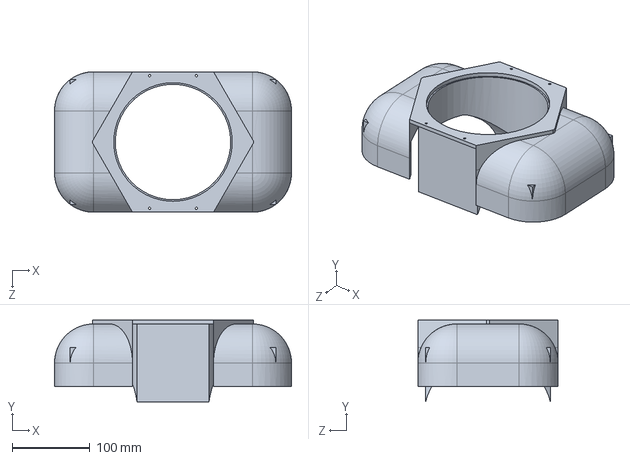
[picture p202: CAD file, 2023-12-04]
Covers/Cover_Bottom_2.SLDPRT
303.9 x 105.0 x 180.0 mm
