masteravinashdubey/2022-SBR-Development/Files for 3D printing/Stl files/30062022/G_Driver_F.STL

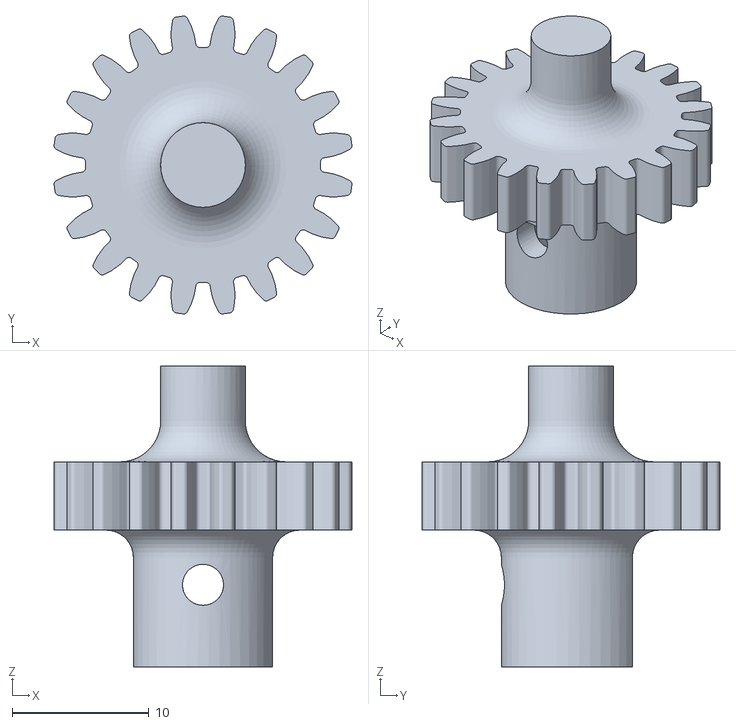
[picture p203: CAD file, 2023-12-04]
Files for 3D printing/Stl files/30062022/G_Driver_F.STL
21.8 x 21.8 x 22.0
