masteravinashdubey/2022-SBR-Development/Files for 3D printing/Stl files/Gear_Driver_V1.STL

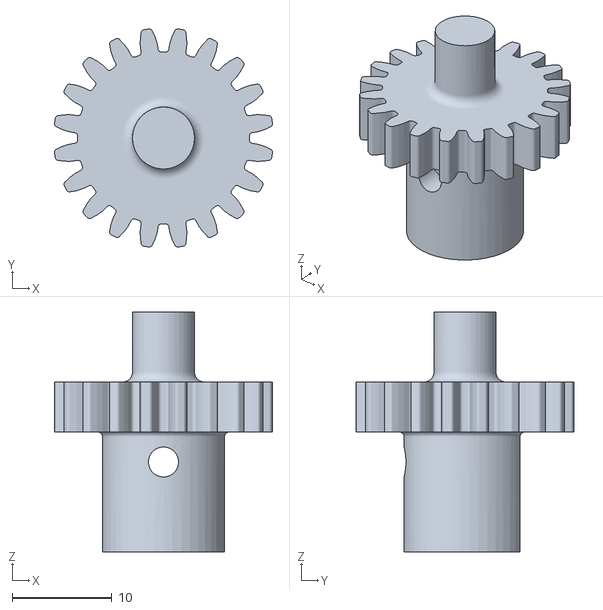
[picture p204: CAD file, 2023-12-04]
Files for 3D printing/Stl files/Gear_Driver_V1.STL
21.8 x 21.8 x 24.0
