masteravinashdubey/2022-SBR-Development/Parts/BOT design/BATTERY.SLDPRT

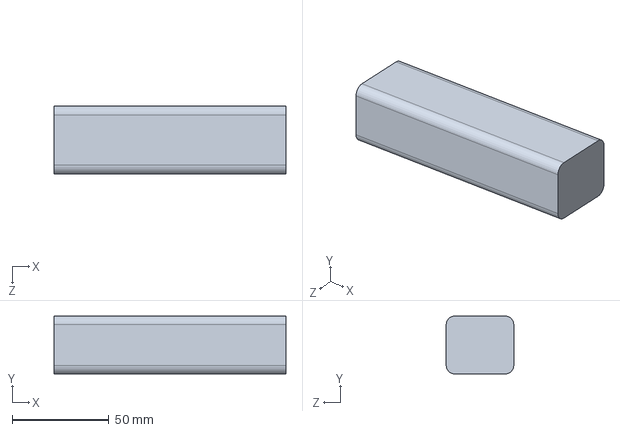
[picture p205: CAD file, 2023-12-04]
Parts/BOT design/BATTERY.SLDPRT
120.0 x 30.0 x 35.0 mm
