masteravinashdubey/2022-SBR-Development/Parts/BOT design/design ideas/battery slider slot.SLDPRT

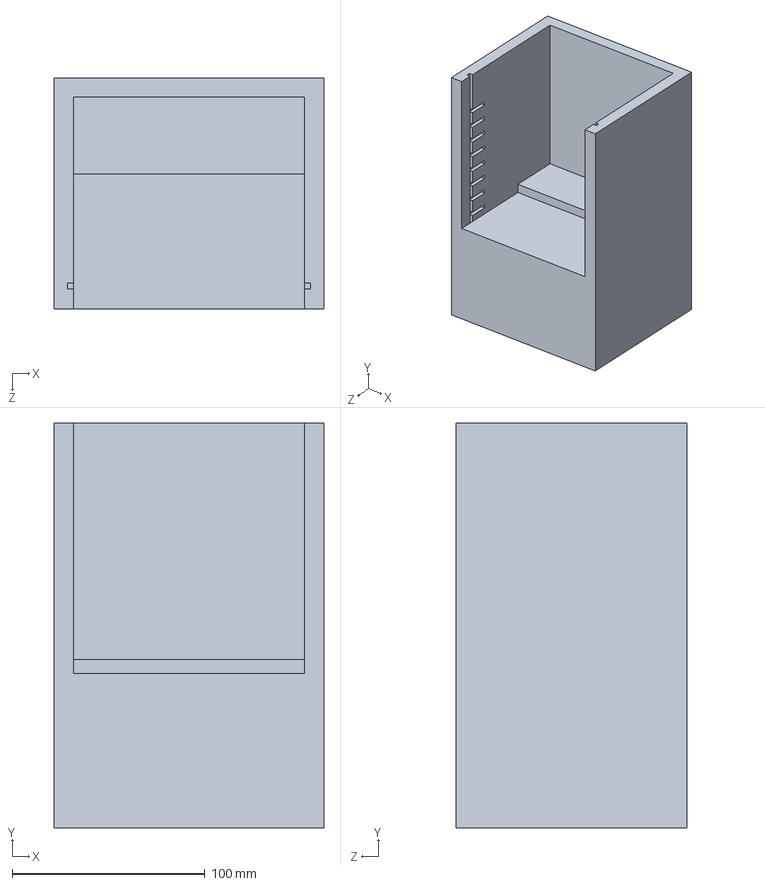
[picture p206: CAD file, 2023-12-04]
Parts/BOT design/design ideas/battery slider slot.SLDPRT
140.0 x 210.0 x 120.0 mm
