masteravinashdubey/2022-SBR-Development/Parts/BOT design/Parts/WHEEL/motor_adapter.SLDPRT

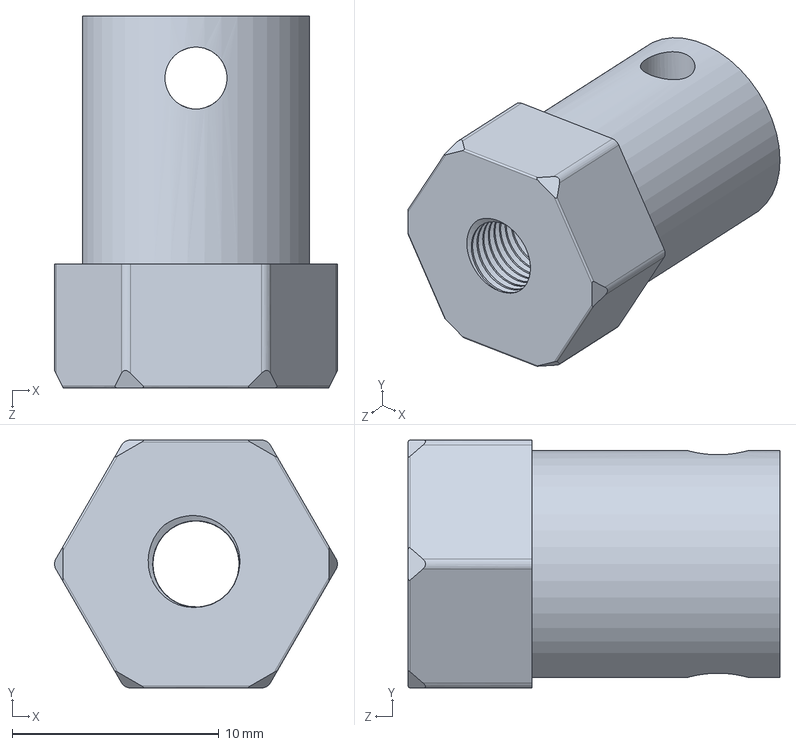
[picture p207: CAD file, 2023-12-04]
Parts/BOT design/Parts/WHEEL/motor_adapter.SLDPRT
13.7 x 12.0 x 18.0 mm
