masteravinashdubey/2022-SBR-Development/Plates/Gear_4.DXF

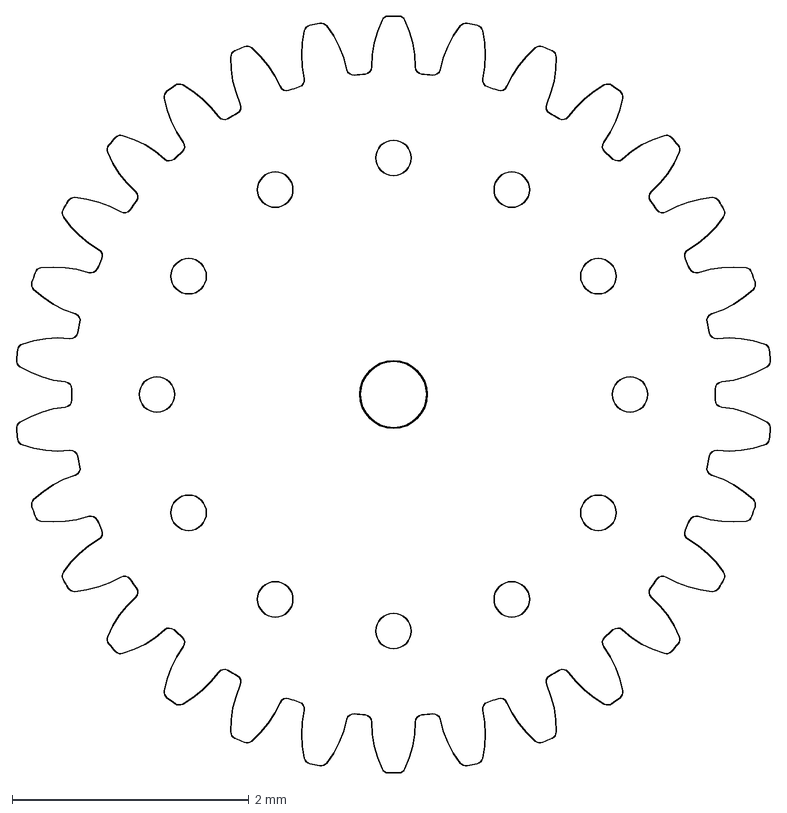
[picture p208: CAD file, 2023-12-04]
Plates/Gear_4.DXF
6.38 x 6.40 mm
