masteravinashdubey/2022-SBR-Development/sensors/BUZZER FC07/Pin Header - Single Row - Angled - 2.54 - 3x1.SLDPRT

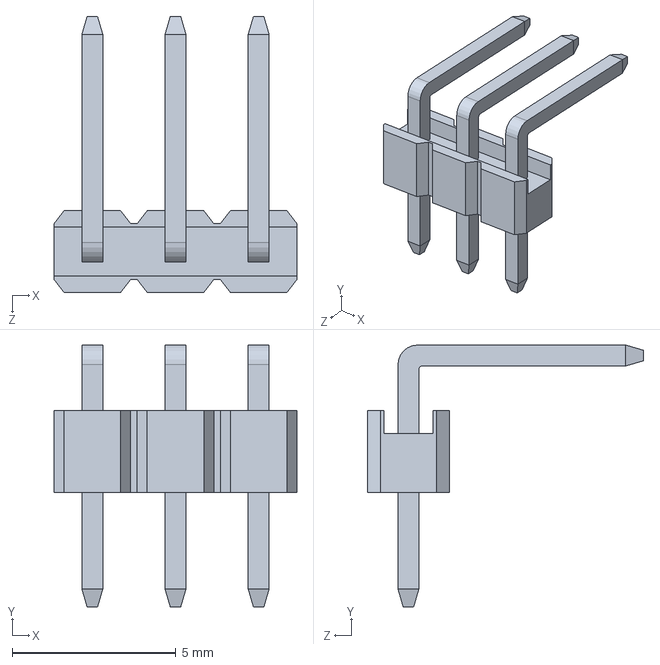
[picture p209: CAD file, 2023-12-04]
sensors/BUZZER FC07/Pin Header - Single Row - Angled - 2.54 - 3x1.SLDPRT
7.42 x 8.00 x 8.43 mm
