masteravinashdubey/2022-SBR-Development/sensors/Floor_Plates1.DXF

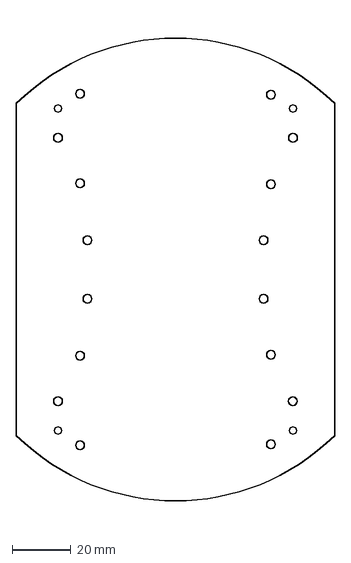
[picture p210: CAD file, 2023-12-04]
sensors/Floor_Plates1.DXF
108.3 x 172.4 mm
