masteravinashdubey/2022-SBR-Development/sensors/ULTRASONIC SENSOR/hc-sr04 part5.SLDPRT

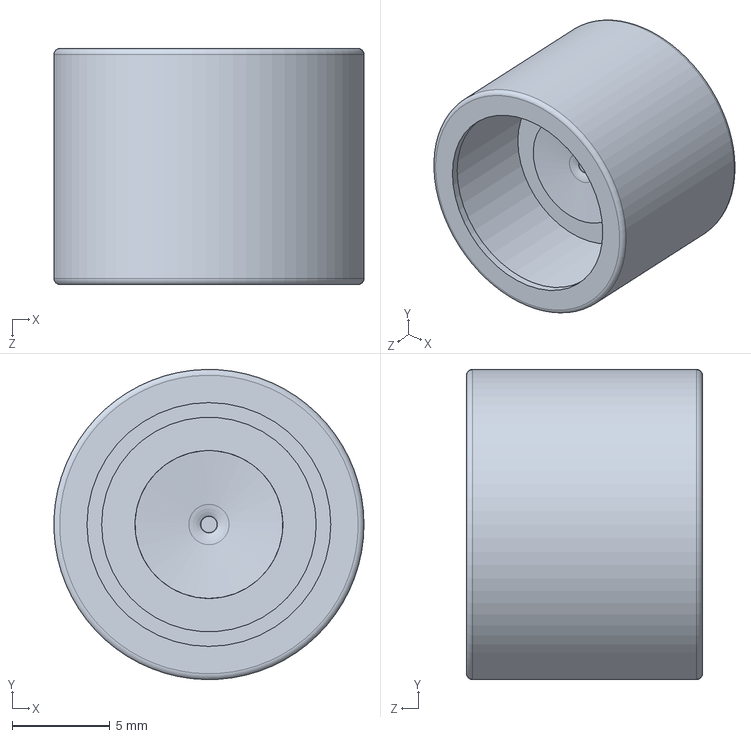
[picture p211: CAD file, 2023-12-04]
sensors/ULTRASONIC SENSOR/hc-sr04 part5.SLDPRT
15.9 x 15.9 x 12.1 mm
