masteravinashdubey/2022-SBR-Development/Spacers/3cm_spacers.SLDPRT

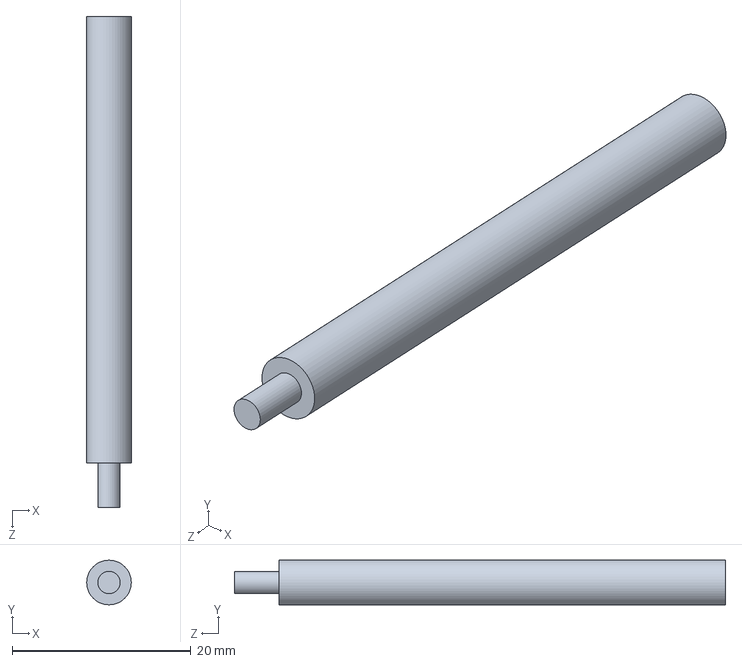
[picture p212: CAD file, 2023-12-04]
Spacers/3cm_spacers.SLDPRT
5.00 x 5.00 x 55.0 mm
