masteravinashdubey/2022-SBR-Development/Assembly/Gear_4.SLDPRT

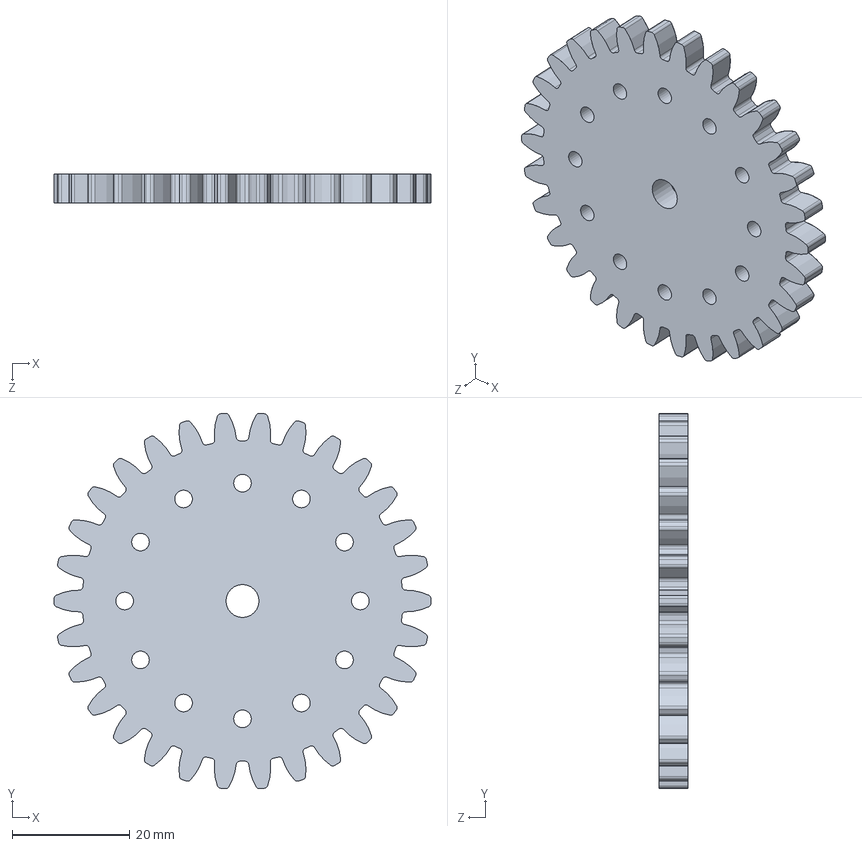
[picture p213: CAD file, 2023-12-04]
Assembly/Gear_4.SLDPRT
64.0 x 63.7 x 5.00 mm
