masteravinashdubey/2022-SBR-Development/Base components/eYFi_Mega.SLDPRT

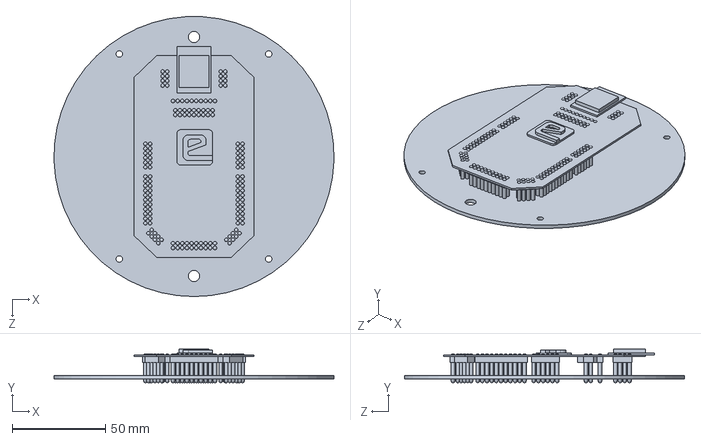
[picture p214: CAD file, 2023-12-04]
Base components/eYFi_Mega.SLDPRT
149.9 x 18.0 x 150.0 mm
