masteravinashdubey/2022-SBR-Development/CAD FILES/COVERS/COVER_2.SLDPRT

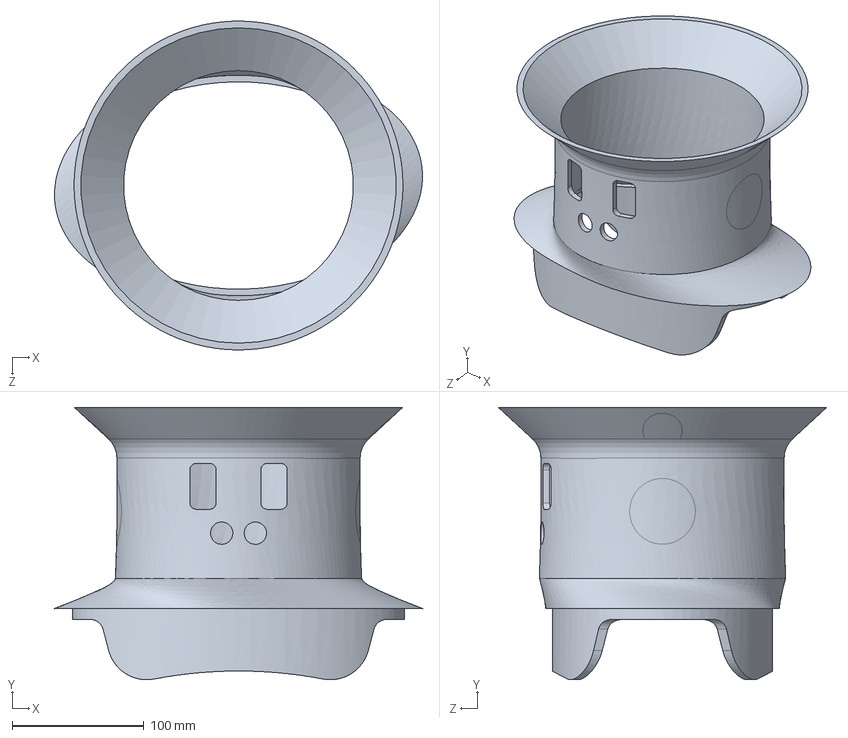
[picture p215: CAD file, 2023-12-04]
CAD FILES/COVERS/COVER_2.SLDPRT
279.8 x 207.1 x 250.0 mm
