masteravinashdubey/2022-SBR-Development/CAD FILES/TRAY_BATTERY.SLDPRT

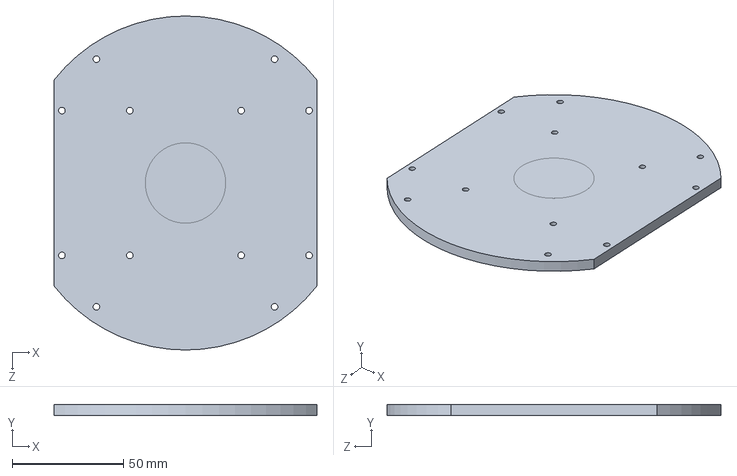
[picture p216: CAD file, 2023-12-04]
CAD FILES/TRAY_BATTERY.SLDPRT
118.0 x 5.01 x 150.0 mm
