masteravinashdubey/2022-SBR-Development/CAD FILES/WASTE/Battery Holder (SlotBased).SLDPRT

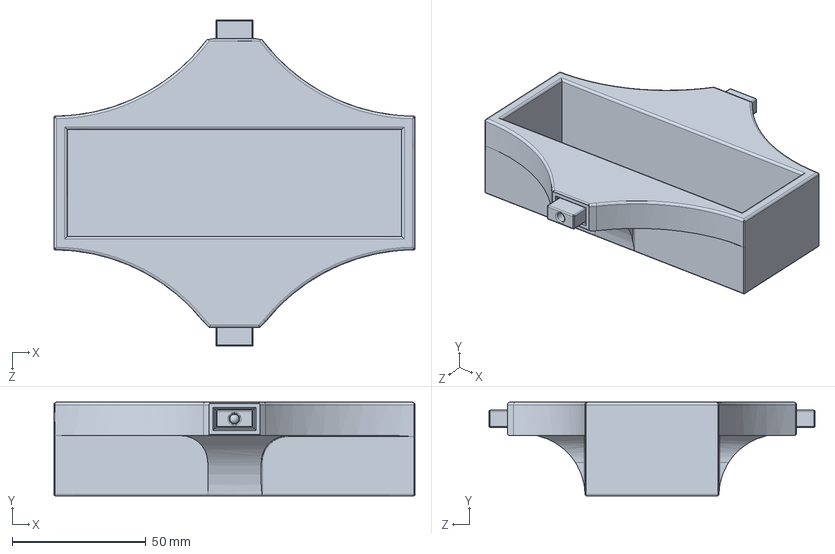
[picture p217: CAD file, 2023-12-04]
CAD FILES/WASTE/Battery Holder (SlotBased).SLDPRT
135.0 x 35.0 x 122.0 mm
