masteravinashdubey/2022-SBR-Development/Covers/Cover_mid.SLDPRT

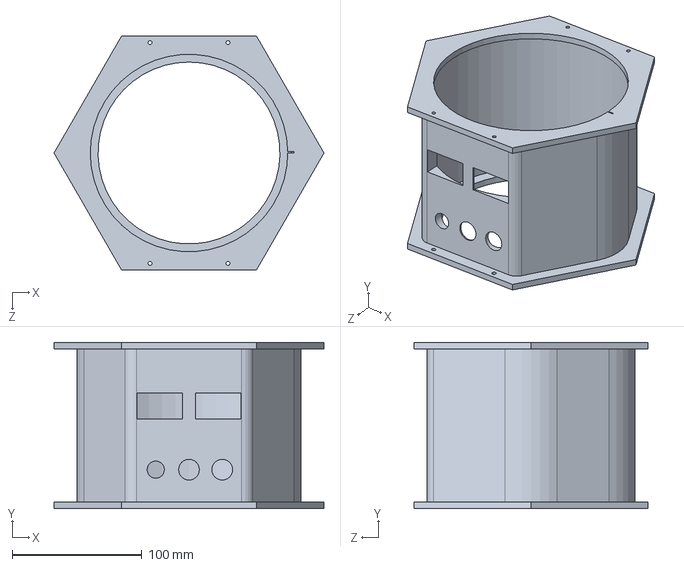
[picture p218: CAD file, 2023-12-04]
Covers/Cover_mid.SLDPRT
207.8 x 128.0 x 180.0 mm
