masteravinashdubey/2022-SBR-Development/Parts/BOT design/design ideas/battery slider.SLDPRT

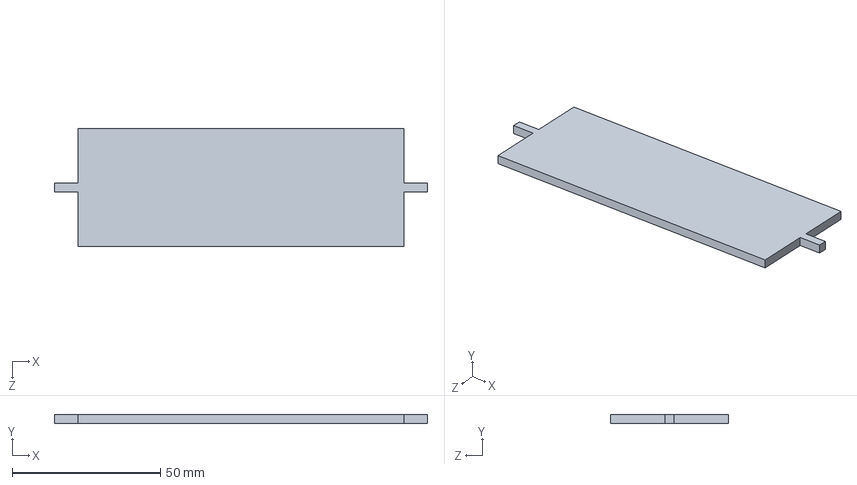
[picture p219: CAD file, 2023-12-04]
Parts/BOT design/design ideas/battery slider.SLDPRT
126.0 x 3.00 x 40.0 mm
