masteravinashdubey/2022-SBR-Development/Plates/Gear_3.DXF

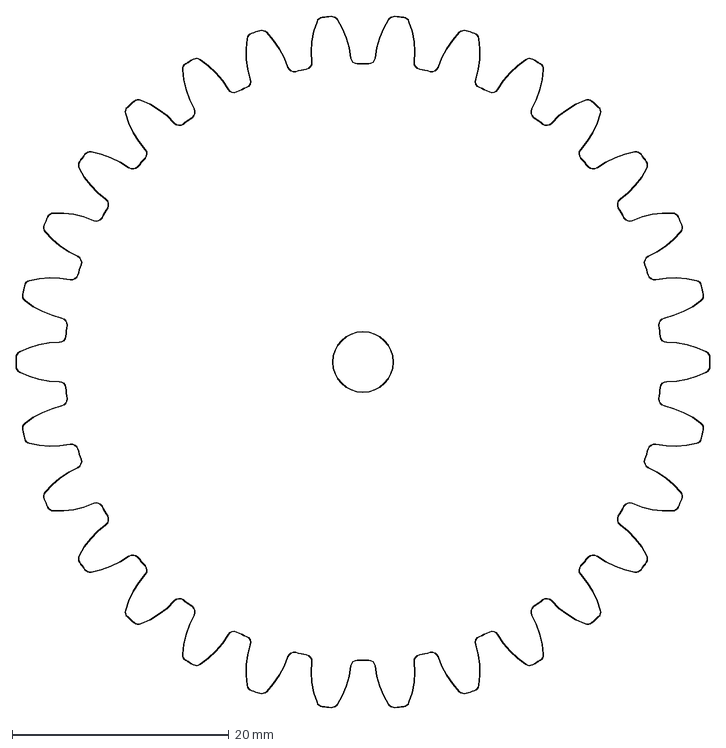
[picture p220: CAD file, 2023-12-04]
Plates/Gear_3.DXF
64.0 x 63.8 mm
