masteravinashdubey/2022-SBR-Development/sensors/BUZZER FC07/Resistor - SMD - 1206.SLDPRT

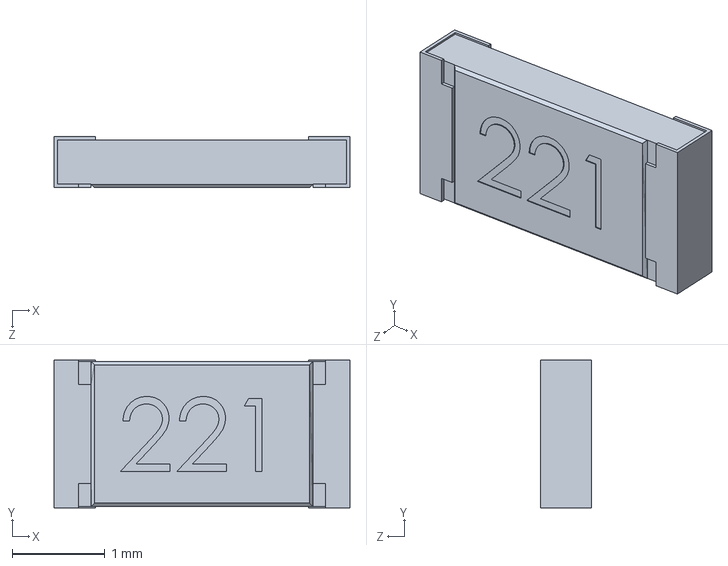
[picture p221: CAD file, 2023-12-04]
sensors/BUZZER FC07/Resistor - SMD - 1206.SLDPRT
3.20 x 1.60 x 0.55 mm
