masteravinashdubey/2022-SBR-Development/sensors/MF63zz 3x6x2.5mm Flanged Bearing.step.SLDPRT

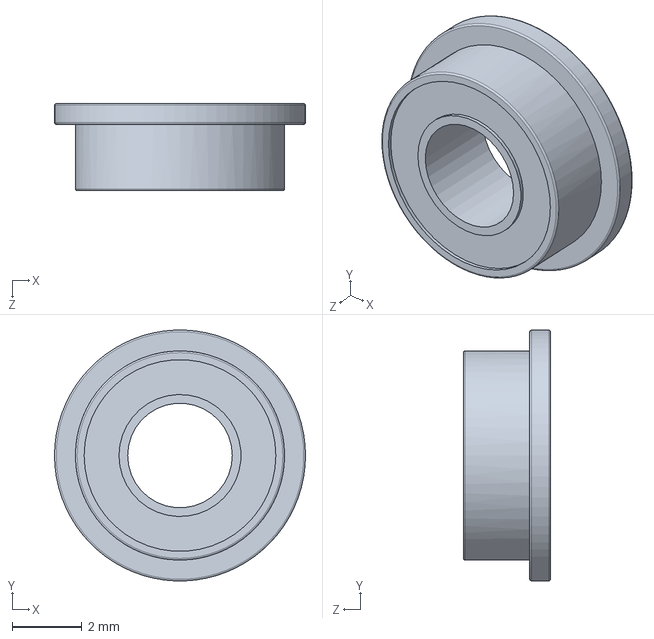
[picture p222: CAD file, 2023-12-04]
sensors/MF63zz 3x6x2.5mm Flanged Bearing.step.SLDPRT
7.20 x 7.19 x 2.50 mm
