masteravinashdubey/2022-SBR-Development/sensors/ULTRASONIC SENSOR/hc-sr04 part10.SLDPRT

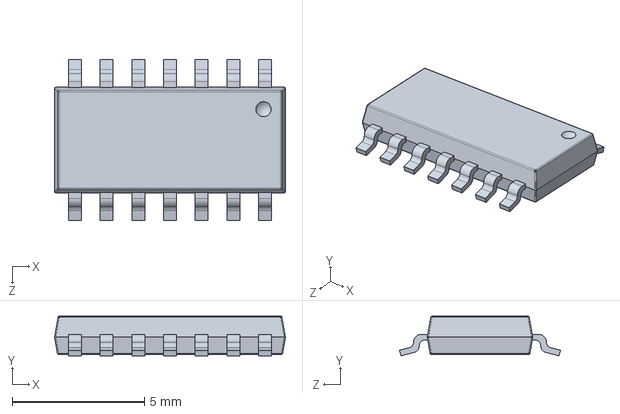
[picture p223: CAD file, 2023-12-04]
sensors/ULTRASONIC SENSOR/hc-sr04 part10.SLDPRT
8.75 x 1.51 x 6.10 mm
