masteravinashdubey/2022-SBR-Development/Spacers/BearingHolder.SLDPRT

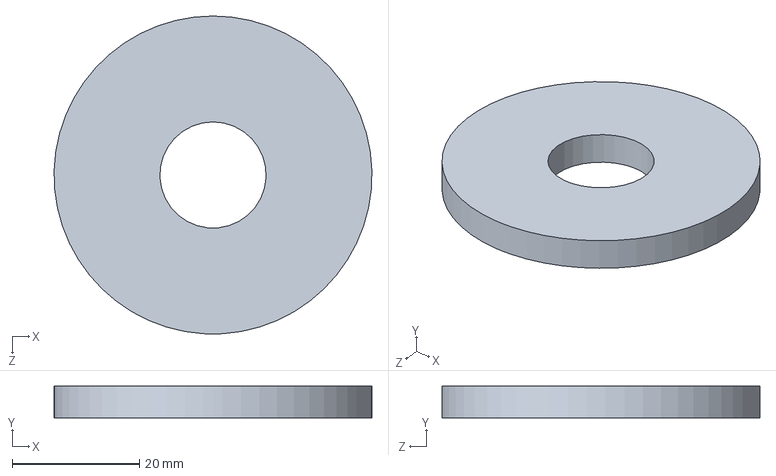
[picture p224: CAD file, 2023-12-04]
Spacers/BearingHolder.SLDPRT
50.0 x 5.00 x 50.0 mm
