masteravinashdubey/2022-SBR-Development/CAD FILES/COVERS/COVER_3.SLDPRT

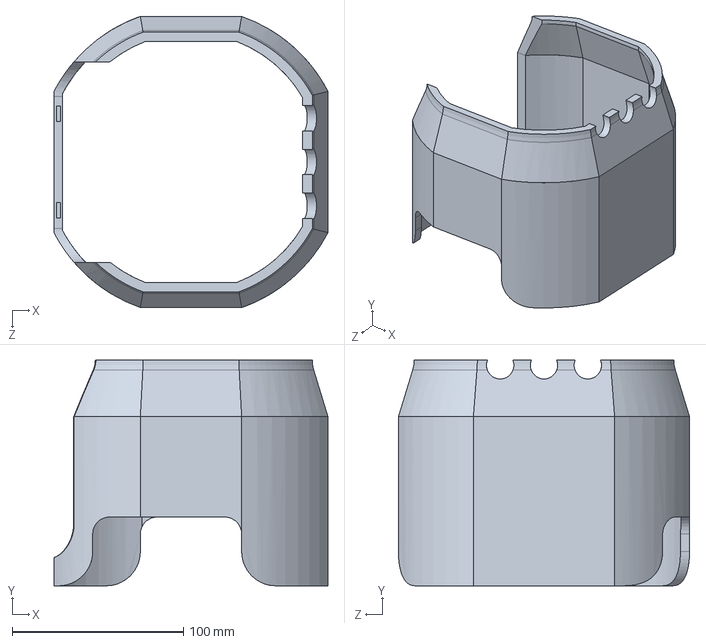
[picture p225: CAD file, 2023-12-04]
CAD FILES/COVERS/COVER_3.SLDPRT
160.0 x 131.8 x 170.0 mm
