masteravinashdubey/2022-SBR-Development/CAD FILES/Gear_Driven.SLDPRT

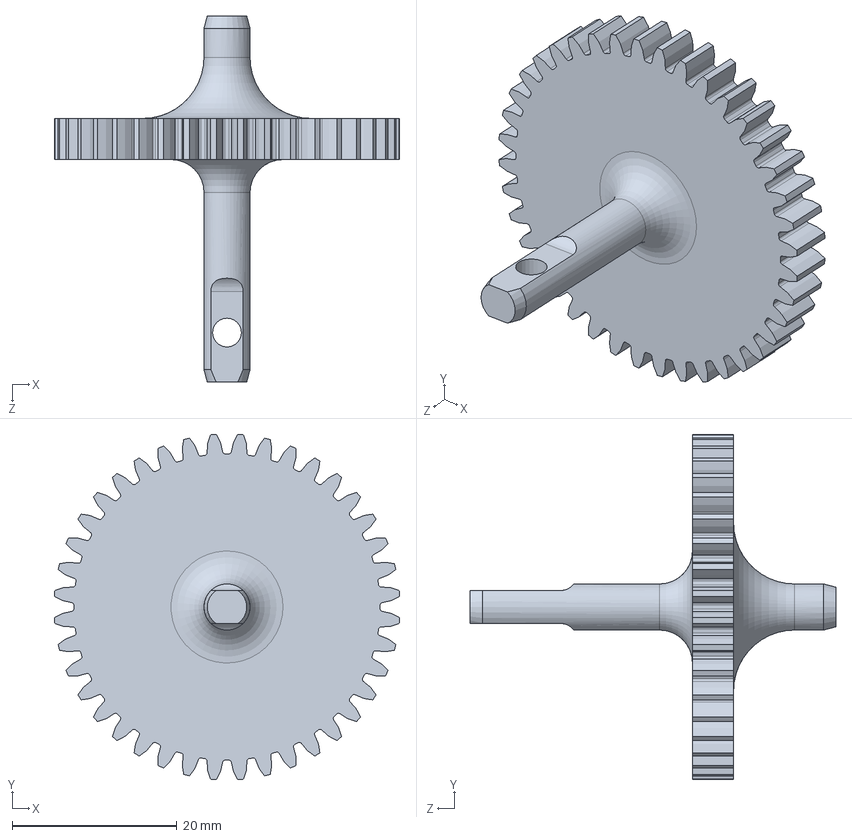
[picture p226: CAD file, 2023-12-04]
CAD FILES/Gear_Driven.SLDPRT
41.9 x 41.9 x 44.4 mm
