masteravinashdubey/2022-SBR-Development/CAD FILES/WASTE/RodTop_BulblockModel.SLDPRT

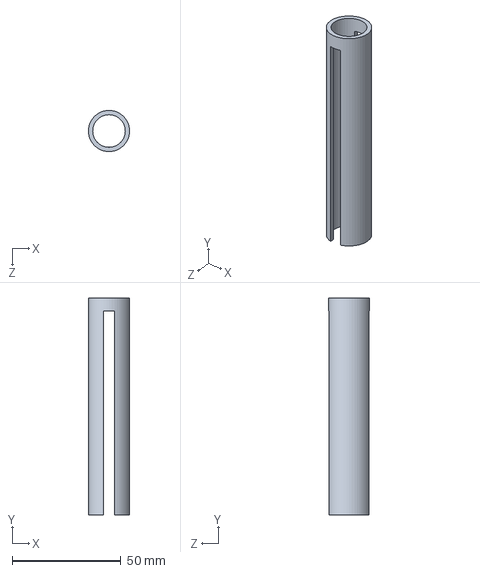
[picture p227: CAD file, 2023-12-04]
CAD FILES/WASTE/RodTop_BulblockModel.SLDPRT
19.0 x 100.0 x 19.0 mm
