masteravinashdubey/2022-SBR-Development/Covers/Hex_Cover.SLDPRT

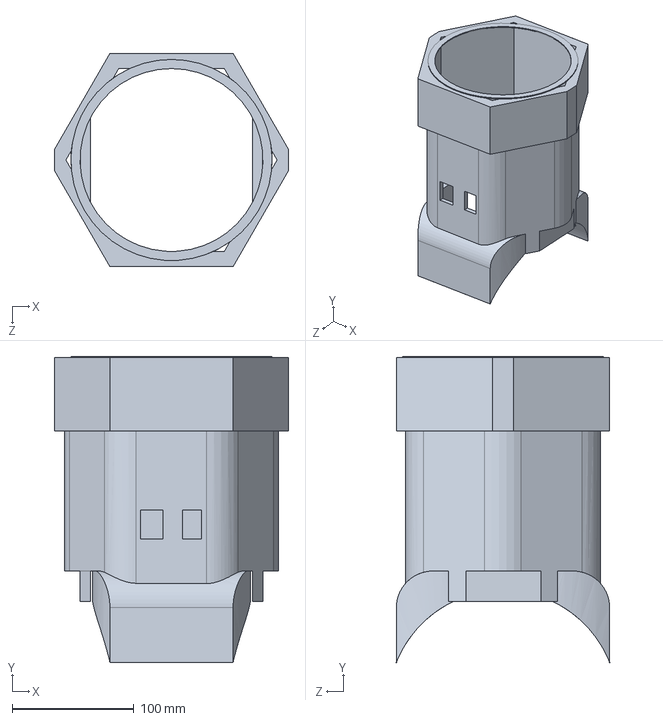
[picture p228: CAD file, 2023-12-04]
Covers/Hex_Cover.SLDPRT
192.1 x 251.0 x 175.0 mm
