masteravinashdubey/2022-SBR-Development/Files for 3D printing/Stl files/Gear_Driven.STL

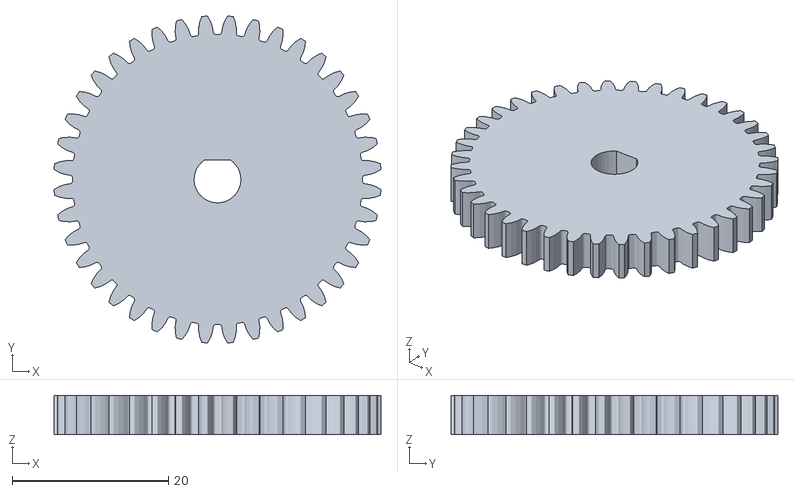
[picture p229: CAD file, 2023-12-04]
Files for 3D printing/Stl files/Gear_Driven.STL
41.9 x 41.9 x 5.00
