masteravinashdubey/2022-SBR-Development/Parts/BOT design/Pil2.STEP

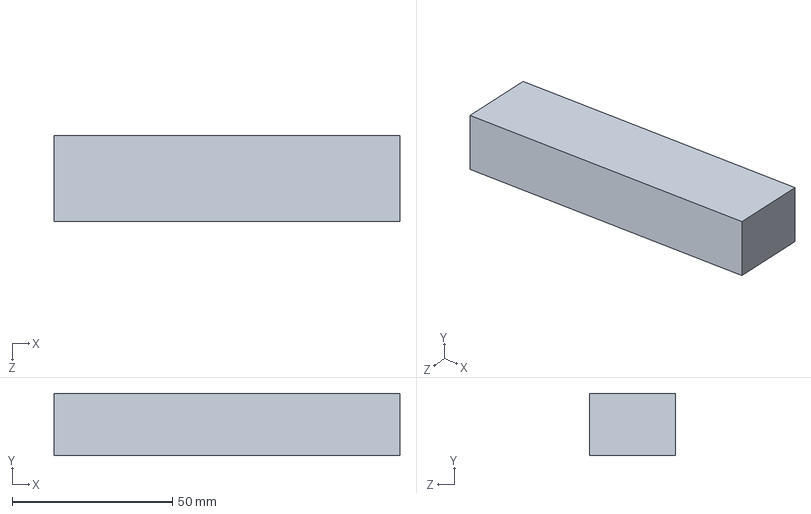
[picture p230: CAD file, 2023-12-04]
Parts/BOT design/Pil2.STEP
108.0 x 19.5 x 27.0 mm
