masteravinashdubey/2022-SBR-Development/sensors/ULTRASONIC SENSOR/hc-sr04 part7.SLDPRT

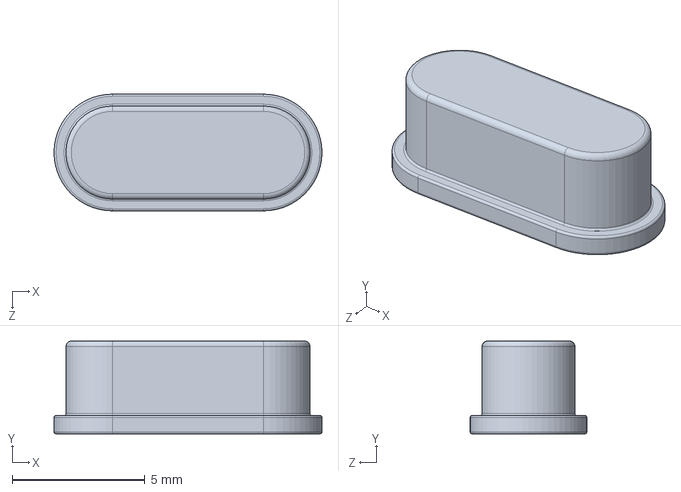
[picture p231: CAD file, 2023-12-04]
sensors/ULTRASONIC SENSOR/hc-sr04 part7.SLDPRT
10.1 x 3.50 x 4.40 mm
