masteravinashdubey/2022-SBR-Development/Spacers/Hex.SLDPRT

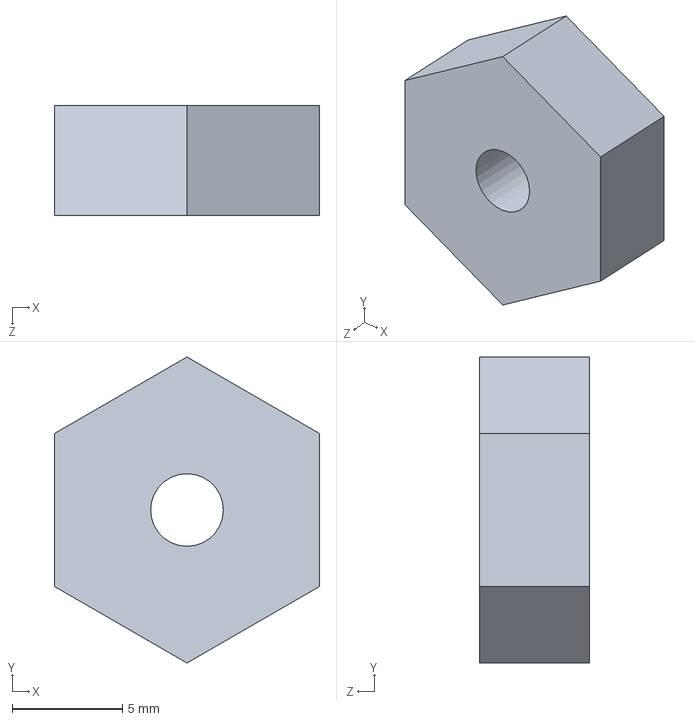
[picture p232: CAD file, 2023-12-04]
Spacers/Hex.SLDPRT
12.0 x 13.9 x 5.00 mm
