masteravinashdubey/2022-SBR-Development/Base components/IG32 MOTORS.SLDPRT

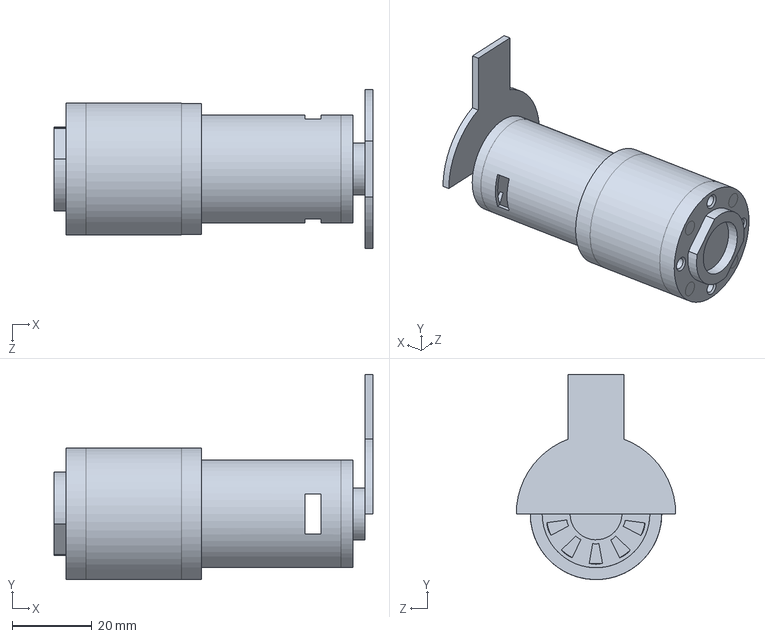
[picture p234: CAD file, 2023-12-04]
Base components/IG32 MOTORS.SLDPRT
80.0 x 51.5 x 40.0 mm
