masteravinashdubey/2022-SBR-Development/CAD FILES/BASE PLATE COMPACT.SLDPRT

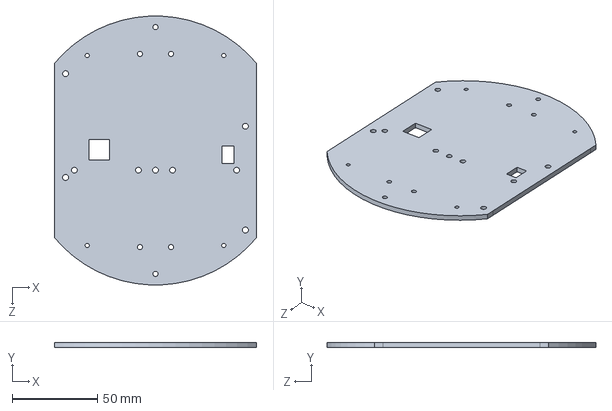
[picture p235: CAD file, 2023-12-04]
CAD FILES/BASE PLATE COMPACT.SLDPRT
118.3 x 3.00 x 157.4 mm
