masteravinashdubey/2022-SBR-Development/CAD FILES/WASTE/HexNut.SLDPRT

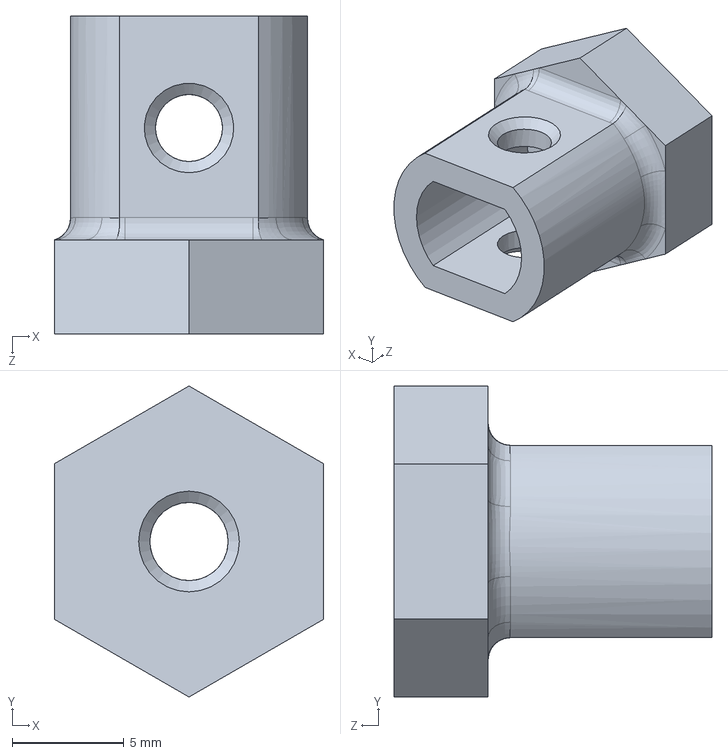
[picture p236: CAD file, 2023-12-04]
CAD FILES/WASTE/HexNut.SLDPRT
12.0 x 13.9 x 14.2 mm
