masteravinashdubey/2022-SBR-Development/Covers/Cover_Bottom.SLDPRT

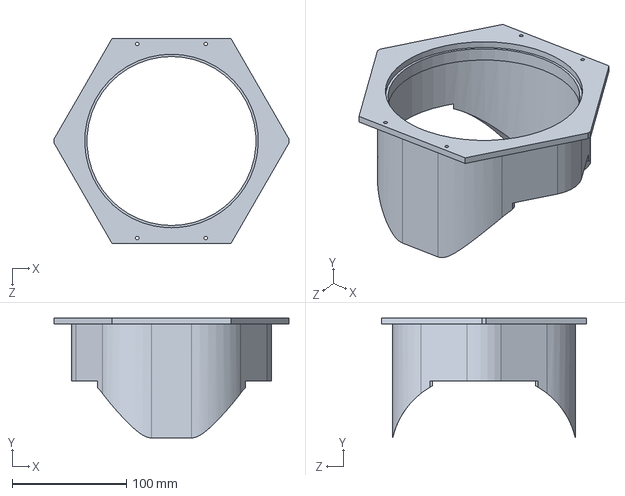
[picture p237: CAD file, 2023-12-04]
Covers/Cover_Bottom.SLDPRT
205.8 x 105.0 x 180.0 mm
