masteravinashdubey/2022-SBR-Development/Files for 3D printing/Stl files/Gear_Driver.STL

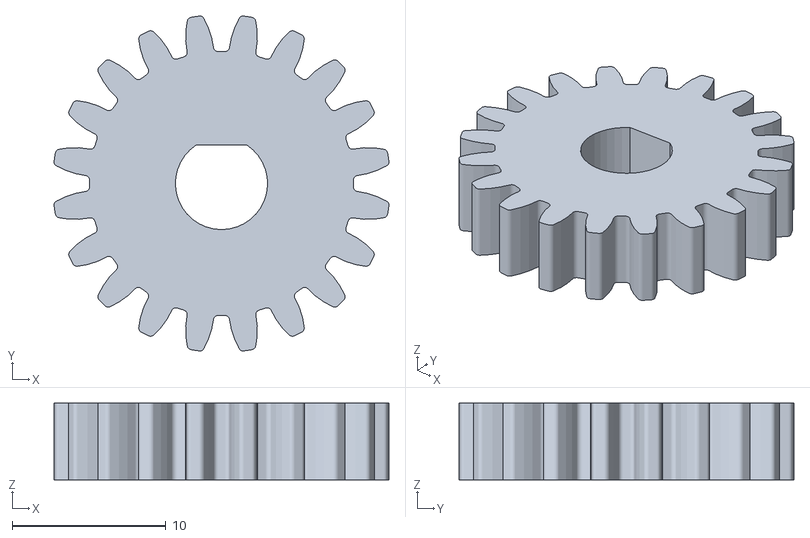
[picture p238: CAD file, 2023-12-04]
Files for 3D printing/Stl files/Gear_Driver.STL
21.8 x 21.8 x 5.00
