masteravinashdubey/2022-SBR-Development/Plates/Hex.DXF

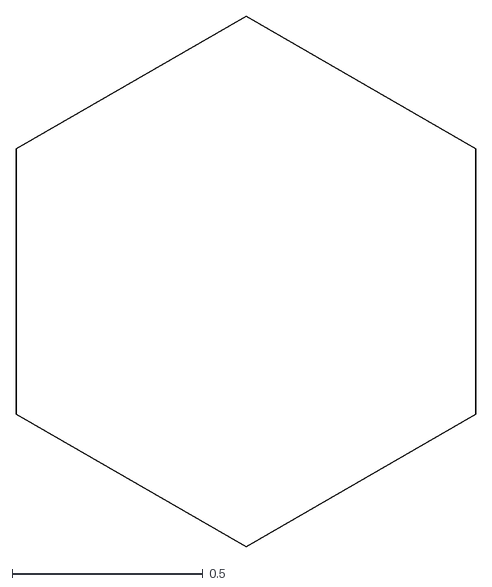
[picture p239: CAD file, 2023-12-04]
Plates/Hex.DXF
1.20 x 1.39
