masteravinashdubey/2022-SBR-Development/sensors/BUZZER FC07/Transistör - SMD - BC817 NPN - SOT23.SLDPRT

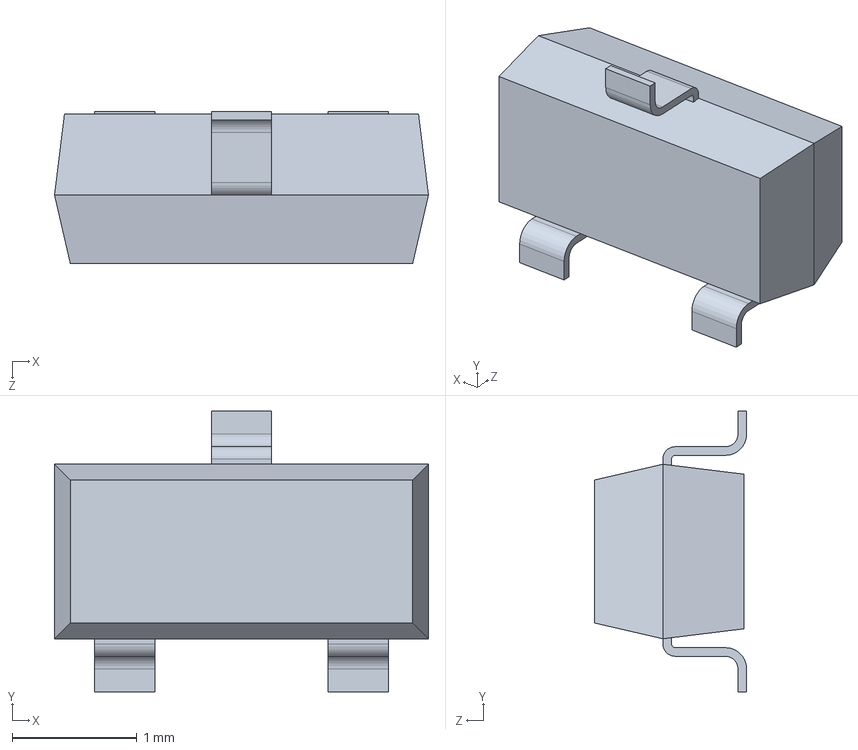
[picture p240: CAD file, 2023-12-04]
sensors/BUZZER FC07/Transistör - SMD - BC817 NPN - SOT23.SLDPRT
3.00 x 2.25 x 1.22 mm
