masteravinashdubey/2022-SBR-Development/sensors/OLED.SLDPRT

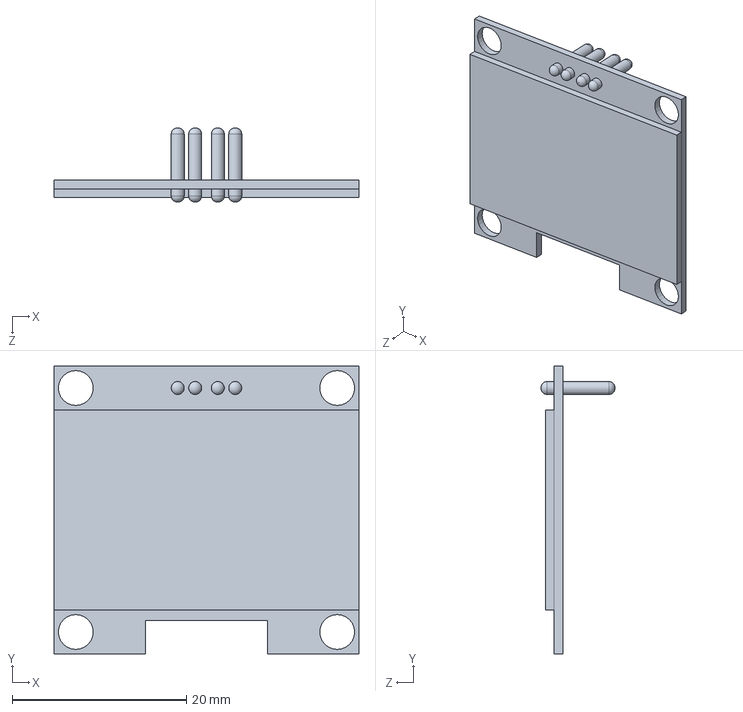
[picture p241: CAD file, 2023-12-04]
sensors/OLED.SLDPRT
35.0 x 33.0 x 8.50 mm
