masteravinashdubey/2022-SBR-Development/sensors/ULTRASONIC SENSOR/hc-sr04 part11.SLDPRT

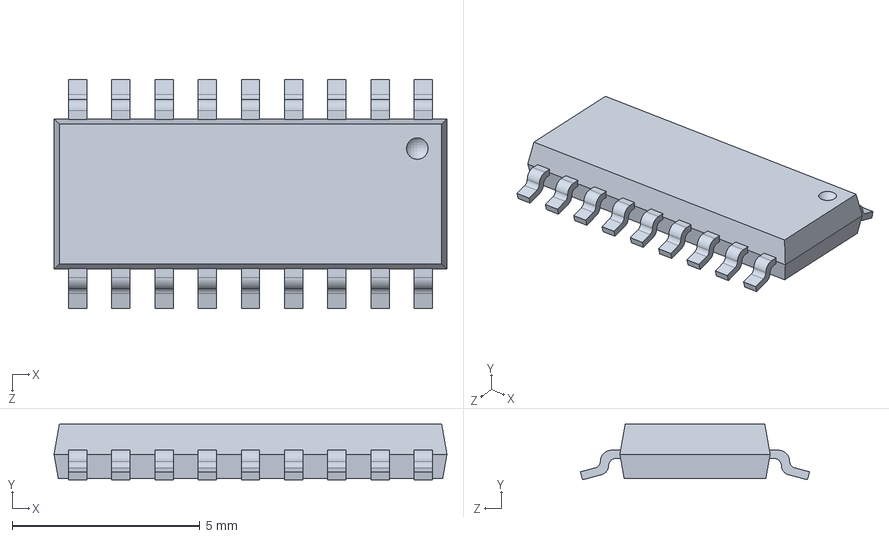
[picture p242: CAD file, 2023-12-04]
sensors/ULTRASONIC SENSOR/hc-sr04 part11.SLDPRT
10.5 x 1.48 x 6.10 mm
