masteravinashdubey/2022-SBR-Development/Base components/Bearing_large.SLDPRT

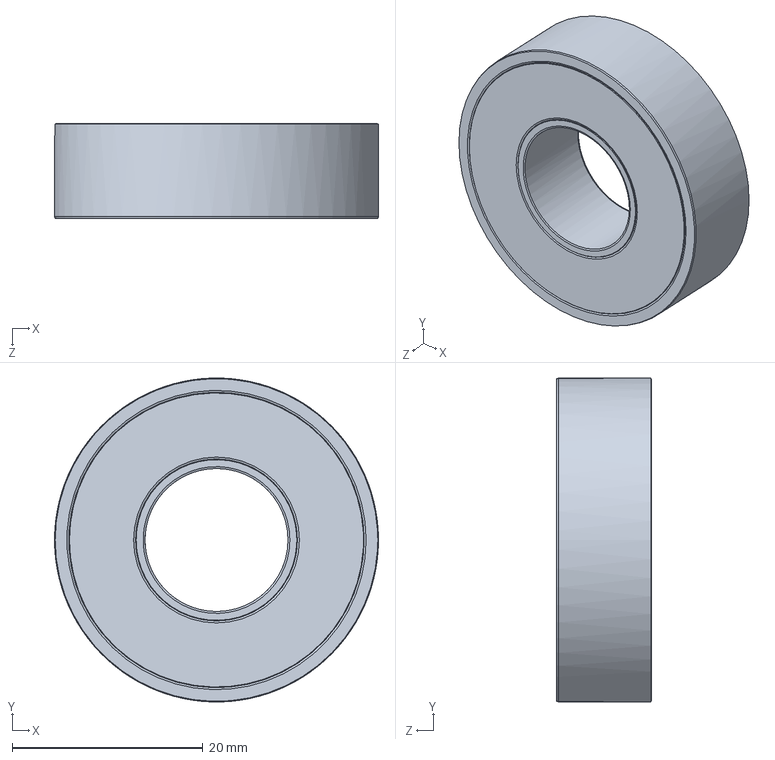
[picture p243: CAD file, 2023-12-04]
Base components/Bearing_large.SLDPRT
34.0 x 34.0 x 10.0 mm
