masteravinashdubey/2022-SBR-Development/CAD FILES/BATTERY.SLDPRT

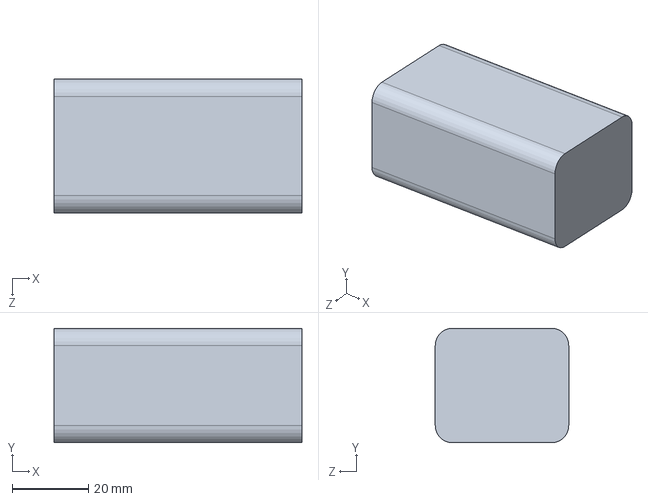
[picture p244: CAD file, 2023-12-04]
CAD FILES/BATTERY.SLDPRT
65.0 x 30.0 x 35.0 mm
