masteravinashdubey/2022-SBR-Development/CAD FILES/WASTE/WindowWall.SLDPRT

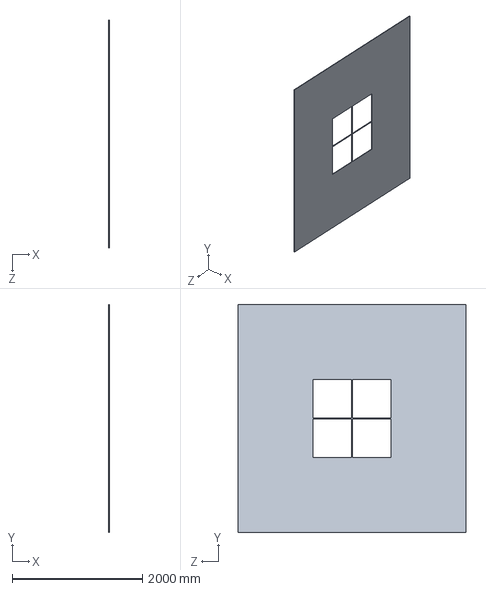
[picture p245: CAD file, 2023-12-04]
CAD FILES/WASTE/WindowWall.SLDPRT
10.0 x 3500.0 x 3500.0 mm
