masteravinashdubey/2022-SBR-Development/Files for 3D printing/Stl files/BASE PLATE COMPACT_V1.STL

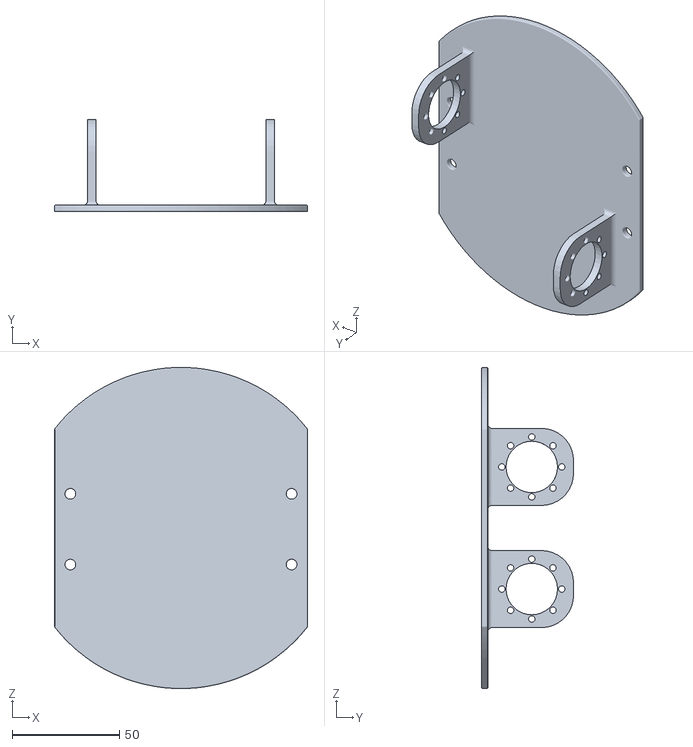
[picture p246: CAD file, 2023-12-04]
Files for 3D printing/Stl files/BASE PLATE COMPACT_V1.STL
118.3 x 43.0 x 149.9
