masteravinashdubey/2022-SBR-Development/Plates/plate2.DXF

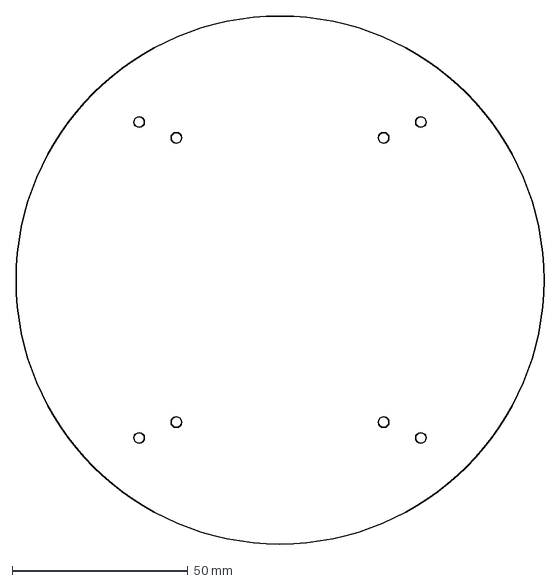
[picture p247: CAD file, 2023-12-04]
Plates/plate2.DXF
150.0 x 150.0 mm
