masteravinashdubey/2022-SBR-Development/sensors/PIR SENSOR.SLDPRT

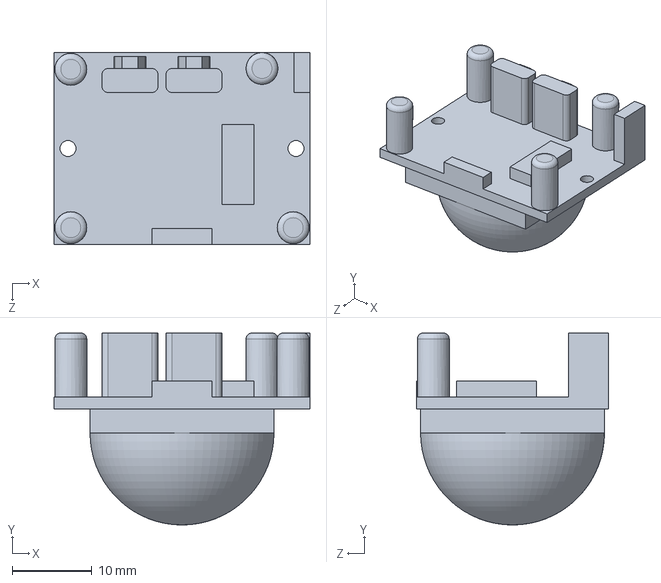
[picture p248: CAD file, 2023-12-04]
sensors/PIR SENSOR.SLDPRT
32.0 x 24.0 x 24.0 mm
