masteravinashdubey/2022-SBR-Development/sensors/ULTRASONIC SENSOR/hc-sr04 part13.SLDPRT

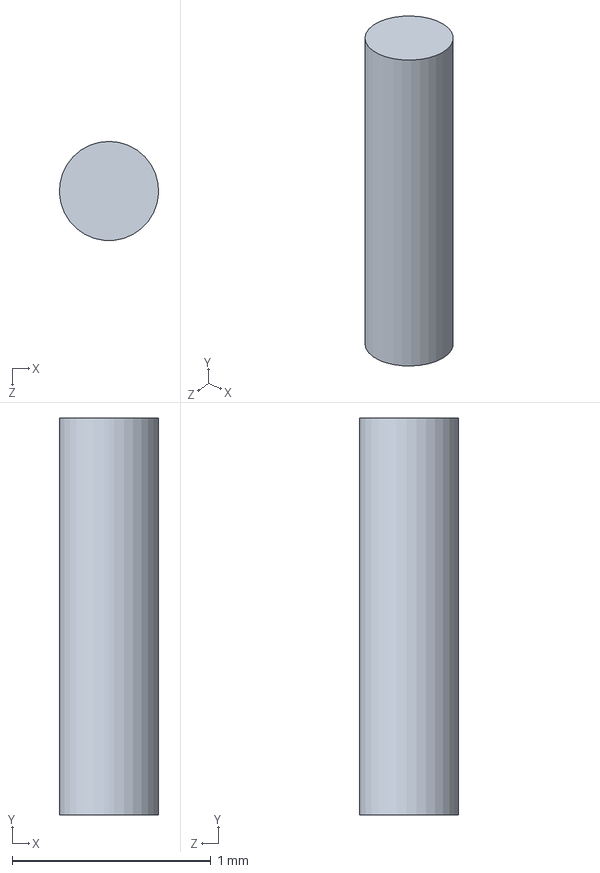
[picture p249: CAD file, 2023-12-04]
sensors/ULTRASONIC SENSOR/hc-sr04 part13.SLDPRT
0.499 x 2.00 x 0.5 mm
