masteravinashdubey/2022-SBR-Development/Spacers/Plate 2.SLDPRT

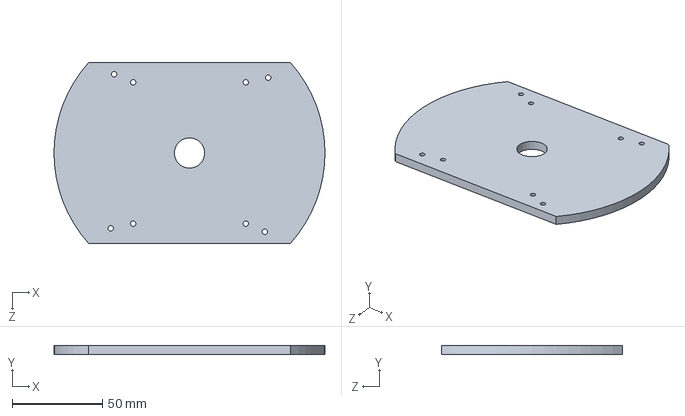
[picture p250: CAD file, 2023-12-04]
Spacers/Plate 2.SLDPRT
150.0 x 5.00 x 100.0 mm
