masteravinashdubey/2022-SBR-Development/CAD FILES/Motor Driver.SLDPRT

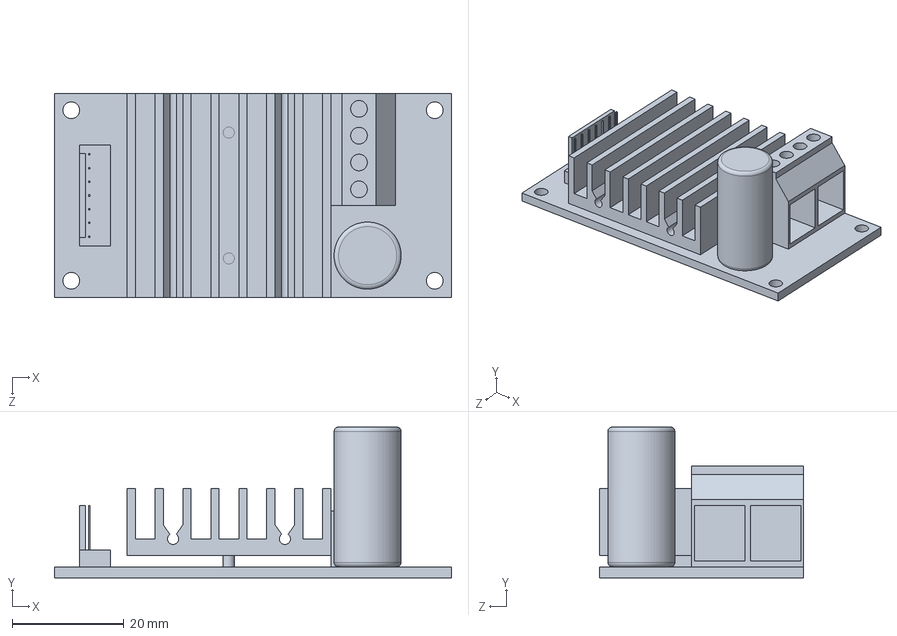
[picture p251: CAD file, 2023-12-04]
CAD FILES/Motor Driver.SLDPRT
71.0 x 27.0 x 36.5 mm
