masteravinashdubey/2022-SBR-Development/Covers/Cover_Bottom3.SLDPRT

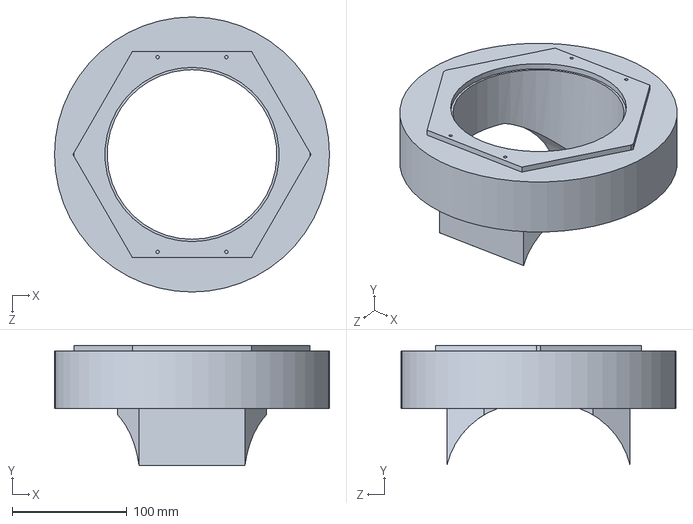
[picture p252: CAD file, 2023-12-04]
Covers/Cover_Bottom3.SLDPRT
240.0 x 105.0 x 240.0 mm
