masteravinashdubey/2022-SBR-Development/Plates/Bearing_holder.DXF

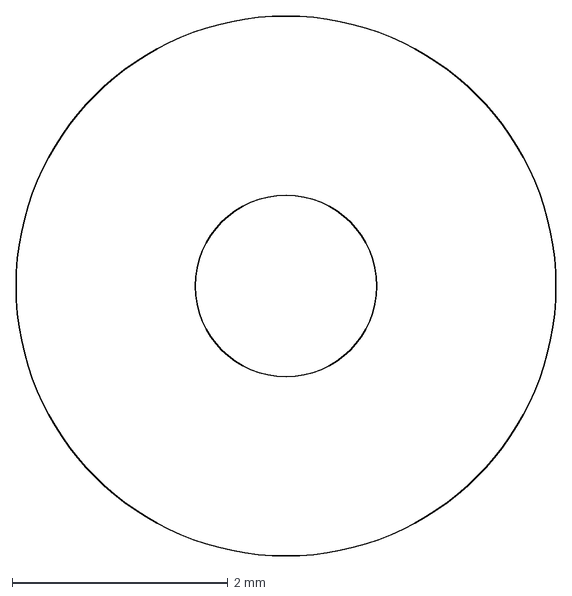
[picture p253: CAD file, 2023-12-04]
Plates/Bearing_holder.DXF
5.00 x 5.00 mm
