masteravinashdubey/2022-SBR-Development/sensors/OV7670.SLDPRT

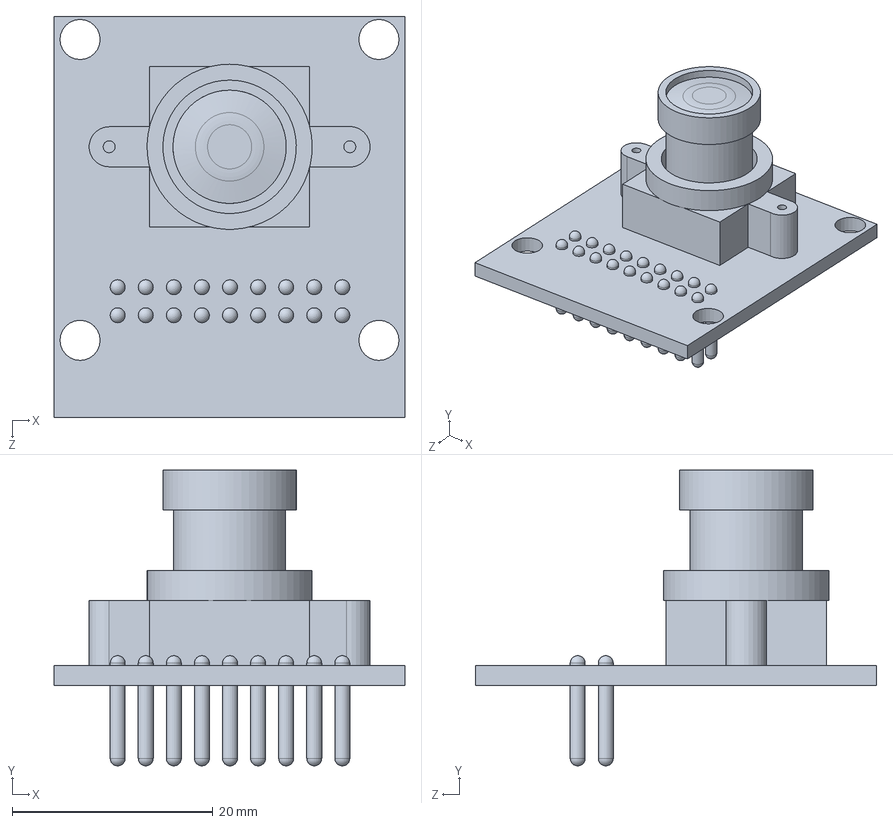
[picture p254: CAD file, 2023-12-04]
sensors/OV7670.SLDPRT
35.0 x 29.5 x 40.0 mm
