masteravinashdubey/2022-SBR-Development/sensors/ULTRASONIC SENSOR/hc-sr04 part6.SLDPRT

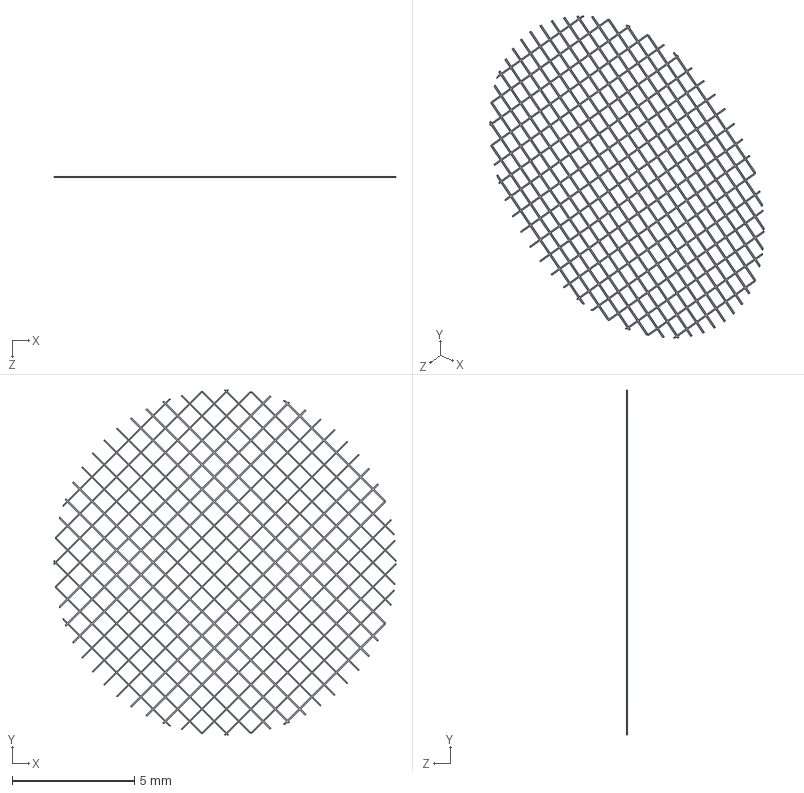
[picture p255: CAD file, 2023-12-04]
sensors/ULTRASONIC SENSOR/hc-sr04 part6.SLDPRT
14.0 x 14.1 x 0.05 mm
