masteravinashdubey/2022-SBR-Development/CAD FILES/GEAR_DRIVEN_LARGE.SLDPRT

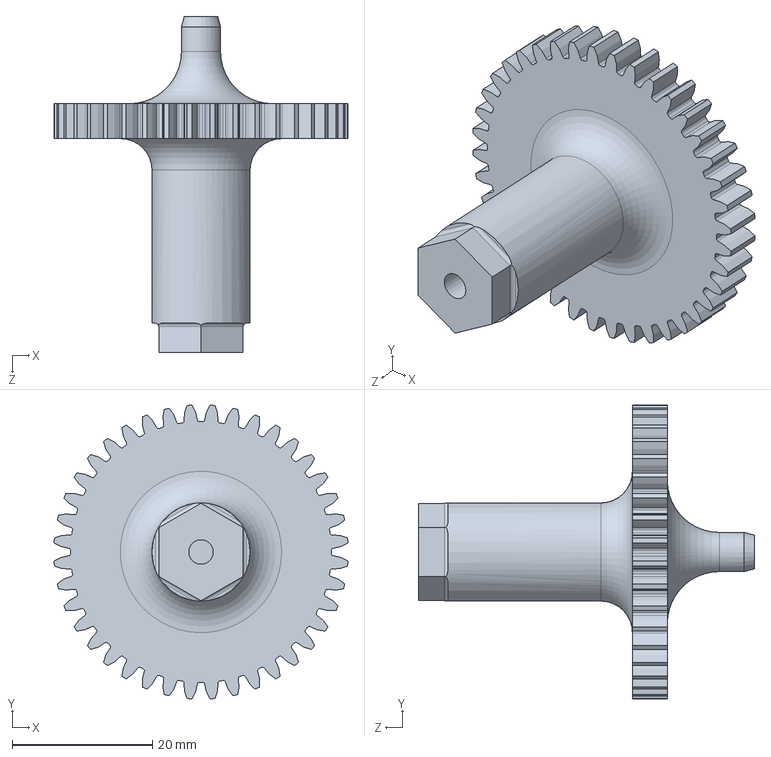
[picture p256: CAD file, 2023-12-04]
CAD FILES/GEAR_DRIVEN_LARGE.SLDPRT
41.9 x 41.9 x 47.9 mm
