masteravinashdubey/2022-SBR-Development/CAD FILES/WASTE/Battery Holder.SLDPRT

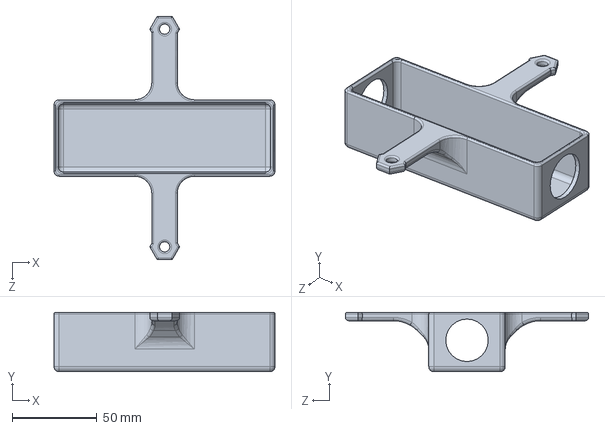
[picture p257: CAD file, 2023-12-04]
CAD FILES/WASTE/Battery Holder.SLDPRT
130.0 x 35.0 x 143.2 mm
