masteravinashdubey/2022-SBR-Development/sensors/ULTRASONIC SENSOR/hc-sr04 part1.SLDPRT

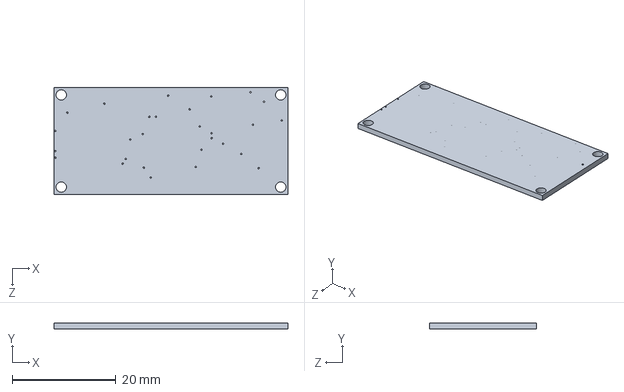
[picture p258: CAD file, 2023-12-04]
sensors/ULTRASONIC SENSOR/hc-sr04 part1.SLDPRT
45.2 x 1.10 x 20.6 mm
