masteravinashdubey/2022-SBR-Development/Spacers/Mass.SLDPRT

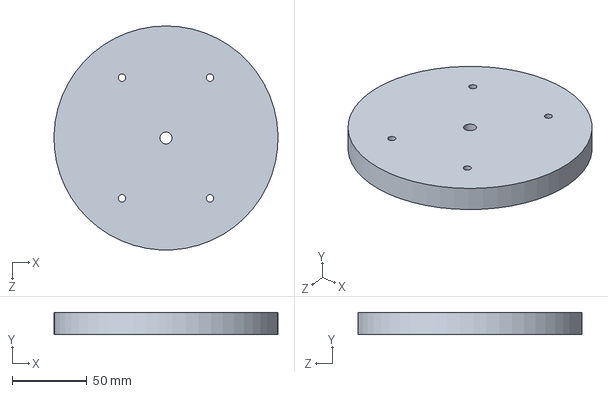
[picture p259: CAD file, 2023-12-04]
Spacers/Mass.SLDPRT
149.9 x 15.0 x 150.0 mm
