masteravinashdubey/2022-SBR-Development/CAD FILES/Castor Recess.SLDPRT

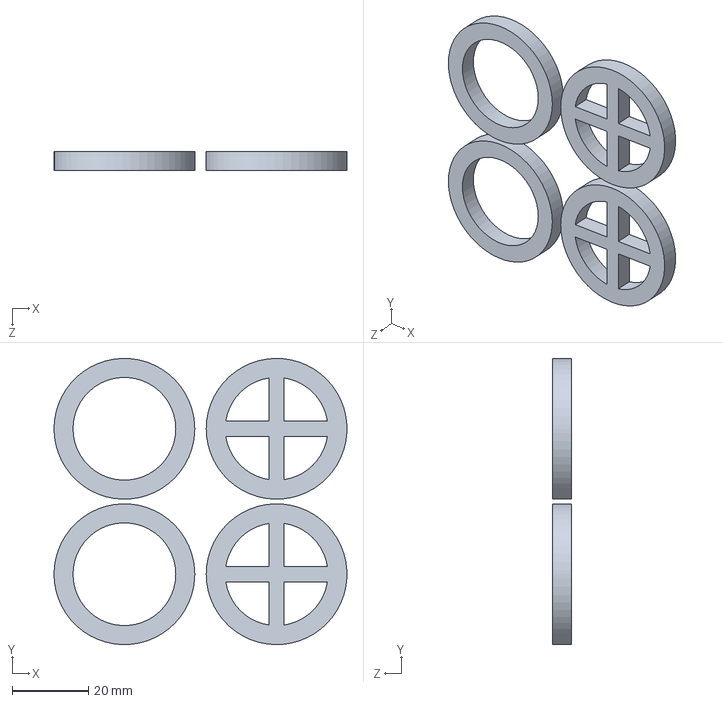
[picture p260: CAD file, 2023-12-04]
CAD FILES/Castor Recess.SLDPRT
77.0 x 75.2 x 5.00 mm
