masteravinashdubey/2022-SBR-Development/CAD FILES/WASTE/Wall.SLDPRT

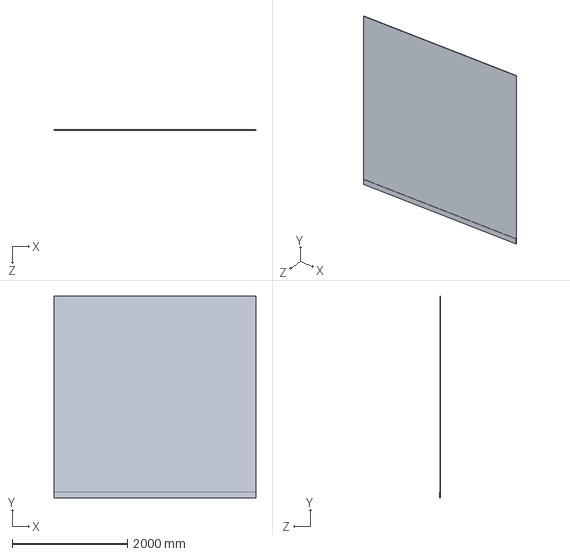
[picture p261: CAD file, 2023-12-04]
CAD FILES/WASTE/Wall.SLDPRT
3500.0 x 3500.0 x 15.0 mm
