masteravinashdubey/2022-SBR-Development/sensors/ULTRASONIC SENSOR/SMD resistor.SLDPRT

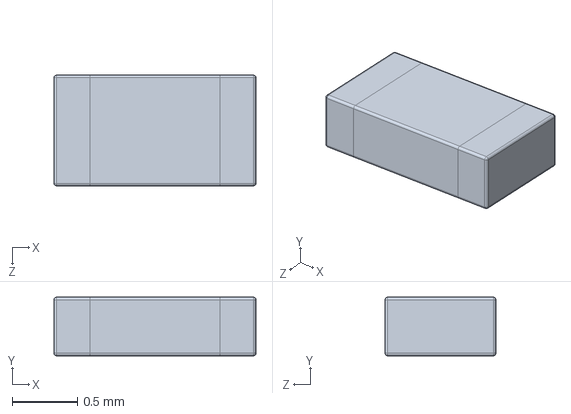
[picture p262: CAD file, 2023-12-04]
sensors/ULTRASONIC SENSOR/SMD resistor.SLDPRT
1.55 x 0.45 x 0.85 mm
