masteravinashdubey/2022-SBR-Development/Spacers/Floor_Plates2.SLDPRT

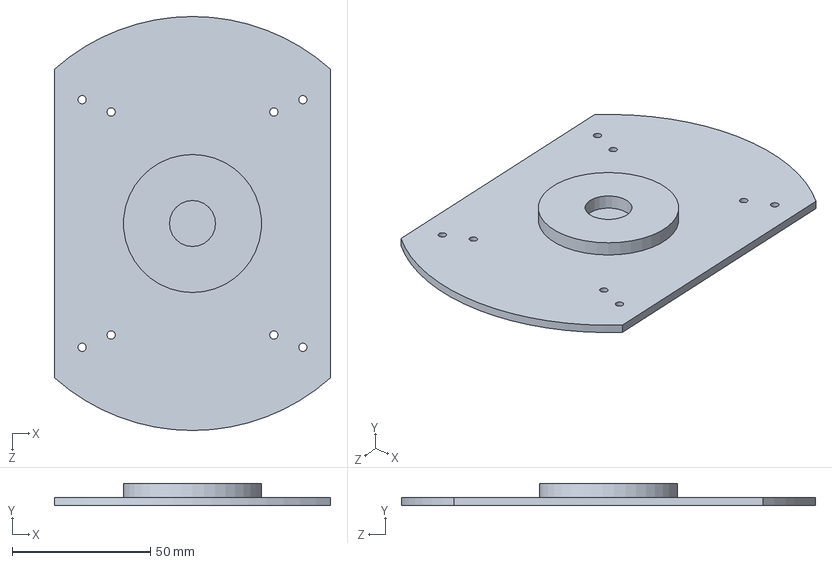
[picture p263: CAD file, 2023-12-04]
Spacers/Floor_Plates2.SLDPRT
100.0 x 8.00 x 150.0 mm
