masteravinashdubey/2022-SBR-Development/Base components/LINE SENSOR.SLDPRT

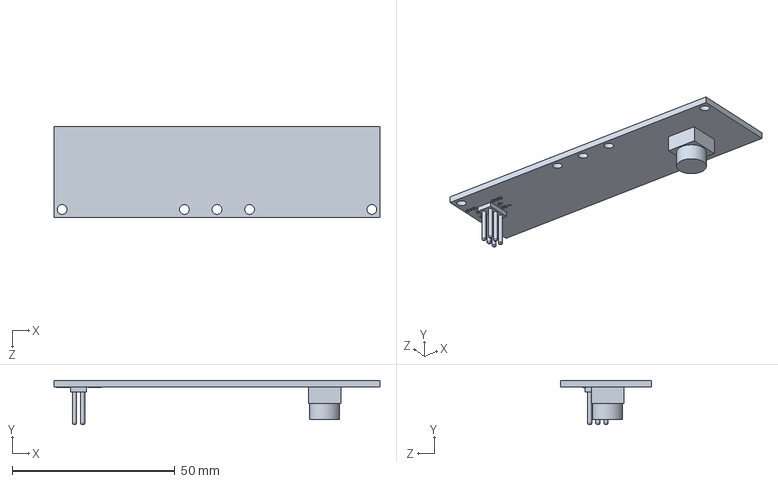
[picture p264: CAD file, 2023-12-04]
Base components/LINE SENSOR.SLDPRT
100.0 x 13.5 x 28.0 mm
