masteravinashdubey/2022-SBR-Development/CAD FILES/65mm tire.SLDPRT

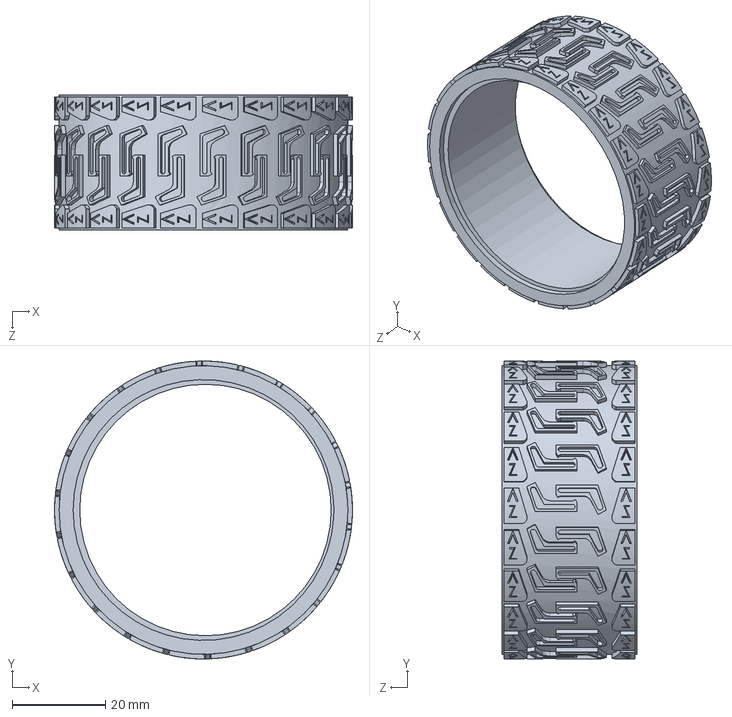
[picture p265: CAD file, 2023-12-04]
CAD FILES/65mm tire.SLDPRT
64.0 x 64.0 x 29.0 mm
