masteravinashdubey/2022-SBR-Development/Spacers/6cm_spacers.SLDPRT

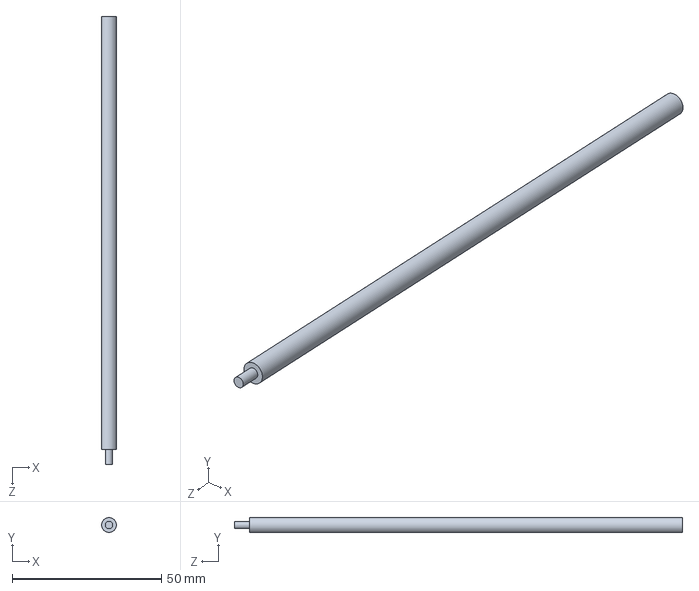
[picture p266: CAD file, 2023-12-04]
Spacers/6cm_spacers.SLDPRT
5.00 x 5.00 x 150.0 mm
