masteravinashdubey/2022-SBR-Development/CAD FILES/TRAY_2.SLDPRT

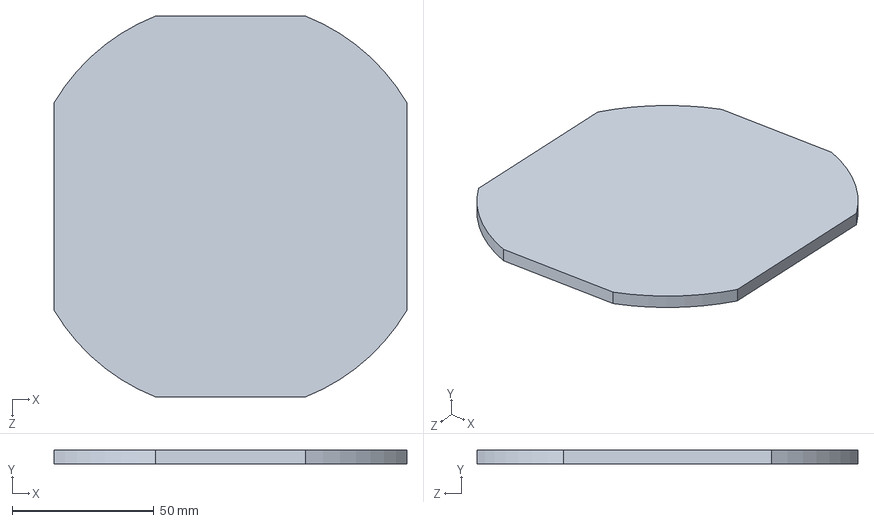
[picture p267: CAD file, 2023-12-04]
CAD FILES/TRAY_2.SLDPRT
124.5 x 5.00 x 134.5 mm
