masteravinashdubey/2022-SBR-Development/sensors/ULTRASONIC SENSOR/SMD resistor2.SLDPRT

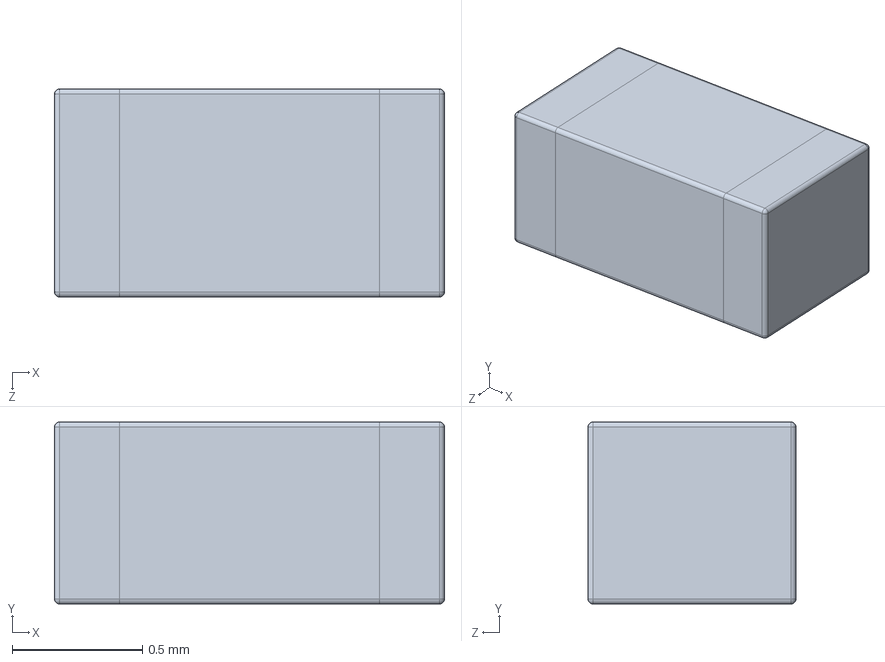
[picture p268: CAD file, 2023-12-04]
sensors/ULTRASONIC SENSOR/SMD resistor2.SLDPRT
1.50 x 0.7 x 0.8 mm
