masteravinashdubey/2022-SBR-Development/Spacers/Floor_Plates1.SLDPRT

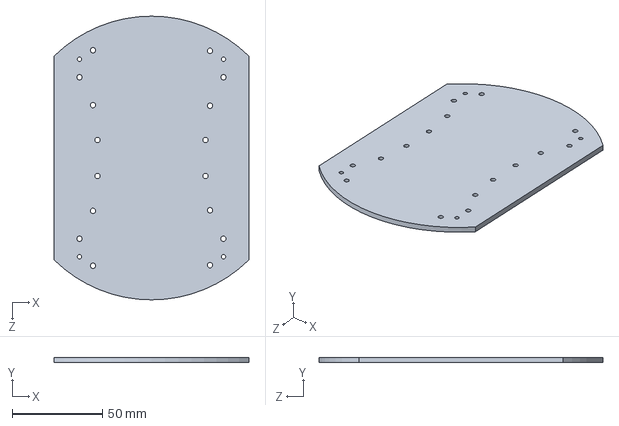
[picture p269: CAD file, 2023-12-04]
Spacers/Floor_Plates1.SLDPRT
108.3 x 3.00 x 157.6 mm
