masteravinashdubey/2022-SBR-Development/(list of files, cad)

Other CAD files:
CAD FILES/65MM FRAME.SLDPRT
STLS/Gear_Driver_V3.STL
Files for 3D printing/Stl files/30062022/G_Driven_F.STL
Parts/BOT design/65mm tire.SLDPRT
sensors/Part2.SLDPRT
Spacers/Floor_Plates4.SLDPRT
Covers/Cover_Back.SLDPRT
Base components/Gear Box Covering - Modifiable.SLDPRT
Base components/BASE PLATE COMPACT.SLDPRT
Base components/Motor Driver.SLDPRT
Assembly/Lead_Screw.SLDPRT
BATTERY.SLDPRT
CAD FILES/COVERS/COVER_1.SLDPRT
CAD FILES/WASTE/BASE PLATE.SLDPRT
CAD FILES/WASTE/BasePVC.SLDPRT
CAD FILES/WASTE/BaseRod_BulbLockModel.SLDPRT
CAD FILES/WASTE/Bolt_GearBox.SLDPRT
CAD FILES/WASTE/Bolt_GearBox_BasePlate.SLDPRT
CAD FILES/WASTE/Bolt_HeightExtender.SLDPRT
CAD FILES/WASTE/Bolt_RodHolder.SLDPRT
CAD FILES/WASTE/CIRCULAR_BASE.SLDPRT
CAD FILES/WASTE/Cyl Lock.SLDPRT
CAD FILES/WASTE/D-Type.SLDPRT
CAD FILES/WASTE/D_Rod.SLDPRT
CAD FILES/WASTE/LOGO BOARD.SLDPRT
CAD FILES/WASTE/Nut_GearBox.SLDPRT
CAD FILES/WASTE/Nut_HeightExtenders.SLDPRT
CAD FILES/WASTE/ROD HOLDER.SLDPRT
CAD FILES/WASTE/Rod_Middle.SLDPRT
CAD FILES/WASTE/Rod_Top.SLDPRT
CAD FILES/WASTE/Rod_base.SLDPRT
CAD FILES/eYFi_Mega.SLDPRT
Covers/Cover_Bottom.STL
Covers/Cover_Bottom2.STL
Covers/Cover_mid.STL
Files for 3D printing/Stl files/23062022_Sample Driver.STL
Files for 3D printing/Stl files/24_06_2022/24062022_Gear_Driven.STL
Files for 3D printing/Stl files/24_06_2022/24062022_Gear_Driver.STL
Files for 3D printing/Stl files/24_06_2022/24062022_HexNut.STL
Files for 3D printing/gcode files/22062022_connector1.stl
Parts/BOT design/Pil2.SLDPRT
STLS/Gear_Driven - LARGE.SLDPRT
STLS/Gear_Driven_LARGE_V3.STL
Spacers/1cm_spacers.SLDPRT
Spacers/4cm_spacers.SLDPRT
Spacers/Dead_weight.DWG
Spacers/Floor_Plates1 - Copy.SLDPRT
Spacers/Floor_Plates4_2.SLDPRT
Spacers/Velcro.SLDPRT
Spacers/gear_shaft.SLDPRT
sensors/ULTRASONIC SENSOR/hc-sr04 part12.SLDPRT
sensors/ULTRASONIC SENSOR/hc-sr04 part2.SLDPRT
sensors/ULTRASONIC SENSOR/hc-sr04 part3.SLDPRT
sensors/ULTRASONIC SENSOR/hc-sr04 part9.SLDPRT
