masteravinashdubey/2022-SBR-Development/PCB_V5/Main_board.brd

## EAGLE design PCB_V5/Main_board.brd (2023-12-04, an earlier design)

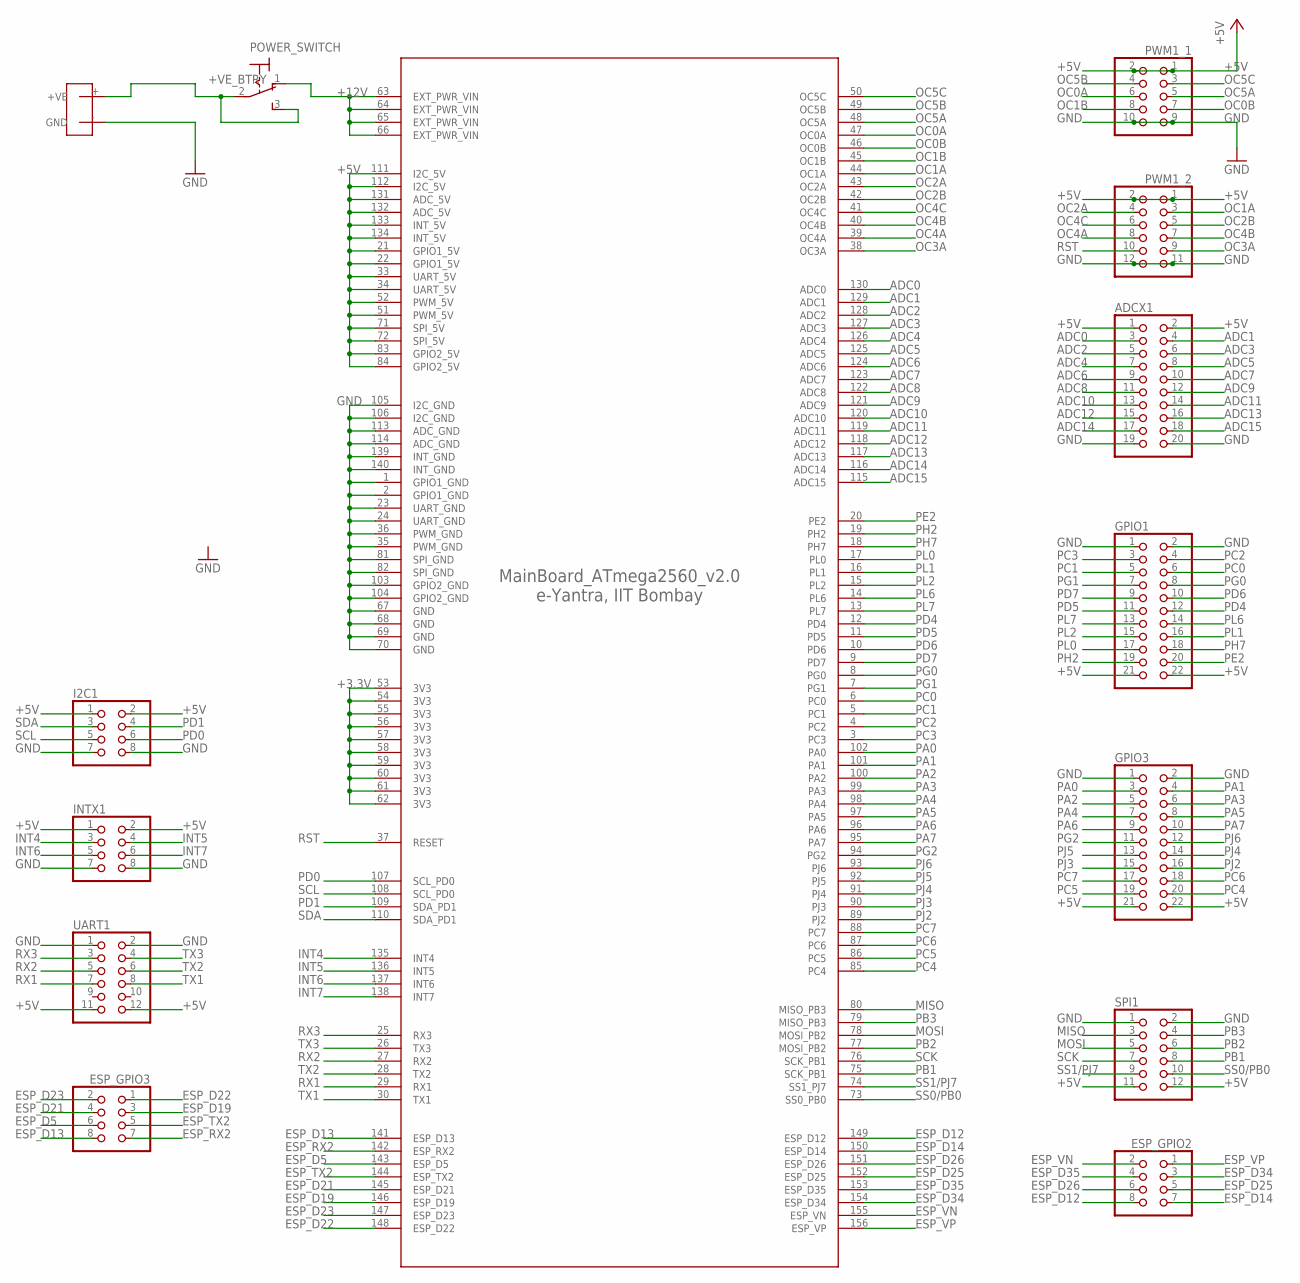
[picture p270: schematic Main_board.sch, sheet 1]

Parts:
ADCX1: PINHD-2X10; 2X10
ESP_GPIO2, ESP_GPIO3: PINHD-2X4; 2X04
EYFI_MEGA: ATMEGA2560_V2.0
GPIO1, GPIO3: PINHD-2X11; 2X11
I2C1: PINHD-2X4; 2X04
INTX1: PINHD-2X4; 2X04
POWER_SWITCH: M9040P
PWM1_1: PINHD-2X5; 2X05
PWM1_2: PINHD-2X6; 2X06
SPI1: PINHD-2X6; 2X06
U$1: DEANS
UART1: PINHD-2X6; 2X06

Connections:
+3.3V: EYFI_MEGA.53 (3V3), EYFI_MEGA.54 (3V3), EYFI_MEGA.55 (3V3), EYFI_MEGA.56 (3V3), EYFI_MEGA.57 (3V3), EYFI_MEGA.58 (3V3), EYFI_MEGA.59 (3V3), EYFI_MEGA.60 (3V3), EYFI_MEGA.61 (3V3), EYFI_MEGA.62 (3V3); also elsewhere on the board
+5V: ADCX1.1, ADCX1.2, EYFI_MEGA.21 (GPIO1_5V), EYFI_MEGA.22 (GPIO1_5V), EYFI_MEGA.33 (UART_5V), EYFI_MEGA.34 (UART_5V), EYFI_MEGA.51 (PWM_5V), EYFI_MEGA.52 (PWM_5V), EYFI_MEGA.71 (SPI_5V), EYFI_MEGA.72 (SPI_5V), EYFI_MEGA.83 (GPIO2_5V), EYFI_MEGA.84 (GPIO2_5V), EYFI_MEGA.111 (I2C_5V), EYFI_MEGA.112 (I2C_5V), EYFI_MEGA.131 (ADC_5V), EYFI_MEGA.132 (ADC_5V), EYFI_MEGA.133 (INT_5V), EYFI_MEGA.134 (INT_5V), GPIO1.21, GPIO1.22, GPIO3.21, GPIO3.22, I2C1.1, I2C1.2, INTX1.1, INTX1.2, PWM1_1.1, PWM1_1.2, PWM1_2.1, PWM1_2.2, SPI1.11, SPI1.12, UART1.11, UART1.12; also elsewhere on the board
+12V: EYFI_MEGA.63 (EXT_PWR_VIN), EYFI_MEGA.64 (EXT_PWR_VIN), EYFI_MEGA.65 (EXT_PWR_VIN), EYFI_MEGA.66 (EXT_PWR_VIN), POWER_SWITCH.1 (O); also elsewhere on the board
+VE_BTRY: POWER_SWITCH.2, POWER_SWITCH.3 (S), U$1.+ (+VE)
ADC0: ADCX1.3, EYFI_MEGA.130 (ADC0); also elsewhere on the board
ADC1: ADCX1.4, EYFI_MEGA.129 (ADC1); also elsewhere on the board
ADC2: ADCX1.5, EYFI_MEGA.128 (ADC2); also elsewhere on the board
ADC3: ADCX1.6, EYFI_MEGA.127 (ADC3); also elsewhere on the board
ADC4: ADCX1.7, EYFI_MEGA.126 (ADC4)
ADC5: ADCX1.8, EYFI_MEGA.125 (ADC5)
ADC6: ADCX1.9, EYFI_MEGA.124 (ADC6)
ADC7: ADCX1.10, EYFI_MEGA.123 (ADC7)
ADC8: ADCX1.11, EYFI_MEGA.122 (ADC8)
ADC9: ADCX1.12, EYFI_MEGA.121 (ADC9)
ADC10: ADCX1.13, EYFI_MEGA.120 (ADC10)
ADC11: ADCX1.14, EYFI_MEGA.119 (ADC11)
ADC12: ADCX1.15, EYFI_MEGA.118 (ADC12); also elsewhere on the board
ADC13: ADCX1.16, EYFI_MEGA.117 (ADC13); also elsewhere on the board
ADC14: ADCX1.17, EYFI_MEGA.116 (ADC14); also elsewhere on the board
ADC15: ADCX1.18, EYFI_MEGA.115 (ADC15); also elsewhere on the board
ESP_D5: ESP_GPIO3.6, EYFI_MEGA.143 (ESP_D5)
ESP_D12: ESP_GPIO2.8, EYFI_MEGA.149 (ESP_D12)
ESP_D13: ESP_GPIO3.8, EYFI_MEGA.141 (ESP_D13)
ESP_D14: ESP_GPIO2.7, EYFI_MEGA.150 (ESP_D14)
ESP_D19: ESP_GPIO3.3, EYFI_MEGA.146 (ESP_D19)
ESP_D21: ESP_GPIO3.4, EYFI_MEGA.145 (ESP_D21)
ESP_D22: ESP_GPIO3.1, EYFI_MEGA.148 (ESP_D22)
ESP_D23: ESP_GPIO3.2, EYFI_MEGA.147 (ESP_D23)
ESP_D25: ESP_GPIO2.5, EYFI_MEGA.152 (ESP_D25)
ESP_D26: ESP_GPIO2.6, EYFI_MEGA.151 (ESP_D26)
ESP_D34: ESP_GPIO2.3, EYFI_MEGA.154 (ESP_D34)
ESP_D35: ESP_GPIO2.4, EYFI_MEGA.153 (ESP_D35)
ESP_RX2: ESP_GPIO3.7, EYFI_MEGA.142 (ESP_RX2)
ESP_TX2: ESP_GPIO3.5, EYFI_MEGA.144 (ESP_TX2)
ESP_VN: ESP_GPIO2.2, EYFI_MEGA.155 (ESP_VN)
ESP_VP: ESP_GPIO2.1, EYFI_MEGA.156 (ESP_VP)
GND: ADCX1.19, ADCX1.20, EYFI_MEGA.1 (GPIO1_GND), EYFI_MEGA.2 (GPIO1_GND), EYFI_MEGA.23 (UART_GND), EYFI_MEGA.24 (UART_GND), EYFI_MEGA.35 (PWM_GND), EYFI_MEGA.36 (PWM_GND), EYFI_MEGA.67 (GND), EYFI_MEGA.68 (GND), EYFI_MEGA.69 (GND), EYFI_MEGA.70 (GND), EYFI_MEGA.81 (SPI_GND), EYFI_MEGA.82 (SPI_GND), EYFI_MEGA.103 (GPIO2_GND), EYFI_MEGA.104 (GPIO2_GND), EYFI_MEGA.105 (I2C_GND), EYFI_MEGA.106 (I2C_GND), EYFI_MEGA.113 (ADC_GND), EYFI_MEGA.114 (ADC_GND), EYFI_MEGA.139 (INT_GND), EYFI_MEGA.140 (INT_GND), GPIO1.1, GPIO1.2, GPIO3.1, GPIO3.2, I2C1.7, I2C1.8, INTX1.7, INTX1.8, PWM1_1.9, PWM1_1.10, PWM1_2.11, PWM1_2.12, SPI1.1, SPI1.2, U$1.- (GND), UART1.1, UART1.2; also elsewhere on the board
INT4: EYFI_MEGA.135 (INT4), INTX1.3; also elsewhere on the board
INT5: EYFI_MEGA.136 (INT5), INTX1.4; also elsewhere on the board
INT6: EYFI_MEGA.137 (INT6), INTX1.5; also elsewhere on the board
INT7: EYFI_MEGA.138 (INT7), INTX1.6; also elsewhere on the board
MISO: EYFI_MEGA.80 (MISO_PB3), SPI1.3
MOSI: EYFI_MEGA.78 (MOSI_PB2), SPI1.5
OC0A: EYFI_MEGA.47 (OC0A), PWM1_1.6
OC0B: EYFI_MEGA.46 (OC0B), PWM1_1.7
OC1A: EYFI_MEGA.44 (OC1A), PWM1_2.3
OC1B: EYFI_MEGA.45 (OC1B), PWM1_1.8; also elsewhere on the board
OC2A: EYFI_MEGA.43 (OC2A), PWM1_2.4
OC2B: EYFI_MEGA.42 (OC2B), PWM1_2.5; also elsewhere on the board
OC3A: EYFI_MEGA.38 (OC3A), PWM1_2.9; also elsewhere on the board
OC4A: EYFI_MEGA.39 (OC4A), PWM1_2.8; also elsewhere on the board
OC4B: EYFI_MEGA.40 (OC4B), PWM1_2.7; also elsewhere on the board
OC4C: EYFI_MEGA.41 (OC4C), PWM1_2.6; also elsewhere on the board
OC5A: EYFI_MEGA.48 (OC5A), PWM1_1.5; also elsewhere on the board
OC5B: EYFI_MEGA.49 (OC5B), PWM1_1.4; also elsewhere on the board
OC5C: EYFI_MEGA.50 (OC5C), PWM1_1.3
PA0: EYFI_MEGA.102 (PA0), GPIO3.3; also elsewhere on the board
PA1: EYFI_MEGA.101 (PA1), GPIO3.4; also elsewhere on the board
PA2: EYFI_MEGA.100 (PA2), GPIO3.5; also elsewhere on the board
PA3: EYFI_MEGA.99 (PA3), GPIO3.6; also elsewhere on the board
PA4: EYFI_MEGA.98 (PA4), GPIO3.7; also elsewhere on the board
PA5: EYFI_MEGA.97 (PA5), GPIO3.8; also elsewhere on the board
PA6: EYFI_MEGA.96 (PA6), GPIO3.9; also elsewhere on the board
PA7: EYFI_MEGA.95 (PA7), GPIO3.10; also elsewhere on the board
PB1: EYFI_MEGA.75 (SCK_PB1), SPI1.8
PB2: EYFI_MEGA.77 (MOSI_PB2), SPI1.6
PB3: EYFI_MEGA.79 (MISO_PB3), SPI1.4
PC0: EYFI_MEGA.6 (PC0), GPIO1.6; also elsewhere on the board
PC1: EYFI_MEGA.5 (PC1), GPIO1.5; also elsewhere on the board
PC2: EYFI_MEGA.4 (PC2), GPIO1.4; also elsewhere on the board
PC3: EYFI_MEGA.3 (PC3), GPIO1.3; also elsewhere on the board
PC4: EYFI_MEGA.85 (PC4), GPIO3.20; also elsewhere on the board
PC5: EYFI_MEGA.86 (PC5), GPIO3.19; also elsewhere on the board
PC6: EYFI_MEGA.87 (PC6), GPIO3.18; also elsewhere on the board
PC7: EYFI_MEGA.88 (PC7), GPIO3.17; also elsewhere on the board
PD0: EYFI_MEGA.107 (SCL_PD0), I2C1.6
PD1: EYFI_MEGA.109 (SDA_PD1), I2C1.4
PD4: EYFI_MEGA.12 (PD4), GPIO1.12; also elsewhere on the board
PD5: EYFI_MEGA.11 (PD5), GPIO1.11; also elsewhere on the board
PD6: EYFI_MEGA.10 (PD6), GPIO1.10; also elsewhere on the board
PD7: EYFI_MEGA.9 (PD7), GPIO1.9; also elsewhere on the board
PE2: EYFI_MEGA.20 (PE2), GPIO1.20
PG0: EYFI_MEGA.8 (PG0), GPIO1.8
PG1: EYFI_MEGA.7 (PG1), GPIO1.7
PG2: EYFI_MEGA.94 (PG2), GPIO3.11; also elsewhere on the board
PH2: EYFI_MEGA.19 (PH2), GPIO1.19
PH7: EYFI_MEGA.18 (PH7), GPIO1.18
PJ2: EYFI_MEGA.89 (PJ2), GPIO3.16
PJ3: EYFI_MEGA.90 (PJ3), GPIO3.15
PJ4: EYFI_MEGA.91 (PJ4), GPIO3.14
PJ5: EYFI_MEGA.92 (PJ5), GPIO3.13
PJ6: EYFI_MEGA.93 (PJ6), GPIO3.12; also elsewhere on the board
PL0: EYFI_MEGA.17 (PL0), GPIO1.17
PL1: EYFI_MEGA.16 (PL1), GPIO1.16
PL2: EYFI_MEGA.15 (PL2), GPIO1.15
PL6: EYFI_MEGA.14 (PL6), GPIO1.14
PL7: EYFI_MEGA.13 (PL7), GPIO1.13
RST: EYFI_MEGA.37 (RESET), PWM1_2.10
RX1: EYFI_MEGA.29 (RX1), UART1.7; also elsewhere on the board
RX2: EYFI_MEGA.27 (RX2), UART1.5
RX3: EYFI_MEGA.25 (RX3), UART1.3
SCK: EYFI_MEGA.76 (SCK_PB1), SPI1.7
SCL: EYFI_MEGA.108 (SCL_PD0), I2C1.5; also elsewhere on the board
SDA: EYFI_MEGA.110 (SDA_PD1), I2C1.3; also elsewhere on the board
SS0/PB0: EYFI_MEGA.73 (SS0_PB0), SPI1.10
SS1/PJ7: EYFI_MEGA.74 (SS1_PJ7), SPI1.9
TX1: EYFI_MEGA.30 (TX1), UART1.8
TX2: EYFI_MEGA.28 (TX2), UART1.6
TX3: EYFI_MEGA.26 (TX3), UART1.4

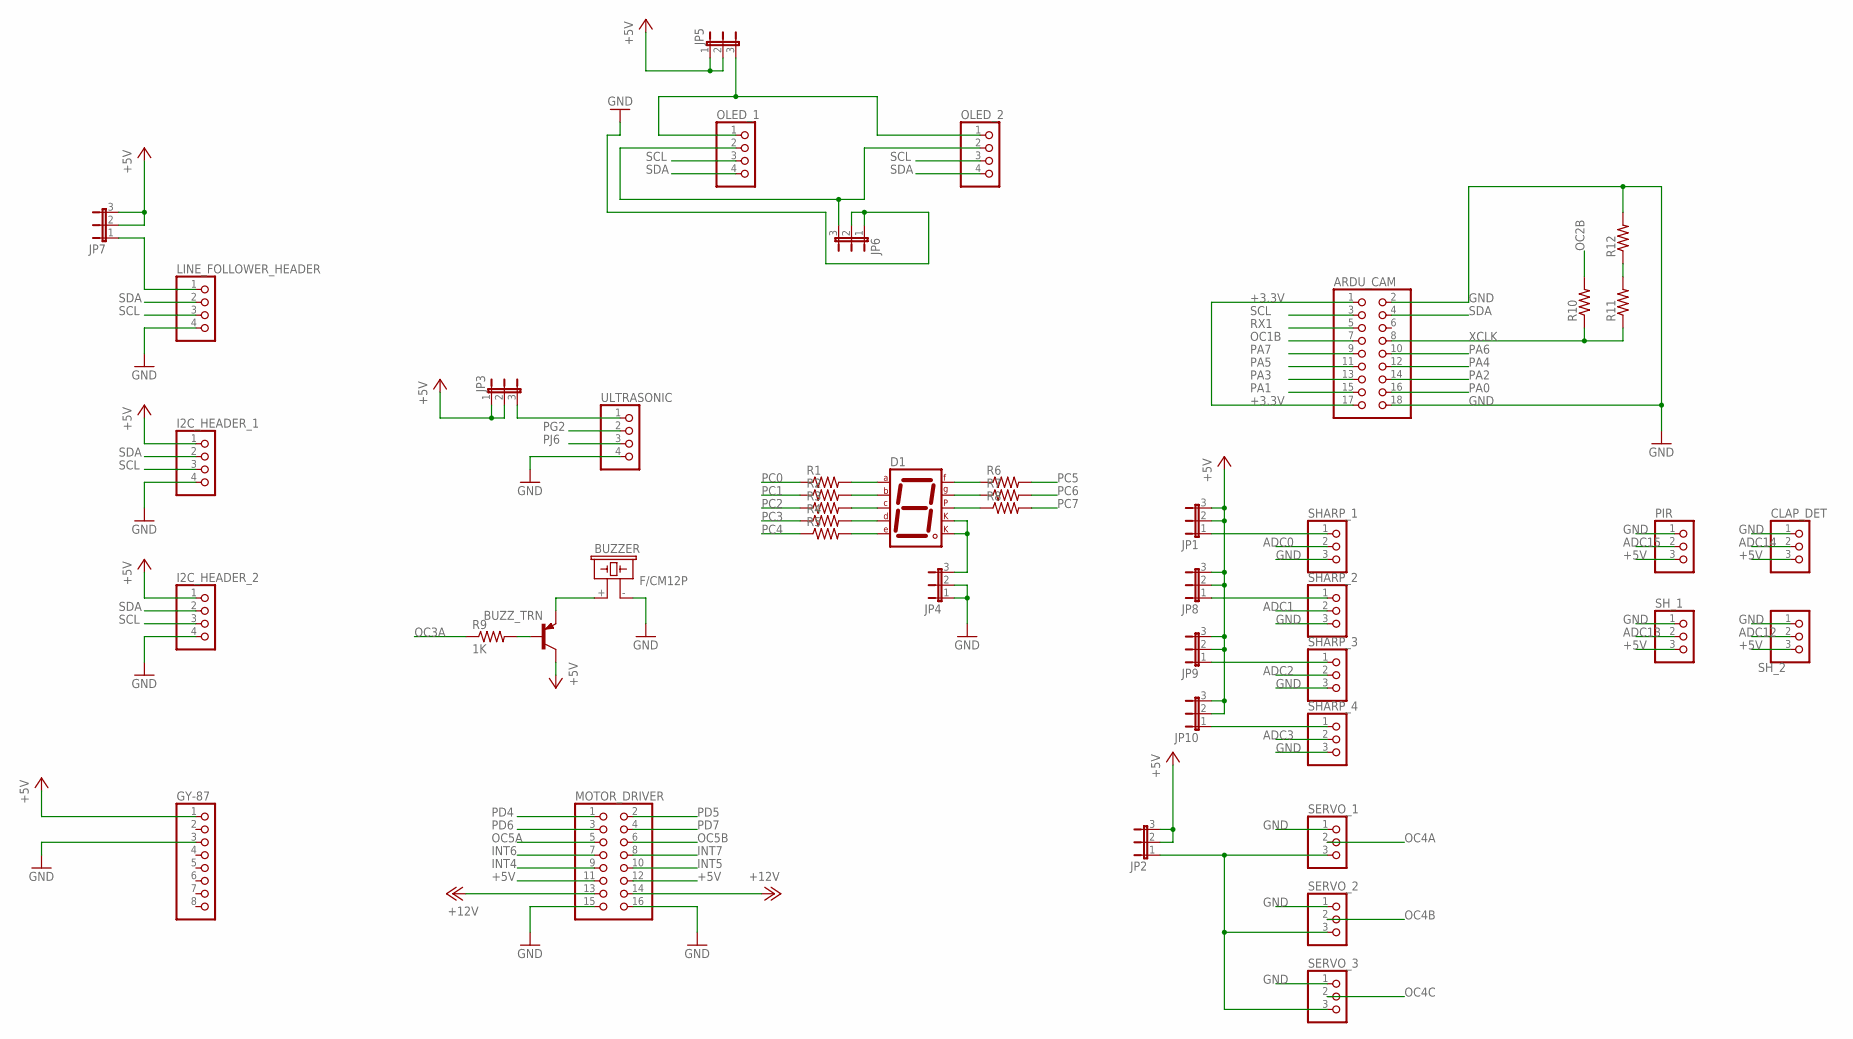
[picture p271: schematic Main_board.sch, sheet 2]

Parts:
ARDU_CAM: PINHD-2X9; 2X09
BUZZER: F/CM12P
BUZZ_TRN: BC807-16-PNP-SOT23-BEC; SOT23-BEC
CLAP_DET: PINHD-1X3; 1X03
D1: 7SEG-CK; 7SEG-13
GY-87: PINHD-1X8; 1X08
I2C_HEADER_1, I2C_HEADER_2: PINHD-1X4; 1X04
JP1, JP2, JP3, JP4, JP5, JP6, JP7, JP8, JP9, JP10: JP2E; JP2
LINE_FOLLOWER_HEADER: PINHD-1X4; 1X04
MOTOR_DRIVER: PINHD-2X8; 2X08
OLED_1, OLED_2: PINHD-1X4; 1X04
PIR: PINHD-1X3; 1X03
R1, R2, R3, R4, R5, R6, R7, R8, R10, R11, R12: R-US_R1206; R1206
R9: 1K; R1206
SERVO_1, SERVO_2, SERVO_3: PINHD-1X3; 1X03
SHARP_1, SHARP_2, SHARP_3, SHARP_4: PINHD-1X3; 1X03
SH_1, SH_2: PINHD-1X3; 1X03
ULTRASONIC: PINHD-1X4; 1X04

Connections:
+3.3V: ARDU_CAM.1, ARDU_CAM.17; also elsewhere on the board
+5V: BUZZ_TRN.C, CLAP_DET.3, GY-87.1, I2C_HEADER_1.1, I2C_HEADER_2.1, JP1.2, JP1.3, JP2.2, JP2.3, JP3.1, JP3.2, JP5.1, JP5.2, JP7.2, JP7.3, JP8.2, JP8.3, JP9.2, JP9.3, JP10.2, JP10.3, MOTOR_DRIVER.11, MOTOR_DRIVER.12, PIR.3, SH_1.3, SH_2.3; also elsewhere on the board
+12V: MOTOR_DRIVER.13, MOTOR_DRIVER.14; also elsewhere on the board
ADC0: SHARP_1.2; also elsewhere on the board
ADC1: SHARP_2.2; also elsewhere on the board
ADC2: SHARP_3.2; also elsewhere on the board
ADC3: SHARP_4.2; also elsewhere on the board
ADC12: SH_2.2; also elsewhere on the board
ADC13: SH_1.2; also elsewhere on the board
ADC14: CLAP_DET.2; also elsewhere on the board
ADC15: PIR.2; also elsewhere on the board
GND: ARDU_CAM.2, ARDU_CAM.18, BUZZER.- (2), CLAP_DET.1, GY-87.3, I2C_HEADER_1.4, I2C_HEADER_2.4, JP4.1, JP4.2, JP6.1, JP6.2, LINE_FOLLOWER_HEADER.4, MOTOR_DRIVER.15, MOTOR_DRIVER.16, PIR.1, R12.2, SERVO_1.1, SERVO_2.1, SERVO_3.1, SHARP_1.3, SHARP_2.3, SHARP_3.3, SHARP_4.3, SH_1.1, SH_2.1, ULTRASONIC.4; also elsewhere on the board
INT4: MOTOR_DRIVER.9; also elsewhere on the board
INT5: MOTOR_DRIVER.10; also elsewhere on the board
INT6: MOTOR_DRIVER.7; also elsewhere on the board
INT7: MOTOR_DRIVER.8; also elsewhere on the board
unnamed: JP1.1, SHARP_1.1
unnamed: D1.7 (A), R1.2
unnamed: BUZZER.+ (1), BUZZ_TRN.E
unnamed: D1.6 (B), R2.2
unnamed: BUZZ_TRN.B, R9.2
unnamed: D1.4 (C), R3.2
unnamed: D1.2 (D), R4.2
unnamed: D1.1 (E), R5.2
unnamed: D1.9 (F), R6.1
unnamed: D1.10 (G), R7.1
unnamed: D1.5 (DP), R8.1
unnamed: JP3.3, ULTRASONIC.1
unnamed: D1.3 (CK1), D1.8 (CK2), JP4.3
unnamed: JP5.3, OLED_1.1, OLED_2.1
unnamed: JP6.3, OLED_1.2, OLED_2.2
unnamed: JP7.1, LINE_FOLLOWER_HEADER.1
unnamed: R11.2, R12.1
unnamed: JP8.1, SHARP_2.1
unnamed: JP10.1, SHARP_4.1
unnamed: JP9.1, SHARP_3.1
unnamed: JP2.1, SERVO_1.3, SERVO_2.3, SERVO_3.3
OC1B: ARDU_CAM.7; also elsewhere on the board
OC2B: R10.2; also elsewhere on the board
OC3A: R9.1; also elsewhere on the board
OC4A: SERVO_1.2; also elsewhere on the board
OC4B: SERVO_2.2; also elsewhere on the board
OC4C: SERVO_3.2; also elsewhere on the board
OC5A: MOTOR_DRIVER.5; also elsewhere on the board
OC5B: MOTOR_DRIVER.6; also elsewhere on the board
PA0: ARDU_CAM.16; also elsewhere on the board
PA1: ARDU_CAM.15; also elsewhere on the board
PA2: ARDU_CAM.14; also elsewhere on the board
PA3: ARDU_CAM.13; also elsewhere on the board
PA4: ARDU_CAM.12; also elsewhere on the board
PA5: ARDU_CAM.11; also elsewhere on the board
PA6: ARDU_CAM.10; also elsewhere on the board
PA7: ARDU_CAM.9; also elsewhere on the board
PC0: R1.1; also elsewhere on the board
PC1: R2.1; also elsewhere on the board
PC2: R3.1; also elsewhere on the board
PC3: R4.1; also elsewhere on the board
PC4: R5.1; also elsewhere on the board
PC5: R6.2; also elsewhere on the board
PC6: R7.2; also elsewhere on the board
PC7: R8.2; also elsewhere on the board
PD4: MOTOR_DRIVER.1; also elsewhere on the board
PD5: MOTOR_DRIVER.2; also elsewhere on the board
PD6: MOTOR_DRIVER.3; also elsewhere on the board
PD7: MOTOR_DRIVER.4; also elsewhere on the board
PG2: ULTRASONIC.2; also elsewhere on the board
PJ6: ULTRASONIC.3; also elsewhere on the board
RX1: ARDU_CAM.5; also elsewhere on the board
SCL: ARDU_CAM.3, I2C_HEADER_1.3, I2C_HEADER_2.3, LINE_FOLLOWER_HEADER.3, OLED_1.3, OLED_2.3; also elsewhere on the board
SDA: ARDU_CAM.4, I2C_HEADER_1.2, I2C_HEADER_2.2, LINE_FOLLOWER_HEADER.2, OLED_1.4, OLED_2.4; also elsewhere on the board
XCLK: ARDU_CAM.8, R10.1, R11.1

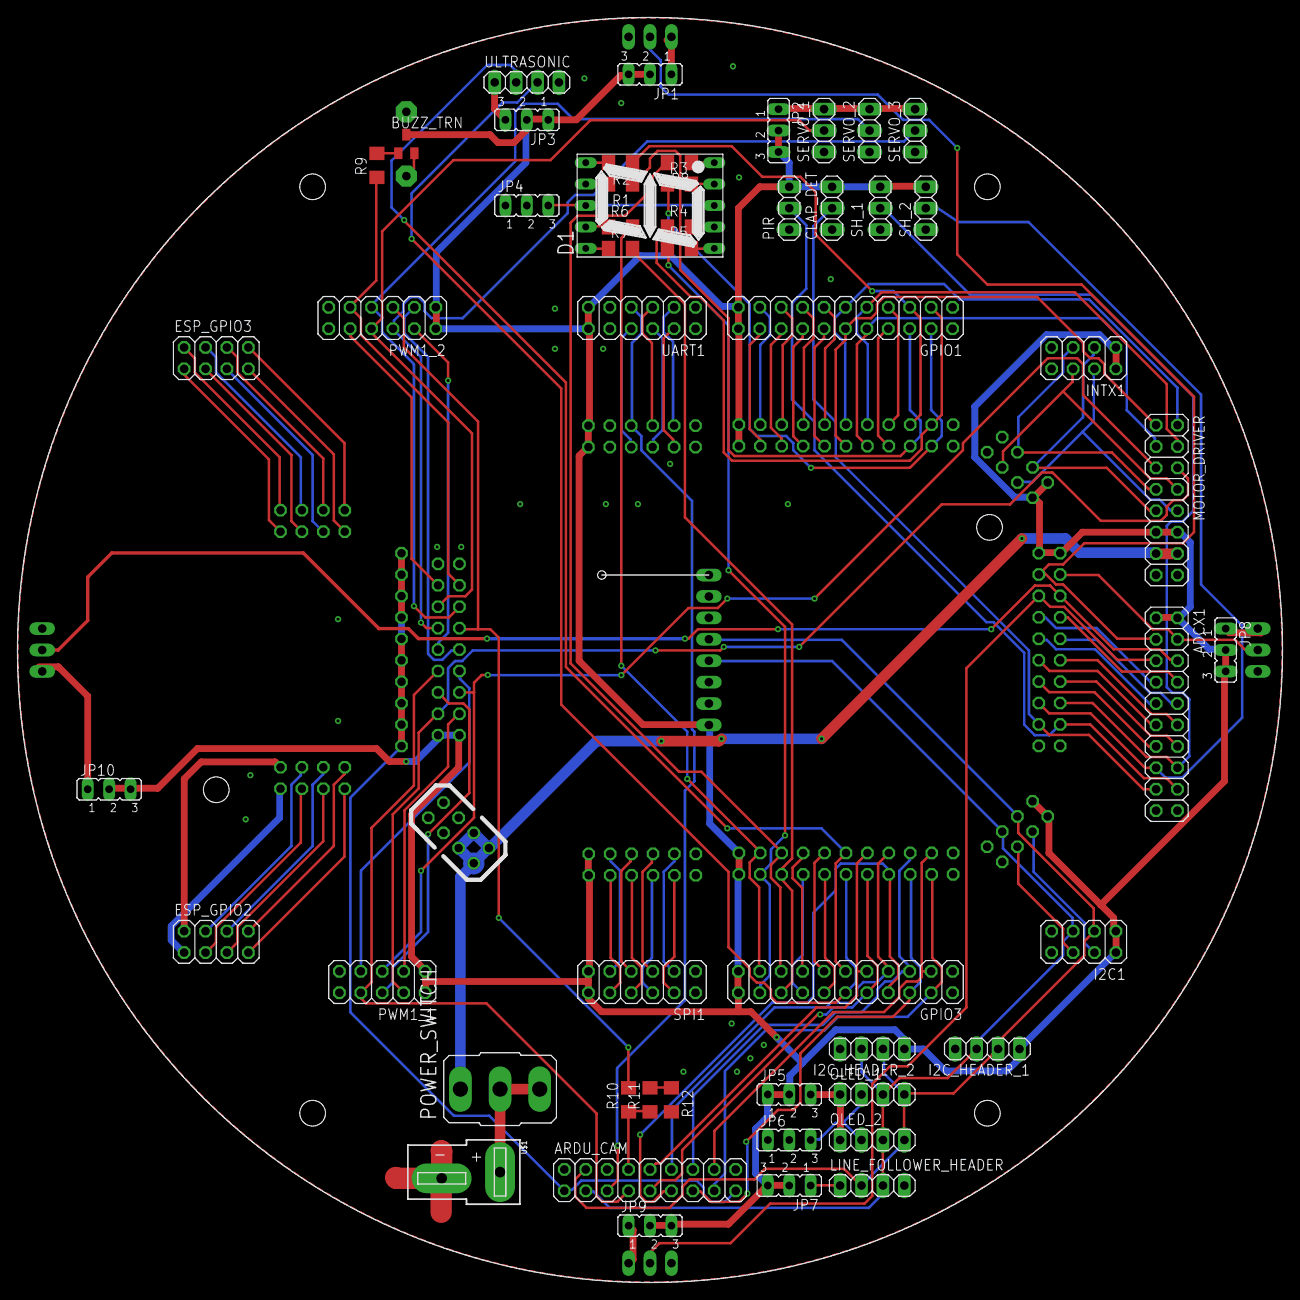
[picture p272: board Main_board.brd from above]

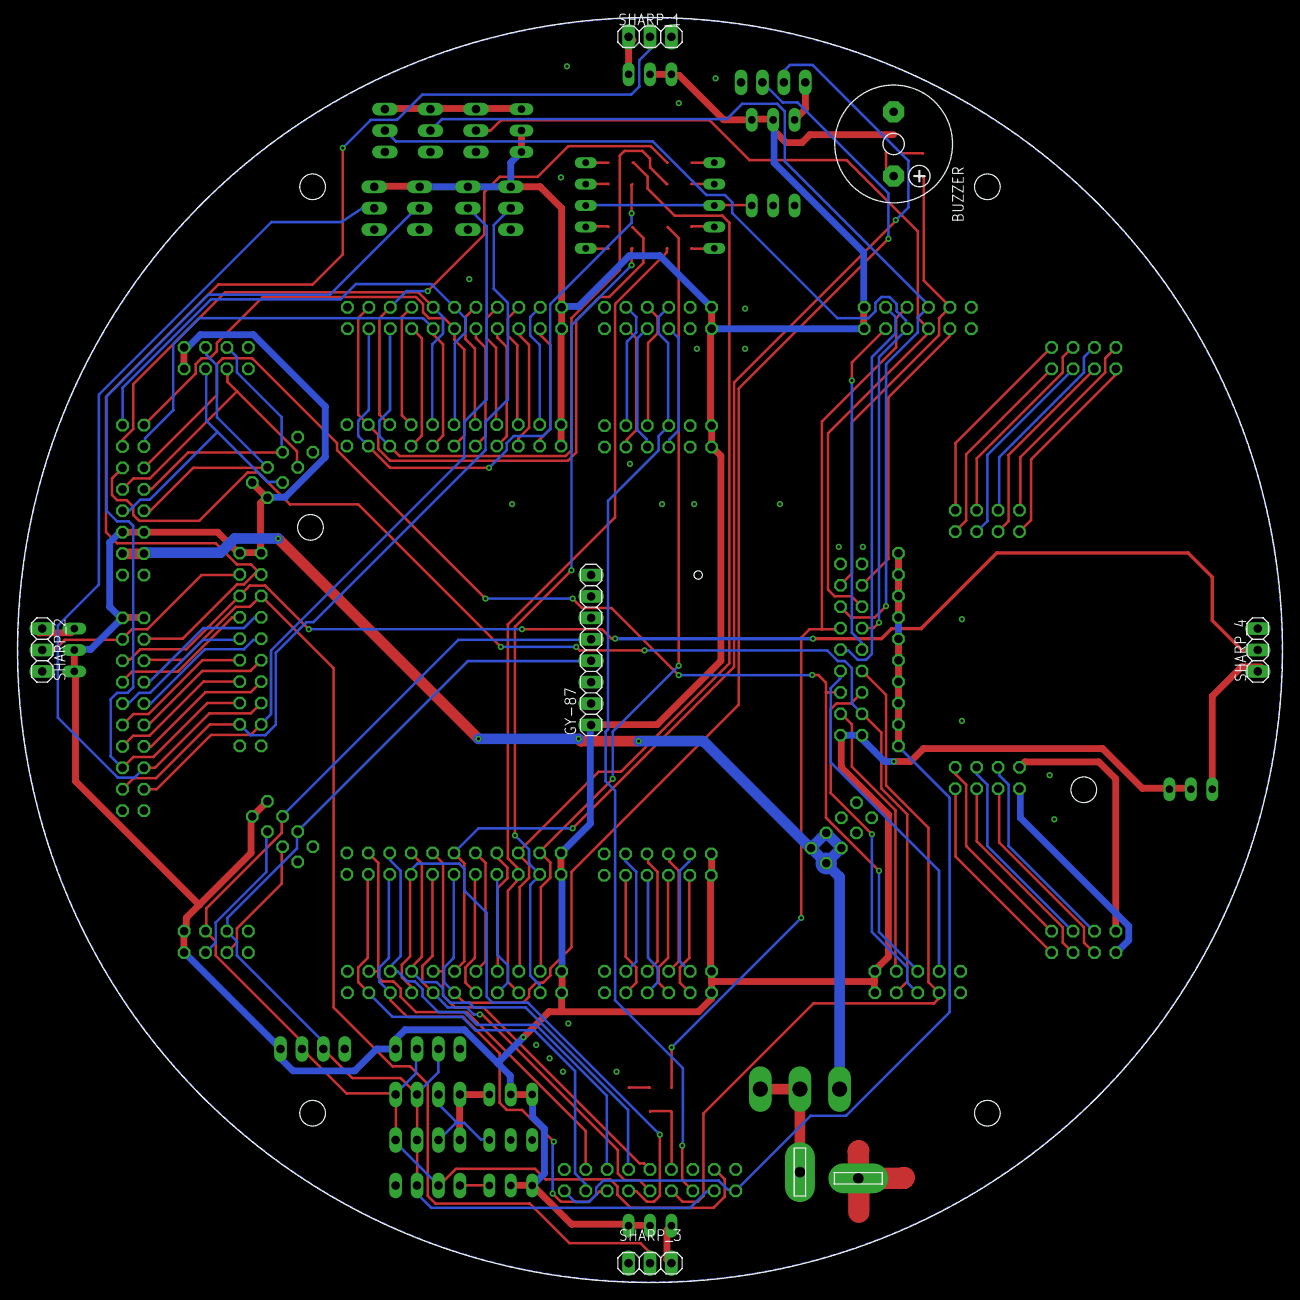
[picture p273: board Main_board.brd from below]

Board: 2 copper layers, 150.0 x 150.0 mm, 59 parts (6 on the bottom side), 131 nets.
