masteravinashdubey/2022-SBR-Development/I2C_multi/eyes.h

/*
 
 
 void setup() {
  
 
//  if(!display.begin(SSD1306_SWITCHCAPVCC, 0x3C)) {
//    Serial.println(F("SSD1306 allocation failed"));
//    for(;;);
//  }
  delay(2000); // Pause for 2 seconds

// Clear the buffer.
  display.clearDisplay();

// Draw W01 WORD_HELLO bitmap on the screen
//  display.drawBitmap(0, 0, image_data_WORD_HELLOarray, 128, 64, 1);
  display.display();
}

 
void loop() {
 
// Clear the buffer.
  display.clearDisplay();
 switch
// Draw 21 EYES_SLEEP bitmap on the screen
//  display.drawBitmap(0, 0, image_data_EYES_SLEEParray, 128, 64, 1);
//  display.display();

  delay(2000); // Pause for 2 seconds

// Clear the buffer.
  display.clearDisplay();

// Draw 23 EYES_TIRED bitmap on the screen
  display.drawBitmap(0, 0, image_data_EYES_TIREDarray, 128, 64, 1);
  display.display();  

  delay(2000); // Pause for 2 seconds

// Clear the buffer.
  display.clearDisplay();

// Draw 05 EYES_CROSSED Eyes bitmap on the screen
  display.drawBitmap(0, 0, image_data_EYES_CROSSEDarray, 128, 64, 1);
  display.display(); 

  delay(2000); // Pause for 2 seconds

// Clear the buffer.
  display.clearDisplay();

// Draw 01 EYES_FRONT bitmap on the screen
  display.drawBitmap(0, 0, image_data_EYES_FRONTarray, 128, 64, 1);
  display.display(); 

  delay(2000); // Pause for 2 seconds

// Clear the buffer.
  display.clearDisplay();

 // Draw 08 EYES_RIGHT bitmap on the screen
  display.drawBitmap(0, 0, image_data_EYES_RIGHTarray, 128, 64, 1);
  display.display(); 

  delay(1000); // Pause for 1 second

// Clear the buffer.
  display.clearDisplay();

// Draw 01 EYES_FRONT bitmap on the screen
  display.drawBitmap(0, 0, image_data_EYES_FRONTarray, 128, 64, 1);
  display.display(); 

  delay(1000); // Pause for 1 second
  
// Clear the buffer.
  display.clearDisplay();

// Draw 08 EYES_LEFT bitmap on the screen
  display.drawBitmap(0, 0, image_data_EYES_LEFTarray, 128, 64, 1);
  display.display(); 

  delay(1000); // Pause for 1 second

// Clear the buffer.
  display.clearDisplay();

// Draw 01 EYES_FRONT bitmap on the screen
  display.drawBitmap(0, 0, image_data_EYES_FRONTarray, 128, 64, 1);
  display.display(); 

  delay(1000); // Pause for 1 second

// Clear the buffer.
  display.clearDisplay();

// Draw 03 EYES_NARROW bitmap on the screen
  display.drawBitmap(0, 0, image_data_EYES_NARROWarray, 128, 64, 1);
  display.display(); 

  delay(500); // Pause for 0.5 seconds

// Clear the buffer.
  display.clearDisplay();

// Draw 01 EYES_FRONT bitmap on the screen
  display.drawBitmap(0, 0, image_data_EYES_FRONTarray, 128, 64, 1);
  display.display(); 

  delay(1000); // Pause for 1 seconds     

// Clear the buffer.
  display.clearDisplay();

// Draw 18 EYES_GLARE bitmap on the screen
  display.drawBitmap(0, 0, image_data_EYES_GLAREarray, 128, 64, 1);
  display.display(); 

  delay(2000); // Pause for 2 seconds

// Clear the buffer.
  display.clearDisplay();

// Draw 19 EYES_MAD bitmap on the screen
  display.drawBitmap(0, 0, image_data_EYES_MADarray, 128, 64, 1);
  display.display(); 

  delay(2000); // Pause for 2 seconds

// Clear the buffer.
  display.clearDisplay();

// Draw 17 EYES_DISTRESSED bitmap on the screen
  display.drawBitmap(0, 0, image_data_EYES_DISTRESSEDarray, 128, 64, 1);
  display.display(); 

  delay(2000); // Pause for 2 seconds

// Clear the buffer.
  display.clearDisplay();

// Draw 16 EYES_CRY bitmap on the screen
  display.drawBitmap(0, 0, image_data_EYES_CRYarray, 128, 64, 1);
  display.display(); 

  delay(2000); // Pause for 2 seconds

// Clear the buffer.
  display.clearDisplay();

// Draw 20 EYES_GLASSES bitmap on the screen
  display.drawBitmap(0, 0, image_data_EYES_GLASSESarray, 128, 64, 1);
  display.display(); 

  delay(2000); // Pause for 2 seconds

// Clear the buffer.
  display.clearDisplay();

// Draw 05 EYES_CROSSED bitmap on the screen
  display.drawBitmap(0, 0, image_data_EYES_CROSSEDarray, 128, 64, 1);
  display.display(); 

  delay(2000); // Pause for 2 seconds

// Clear the buffer.
  display.clearDisplay();

// Draw 07 EYES_UP bitmap on the screen
  display.drawBitmap(0, 0, image_data_EYES_UParray, 128, 64, 1);
  display.display(); 

  delay(300); // Pause for 0.3 seconds

// Clear the buffer.
  display.clearDisplay();

// Draw 10 EYES_RIGHT_UP bitmap on the screen
  display.drawBitmap(0, 0, image_data_EYES_RIGHT_UParray, 128, 64, 1);
  display.display(); 

  delay(300); // Pause for 0.3 seconds

// Clear the buffer.
  display.clearDisplay();

// Draw 08 EYES_RIGHT bitmap on the screen
  display.drawBitmap(0, 0, image_data_EYES_RIGHTarray, 128, 64, 1);
  display.display(); 

  delay(300); // Pause for 0.3 seconds

// Clear the buffer.
  display.clearDisplay();

// Draw 09 EYES_RIGHT_DOWN bitmap on the screen
  display.drawBitmap(0, 0, image_data_EYES_RIGHT_DOWNarray, 128, 64, 1);
  display.display(); 

  delay(300); // Pause for 0.3 seconds

// Clear the buffer.
  display.clearDisplay();

// Draw 06 EYES_DOWN bitmap on the screen
  display.drawBitmap(0, 0, image_data_EYES_DOWNarray, 128, 64, 1);
  display.display(); 

  delay(300); // Pause for 0.3 seconds

// Clear the buffer.
  display.clearDisplay();

// Draw 12 EYES_LEFT_DOWN bitmap on the screen
  display.drawBitmap(0, 0, image_data_EYES_LEFT_DOWNarray, 128, 64, 1);
  display.display(); 

  delay(300); // Pause for 0.3 seconds

// Clear the buffer.
  display.clearDisplay();

// Draw 11 EYES_LEFT bitmap on the screen
  display.drawBitmap(0, 0, image_data_EYES_LEFTarray, 128, 64, 1);
  display.display(); 

  delay(300); // Pause for 0.3 seconds

// Clear the buffer.
  display.clearDisplay();

// Draw 12 EYES_LEFT_UP bitmap on the screen
  display.drawBitmap(0, 0, image_data_EYES_LEFT_UParray, 128, 64, 1);
  display.display(); 

  delay(300); // Pause for 0.3 seconds

// Clear the buffer.
  display.clearDisplay();

// Draw 07 EYES_UP bitmap on the screen
  display.drawBitmap(0, 0, image_data_EYES_UParray, 128, 64, 1);
  display.display(); 

  delay(1000); // Pause for 1 second

// Clear the buffer.
  display.clearDisplay();

// Draw 01 EYES_FRONT bitmap on the screen
  display.drawBitmap(0, 0, image_data_EYES_FRONTarray, 128, 64, 1);
  display.display(); 

  delay(1500); // Pause for 1.5 seconds

// Clear the buffer.
  display.clearDisplay();

// Draw 14 CONFUSSED_1 bitmap on the screen
  display.drawBitmap(0, 0, image_data_CONFUSSED_1array, 128, 64, 1);
  display.display(); 

  delay(500); // Pause for 0.5 seconds

// Clear the buffer.
  display.clearDisplay();

// Draw 01 EYES_FRONT bitmap on the screen
  display.drawBitmap(0, 0, image_data_EYES_FRONTarray, 128, 64, 1);
  display.display(); 

  delay(300); // Pause for 0.3 seconds

// Clear the buffer.
  display.clearDisplay();

// Draw 15 CONFUSSED_2 bitmap on the screen
  display.drawBitmap(0, 0, image_data_CONFUSSED_2array, 128, 64, 1);
  display.display(); 

  delay(500); // Pause for 0.5 seconds

// Clear the buffer.
  display.clearDisplay();

// Draw 01 EYES_FRONT bitmap on the screen
  display.drawBitmap(0, 0, image_data_EYES_FRONTarray, 128, 64, 1);
  display.display(); 

  delay(1300); // Pause for 1.3 seconds

// Clear the buffer.
  display.clearDisplay();

// Draw 03 EYES_NARROW bitmap on the screen
  display.drawBitmap(0, 0, image_data_EYES_NARROWarray, 128, 64, 1);
  display.display(); 

  delay(500); // Pause for 0.5 seconds

// Clear the buffer.
  display.clearDisplay();

// Draw 22 BLINK_UPPER bitmap on the screen
  display.drawBitmap(0, 0, image_data_BLINK_UPPERarray, 128, 64, 1);
  display.display(); 

  delay(1000); // Pause for 1 seconds

// Clear the buffer.
  display.clearDisplay();

// Draw 24 EYES_NIGHT bitmap on the screen
  display.drawBitmap(0, 0, image_data_EYES_NIGHTarray, 128, 64, 1);
  display.display(); 

  delay(1000); // Pause for 1 seconds

// Clear the buffer.
  display.clearDisplay();

// Draw 25 UPPER_LIDS bitmap on the screen
  display.drawBitmap(0, 0, image_data_UPPER_LIDSarray, 128, 64, 1);
  display.display(); 

  delay(1000); // Pause for 1 seconds

// Clear the buffer.
  display.clearDisplay();

// Draw 23 EYES_TIRED bitmap on the screen
  display.drawBitmap(0, 0, image_data_EYES_TIREDarray, 128, 64, 1);
  display.display(); 

  delay(2000); // Pause for 2 seconds

// Clear the buffer.
  display.clearDisplay();

// Draw 26 LOWER_LIDS bitmap on the screen
  display.drawBitmap(0, 0, image_data_LOWER_LIDSarray, 128, 64, 1);
  display.display(); 

  delay(2000); // Pause for 2 seconds

// Clear the buffer.
  display.clearDisplay();

// Draw 19 EYES_MAD bitmap on the screen
  display.drawBitmap(0, 0, image_data_EYES_MADarray, 128, 64, 1);
  display.display(); 

  delay(2000); // Pause for 2 seconds

// Clear the buffer.
  display.clearDisplay();

// Draw W03 WHAT_WORD bitmap on the screen
  display.drawBitmap(0, 0, image_data_WHAT_WORDarray, 128, 64, 1);
  display.display(); 

  delay(2000); // Pause for 2 seconds

// Clear the buffer.
  display.clearDisplay();

// Draw W02 WORD_BYE bitmap on the screen
  display.drawBitmap(0, 0, image_data_WORD_BYEarray, 128, 64, 1);
  display.display(); 

  delay(3000); // Pause for 3 seconds 
}

//  End of Sketch  





static const unsigned char PROGMEM image_data_WORD_HELLOarray[] = { 
  // W01 ARRAY for WORD_HELLO
  0x00, 0x00, 0x00, 0x00, 0x00, 0x00, 0x00, 0x00, 0x00, 0x00, 0x00, 0x00, 0x00, 0x00, 0x00, 0x00, 
  0x00, 0x00, 0x00, 0x00, 0x00, 0x00, 0x00, 0x00, 0x00, 0x00, 0x00, 0x00, 0x00, 0x00, 0x00, 0x00, 
  0x00, 0x00, 0x00, 0x00, 0x00, 0x00, 0x00, 0x00, 0x00, 0x00, 0x00, 0x00, 0x00, 0x00, 0x00, 0x00, 
  0x00, 0x00, 0x00, 0x00, 0x00, 0x00, 0x00, 0x00, 0x00, 0x00, 0x00, 0x00, 0x00, 0x00, 0x00, 0x00, 
  0x00, 0x00, 0x00, 0x00, 0x00, 0x00, 0x00, 0x00, 0x00, 0x00, 0x00, 0x00, 0x00, 0x00, 0x00, 0x00, 
  0x00, 0x00, 0x00, 0x00, 0x00, 0x00, 0x00, 0x00, 0x00, 0x00, 0x00, 0x00, 0x00, 0x00, 0x00, 0x00, 
  0x00, 0x00, 0x00, 0x00, 0x00, 0x00, 0x00, 0x00, 0x00, 0x00, 0x00, 0x00, 0x00, 0x00, 0x00, 0x00, 
  0x00, 0x00, 0x00, 0x00, 0x00, 0x00, 0x00, 0x00, 0x00, 0x00, 0x00, 0x00, 0x00, 0x00, 0x00, 0x00, 
  0x00, 0x00, 0x00, 0x00, 0x00, 0x00, 0x00, 0x00, 0x00, 0x00, 0x00, 0x00, 0x00, 0x00, 0x00, 0x00, 
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
  0x00, 0x00, 0x00, 0x00, 0x00, 0x00, 0x00, 0x00, 0x00, 0x00, 0x00, 0x00, 0x00, 0x00, 0x00, 0x00, 
  0x00, 0x00, 0x00, 0x00, 0x00, 0x00, 0x00, 0x00, 0x00, 0x00, 0x00, 0x00, 0x00, 0x00, 0x00, 0x00, 
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
};
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
